armpitpete/merrin-voice-01/docs/v5.2-prototype-a-schematic-sheet-plan.md

# V5.2 — Prototype A Schematic Sheet Plan

## Status

Draft schematic-capture plan.

## Purpose

Define a hierarchical schematic structure that preserves the accepted V5.1 signal flow, safety boundaries, SMD-first construction, and Thonkiconn requirements.

This document does not create PCB placement or routing authority.

## Schematic hierarchy

```text
00_TOP
├── 01_POWER_PROTECTION
├── 02_MCU_CLOCK_DEBUG
├── 03_CODEC_CONVERSION
├── 04_INPUT_PRESSURE_ABSENCE
├── 05_MEMORY_GHOST_WET
├── 06_RETURN_BREAK_LIMITER
├── 07_OUTPUT_MUTE_PROTECTION
├── 08_CONTROLS_STATE
└── 09_TEST_SERVICE
```

Each child sheet must have one clear responsibility.

Cross-sheet connections must use explicit hierarchical labels. Hidden global labels are limited to power rails, ground/reference nets, reset/fault nets, and the audio clocks.

## 00_TOP — System hierarchy

### Purpose

- show the complete signal direction
- instantiate every functional sheet
- make safety paths visible
- show external connectors and top-level controls

### Top-level external ports

```text
AUDIO_IN
AUDIO_OUT
+12V_IN
-12V_IN
0V
RESET_CLEAR
SAFE_MUTE
STATE_LED
SWDIO
SWCLK
NRST
```

### Mandatory visible top-level signal route

```text
AUDIO_IN
  ↓
INPUT / PRESSURE / ABSENCE
  ├── PRESENT_DIRECT
  └── MEMORY_SUM → CODEC_ADC → DIGITAL CORE
                              ├── MEMORY_DAC
                              ├── GHOST_DAC
                              └── RETURN_DAC → BREAK / RETURN / LIMITER
                                                ├── RETURN_LIMITED → MEMORY_SUM
                                                └── ABSENCE_INFLUENCE
PRESENT_DIRECT + MEMORY/GHOST WET
  ↓
OUTPUT / SAFE MUTE
  ↓
AUDIO_OUT
```

The top sheet must not imply any raw Return bypass.

## 01_POWER_PROTECTION

### Purpose

Create and supervise the Prototype A power domains.

### Selected major parts

- TPS62160 for approximately 5.5 V pre-regulation
- TPS7A2050 for quiet 5 V codec analogue supply
- TPS62160 for 3.3 V digital supply
- TPS3808G33 supervisor
- TPS3431 watchdog

### Input rails

```text
+12V_RAW
-12V_RAW
0V
```

### Output rails

```text
+12VA
-12VA
+5V_CODEC_A
+3V3_D
+3V3_CODEC_D
```

`+3V3_CODEC_D` may be a filtered branch of `+3V3_D`; it is not a separately regulated rail unless schematic analysis requires it.

### Safety/control outputs

```text
PWR_GOOD_N
WATCHDOG_FAULT_N
SYSTEM_FAULT_N
HW_ATTENUATE
CODEC_RESET_N
MCU_RESET_N
```

### Required design details

- reverse-polarity protection
- supply-entry filtering
- regulator enable states
- current-limit-compatible bench bring-up
- local bulk capacitance
- regulator compensation/magnetics
- supervisor delay network
- independent watchdog timing network
- open-drain fault combination or equivalent safe logic
- labelled test points for every rail

### ERC rules

- no power-output conflict between regulators
- all regulator grounds/reference pins explicitly connected
- no unpowered logic input through a higher-voltage domain
- fault outputs have defined pull state
- no floating enable/reset pins

## 02_MCU_CLOCK_DEBUG

### Purpose

Implement STM32H743VIT6 processing, control, clocks, reset, and debug.

### Major part

```text
STM32H743VIT6 — LQFP-100
```

### Required interfaces

```text
SAI/TDM TX
SAI/TDM RX
MCLK
BCLK
LRCLK
CODEC_CTRL bus
MCP4728 I2C
CONTROL_ADC inputs
RESET_CLEAR input
SAFE_MUTE input
STATE_LED outputs
WATCHDOG_HEARTBEAT
CODEC_RESET_N
CODEC_MUTE
SWDIO
SWCLK
NRST
```

### Clocking

- HSE crystal/oscillator circuit selected during schematic capture
- MCU audio PLL generates audio clocks
- 48 kHz audio rate
- preferred 24.576 MHz MCLK, subject to codec clock-table verification
- 12.288 MHz BCLK for eight 32-bit TDM slots
- 48 kHz LRCLK

### Memory documentation note

Add a schematic note:

```text
2.0 s × 48 kHz × 32-bit mono = 384,000-byte AXI SRAM history buffer.
No external audio RAM on Prototype A.
```

### Required support

- all VDD/VSS pins shown or correctly represented in multi-unit symbol
- decoupling at every supply pin group
- VCAP capacitors per official MCU requirements
- VDDA/VREF handling explicit
- BOOT configuration explicit
- NRST supervisor/manual path explicit
- SWD connector/header
- watchdog heartbeat test point
- spare debug UART pads allowed as service-only, not panel I/O

### ERC rules

- no hidden unpowered MCU supply pins
- all boot/config pins have defined states
- unused GPIOs handled deliberately
- no 5 V signal reaches a non-tolerant MCU pin

## 03_CODEC_CONVERSION

### Purpose

Implement PCM3168A conversion, clocking, digital control, analogue biasing, and reconstruction/anti-alias boundaries.

### Major part

```text
PCM3168A — HTQFP-64
```

### Functional channel map

| Function | Assigned logical channel |
|---|---|
| ADC ingress | ADC1 |
| Memory output | DAC1 |
| Ghost output | DAC2 |
| Return send | DAC3 |

Exact left/right physical channel assignments must be stated in the schematic notes.

### Digital interfaces

```text
MCLK
BCLK
LRCLK
TDM_DOUT_TO_MCU
TDM_DIN_FROM_MCU
CODEC_CTRL
CODEC_RESET_N
CODEC_MUTE
```

### Analogue interfaces

```text
ADC_INGRESS_BIASED
MEMORY_DAC_RAW
GHOST_DAC_RAW
RETURN_DAC_RAW
CODEC_VCOM
```

### Required analogue sub-blocks

- ADC anti-alias and level/bias interface
- DAC reconstruction filter for Memory
- DAC reconstruction filter for Ghost
- DAC reconstruction filter for Return send
- AC coupling/0 V translation into ±12 V analogue domain
- local quiet 5 V analogue filtering
- local 3.3 V digital decoupling

### Unused-channel rule

Every unused ADC/DAC input/output is placed in the datasheet-defined safe state and documented.

No unused analogue input may float.

### ERC rules

- analogue and digital supply pins use correct power flags
- VCOM is not treated as a general system reference
- no ±12 V net directly reaches a codec pin
- reset/mute defaults are safe

## 04_INPUT_PRESSURE_ABSENCE

### Purpose

Implement the zero-centred analogue input path and produce both direct Present and Memory ingress.

### Major parts

- WQP518MA input Thonkiconn
- OPA1679 stages
- protection components selected during schematic work

### Signal path

```text
J1 AUDIO IN
  ↓
INPUT_PROTECTED
  ↓
INPUT_TRIMMED
  ↓
PRESSURE_OUT
  ↓
ABSENCE_OUT / SHAPED_PRESENT
  ├── PRESENT_DIRECT
  └── MEMORY_SUM
```

### Return input

```text
RETURN_LIMITED → MEMORY_SUM
```

No other Return net is permitted on this sheet.

### Controls

```text
INPUT_TRIM_POT
PRESSURE_POT
ABSENCE_POT
ABSENCE_INFLUENCE
```

### Mandatory test points

```text
TP_IN
TP_TRIM
TP_PRS
TP_ABS
TP_SUM
TP_ADCMON
```

### ERC/safety rules

- no floating input when J1 is empty
- switched contact behavior shown explicitly
- input protection survives the accepted ±12 V condition
- `RETURN_LIMITED` enters only through a bounded summing impedance
- `ABSENCE_INFLUENCE` cannot drive the Absence stage outside its safe control range

## 05_MEMORY_GHOST_WET

### Purpose

Receive reconstructed Memory and Ghost outputs, control their analogue levels, and create the wet mix.

### Major parts

- SSI2164 channels 1, 2, and 4
- MCP4728 channels A, B, and D
- OPA1679 reconstruction/mix stages as required

### Inputs

```text
MEMORY_DAC_RAW
GHOST_DAC_RAW
MCP_DAC_MEM
MCP_DAC_GHOST
MCP_DAC_WET
HW_ATTENUATE
```

### Outputs

```text
MEMORY_ANALOG
GHOST_ANALOG
WET_MIX
```

### Safety rule

`HW_ATTENUATE` must force all wet-related VCA channels to the datasheet-defined maximum attenuation without MCU participation.

### Mandatory test points

```text
TP_MEM
TP_GHOST
TP_WET
TP_VCA_MEM_CTRL
TP_VCA_GHOST_CTRL
TP_VCA_WET_CTRL
```

### ERC rules

- DAC control outputs never exceed SSI2164 control-input limits after scaling
- hardware attenuation clamp cannot be overridden by MCP4728 or MCU
- unused SSI2164 channels do not float

## 06_RETURN_BREAK_LIMITER

### Purpose

Implement the only legal path from Return DAC output back to Memory and Absence.

### Major parts

- SSI2164 channel 3
- MCP4728 channel C
- OPA1679 stages
- Break/nonlinear/limiter devices selected during schematic capture

### Mandatory path

```text
RETURN_DAC_RAW
  ↓
RETURN_LEVELLED
  ↓
BREAK_OUT
  ↓
RETURN_NONLINEAR
  ↓
RETURN_LIMITED
  ├── RETURN_FEED_TO_SUM
  └── ABSENCE_INFLUENCE
```

### Forbidden nets

The following direct paths are forbidden:

```text
RETURN_DAC_RAW → MEMORY_SUM
BREAK_OUT → MEMORY_SUM
RETURN_NONLINEAR → MEMORY_SUM
```

Only `RETURN_LIMITED` may leave the safety boundary.

### Mandatory test points

```text
TP_RETSEND
TP_BREAK
TP_RETURN_NONLINEAR
TP_RETLIM
TP_RETURN_CTRL
TP_ABSCTRL
```

### Safety notes

The schematic must contain a visible note:

```text
Normal maximum small-signal loop target ≈ 0.85.
Complete Return loop must remain bounded.
```

The limiter must remain effective during MCU/codec faults.

### ERC rules

- `HW_ATTENUATE` reaches Return VCA/clamp
- Return level control has a defined power-up state
- limiter rails/references remain powered when digital core faults
- `RETURN_LIMITED` is the only exported feedback-audio net

## 07_OUTPUT_MUTE_PROTECTION

### Purpose

Combine Present and wet paths, provide output level, suppress transients, and drive the output Thonkiconn.

### Major parts

- OPA1679 mix/output stages
- WQP518MA output Thonkiconn
- hardware mute/protection devices selected during schematic capture

### Signal path

```text
PRESENT_DIRECT
WET_MIX
  ↓
FINAL_MIX
  ↓
OUTPUT_LEVEL
  ↓
OUTPUT_SAFE
  ↓
J2 AUDIO OUT
```

### Control inputs

```text
SAFE_MUTE
SYSTEM_FAULT_N
```

### Mandatory test points

```text
TP_MIX
TP_OUT_PREMUTE
TP_OUT
TP_MUTE
```

### Safety rules

- normal output no greater than 10 Vpp
- known muted or controlled state at power-on
- controlled release avoids full-scale click
- output remains protected against reasonable patching faults
- output Thonkiconn sleeve follows the documented analogue-ground strategy

## 08_CONTROLS_STATE

### Purpose

Connect panel controls, MCP4728, buttons, and SLS-1 indication.

### Major parts

- MCP4728 — MSOP-10
- control pots and switches
- state LED drivers/components

### MCU-scanned controls

```text
MEM_TIME
MEM_FADE
MEM_BLUR
GHOST_DISTANCE
GHOST_DRIFT
GHOST_PRESENCE
RETURN_AMOUNT
PRESENT_WET
```

### Direct analogue controls

```text
INPUT_TRIM
PRESSURE
ABSENCE
BREAK
OUTPUT_LEVEL
```

### Digital controls

```text
RESET_CLEAR
SAFE_MUTE
```

### MCP4728 allocation

| Channel | Function |
|---|---|
| A | Memory level |
| B | Ghost level |
| C | Return level |
| D | Wet master |

### SLS-1 states

```text
IDLE
ACTIVE
WARNING
ERROR
```

### Safety rules

- MCP4728 cannot release hardware attenuation before SAFE-01 permits it
- stored DAC values must not create an unsafe power-up state
- pots have defined ADC states if disconnected
- LED meaning does not rely on colour alone

## 09_TEST_SERVICE

### Purpose

Collect service headers, test points, current measurement options, and bring-up notes without exposing them as performance controls.

### Required access

```text
all V5.1 analogue test points
+12VA
-12VA
+5V_CODEC_A
+3V3_D
3V3_CODEC_D
SYSTEM_FAULT_N
WATCHDOG_FAULT_N
PWR_GOOD_N
HW_ATTENUATE
CODEC_RESET_N
MCU_RESET_N
MCLK
BCLK
LRCLK
```

### Service connectors

- SWD header
- optional debug UART pads
- current-measurement links or zero-ohm options for major power branches
- codec control-bus probe pads
- watchdog heartbeat probe pad

These are not panel functions.

## Net-naming rules

### Audio

```text
AUDIO_IN_RAW
INPUT_PROTECTED
INPUT_TRIMMED
PRESSURE_OUT
SHAPED_PRESENT
PRESENT_DIRECT
MEMORY_SUM
ADC_INGRESS
MEMORY_DAC_RAW
GHOST_DAC_RAW
RETURN_DAC_RAW
MEMORY_ANALOG
GHOST_ANALOG
WET_MIX
BREAK_OUT
RETURN_NONLINEAR
RETURN_LIMITED
FINAL_MIX
OUTPUT_SAFE
```

### Control/safety

```text
ABSENCE_INFLUENCE
HW_ATTENUATE
SAFE_MUTE
SYSTEM_FAULT_N
PWR_GOOD_N
WATCHDOG_FAULT_N
CODEC_RESET_N
CODEC_MUTE
MCU_RESET_N
RESET_CLEAR
```

### Clocks/buses

```text
AUDIO_MCLK
AUDIO_BCLK
AUDIO_LRCLK
AUDIO_TDM_TX
AUDIO_TDM_RX
CODEC_CTRL
CTRL_I2C_SCL
CTRL_I2C_SDA
```

## Symbol and footprint gates

Before a symbol is accepted:

- pin numbers checked against official datasheet
- all power/ground pins accounted for
- exposed pad behavior documented
- active-low names use `_N`
- multi-unit parts have explicit power unit where needed

Before a footprint is associated:

- package drawing checked against official manufacturer drawing
- pin-1 orientation checked
- thermal/exposed pad checked
- courtyard and assembly clearances reviewed
- hand/reflow assembly method stated

For WQP518MA:

- exact switched-contact pins verified
- footprint dimensions checked against the current manufacturer drawing
- panel axis and nut clearance recorded

## ERC acceptance rules

ERC must pass with no unexplained:

- unconnected required pins
- power-input-without-source warnings
- output-to-output conflicts
- floating analogue inputs
- unpowered logic/control pins
- unnamed feedback paths
- active-low reset nets without defined pull state

Intentional exceptions must be recorded in a schematic review note, not silently excluded.

## Schematic review order

Review in this sequence:

1. power and reset
2. MCU/clock/debug
3. codec supplies and clocks
4. input and direct Present path
5. converter boundaries
6. Memory/Ghost wet path
7. Return/Break/limiter path
8. output mute/protection
9. controls and LEDs
10. test/service access
11. whole-system ERC
12. independent Return-safety review

## Stop rule

Schematic capture is not accepted until:

```text
[ ] all sheets exist
[ ] every hierarchical port is connected once in the intended direction
[ ] direct Present works without the digital core
[ ] only RETURN_LIMITED feeds Memory/Absence
[ ] hardware attenuation is independent of firmware
[ ] codec clock mode is verified
[ ] power-up/reset sequence is explicit
[ ] all exact packages/footprints are verified
[ ] ERC passes with documented exceptions only
```

PCB placement and routing remain forbidden until this review is complete.
