armpitpete/merrin-voice-01/hardware/memory-core-prototype-a/00_TOP_FINAL_INTEGRATED_REVIEW.md

# 00_TOP — Final Integrated Schematic Review

## Status

```text
ALL NINE COMPONENT SHEETS CAPTURED: PASS
PARENT / CHILD INTERFACE RECONCILIATION: PASS
45-NET PROVIDER / CONSUMER COVERAGE: PASS
RESTRICTED SHEET BOUNDARIES: PASS
SHARED U60 / U32 DEVICE OWNERSHIP: PASS
TEMPORARY HARNESS REMOVAL: PASS
KICAD 10 HIERARCHICAL ERC: PASS — 0 ERRORS / 0 WARNINGS
FIRST PASSING FINAL ARTIFACT PROMOTED: PASS
COMMITTED-FILE FINAL RERUN: PASS — RECONCILIATION / PROMOTION SKIPPED
PR #45 SCHEMATIC ACCEPTANCE REVIEW: COMPLETE
PCB / FOOTPRINT / FABRICATION AUTHORITY: NOT GRANTED
```

## Review scope

This review closes the V5.2 native component-level schematic-capture lane only. It does not accept footprints, placement, routing, fabrication, purchasing, panel mechanics, fixtures or measured hardware behaviour.

Reviewed hierarchy:

```text
00_TOP
├── 01_POWER_PROTECTION
├── 02_MCU_CLOCK_DEBUG
├── 03_CODEC_CONVERSION
├── 04_INPUT_PRESSURE_ABSENCE
├── 05_MEMORY_GHOST_WET
├── 06_RETURN_BREAK_LIMITER
├── 07_OUTPUT_MUTE_PROTECTION
├── 08_CONTROLS_STATE
└── 09_TEST_SERVICE
```

All nine component-sheet capture markers are present.

## Parent and child interface reconciliation

The final review found that the pinned schematic API had serialised several early child-sheet output and bidirectional labels as `input`, even though the top-level sheet pins and manifest were correct.

The passing final artifact repairs only the named hierarchy shapes on:

```text
01_POWER_PROTECTION        5 labels
02_MCU_CLOCK_DEBUG        14 labels
04_INPUT_PRESSURE_ABSENCE  3 labels
08_CONTROLS_STATE         16 labels
```

After repair:

- every top-level sheet pin matches the committed manifest;
- every child hierarchical label matches the same name and direction;
- each hierarchy label is unique within its sheet;
- all 45 hierarchy nets have at least one provider and at least one consumer.

## Restricted boundaries

The final validator explicitly enforces:

```text
04 outputs: DIRECT_PRESENT, SHAPED_PRESENT, ADC_ANALOG_IN
05 outputs: WET_MIX only
06 outputs: RETURN_LIMITED, RETURN_FEED, ABSENCE_INFLUENCE only
07 outputs: none
09 outputs: none
```

Raw Return, Break, clamp, SSI2164 current, wet-sum, mute, output-protection and service-probe nodes remain local to their owning sheets.

## Shared physical devices

The reusable validators passed the integrated multi-unit ownership contracts:

```text
U60 / SSI2164
  sheet 05: units 1, 2, 4
  sheet 06: units 3, 5
  one physical five-unit device

U32 / OPA1679
  sheet 03: units 1, 5
  sheet 07: units 2, 3, 4
  one physical five-unit device
```

The complete Prototype A OPA1679 allocation remains seven physical packages. No duplicate U60 or U32 package is created.

## Temporary-harness closure

The final validator rejects:

```text
SHEET_INTERFACE_NOT_FITTED
Temporary hierarchy/ERC harness
INTERFACE CAPTURE ONLY
former J901–J909 harness references
visible staged SSI2164 reservations
```

No such token or former harness reference remains in the top schematic or any child sheet.

The top schematic now states that all nine component sheets are captured. The hierarchy manifest now records:

```text
stage: component-capture-complete
temporary_interface_harnesses: false
component_sheets_captured: true
```

## Integrated Return safety review

Static schematic-stage Return safeguards remain intact:

- post-codec Return gain is normalised by the sheet-06 one-third divider;
- U60 channel 3 retains official pins `15 IIN3`, `14 VC3`, `13 IOUT3`;
- bounded Break and independent dual-polarity limiter remain before `RETURN_LIMITED`;
- `RETURN_FEED` remains a fixed `27.4 kΩ / 40.2 kΩ` branch;
- sheet 04 accepts only `RETURN_FEED` and `ABSENCE_INFLUENCE` from sheet 06;
- raw Return, Break, clamp and limiter-reference nodes remain local;
- sheet 07 receives `WET_MIX`, not an unbounded internal Return node;
- sheet 09 observes Return signals only through read-only isolated probes.

This is a static schematic review. Measured loop gain, limiter thresholds and recovery, worst-setting endurance, fault response and output behaviour remain mandatory later bench gates.

## Verification evidence

The final integrated workflow passed:

- all reusable component-sheet validators;
- U60 and U32 shared-device validators;
- provisional control-symbol validators;
- test/service read-only boundary validator;
- parent-sheet and child-label reconciliation;
- provider/consumer coverage for all 45 hierarchy nets;
- restricted output-boundary checks;
- temporary-harness removal checks;
- KiCad CLI `10.0.4` hierarchical ERC;
- final zero-error and zero-warning policy.

ERC result:

```text
0 errors
0 warnings
```

The first passing final-review artifact was promoted in commit `5d2b325`.

The required committed-file rerun subsequently detected `00_TOP_FINAL_REVIEW_COMPLETE`, skipped reconciliation and promotion, and passed all component and integration validators plus KiCad ERC directly against the committed native files.

## Validation boundary

The final gate proves native hierarchy, interface direction, shared-device ownership, selected design contracts and KiCad ERC. It does not prove exact analogue behaviour, component spread, rail sequencing, mute depth, loop stability, load drive, external-fault current or endurance.

Those transferred exact-part, footprint and bench gates are recorded in `PR45_SCHEMATIC_ACCEPTANCE_REVIEW.md`.

## Remaining blocked work

- every active-device and connector footprint review;
- PCB placement and routing;
- fabrication outputs and purchasing;
- panel, jack, control and service-fixture mechanics;
- measured power, codec, VCA, Return, limiter, mute and output performance;
- integrated loop stability and endurance testing;
- firmware resource, timing, register and fault-sequence proof;
- oscillator, voice-source, MIDI/CV, sequencer and demo expansion.

`00_TOP` is closed at schematic-capture level. PR #45 is accepted as a reviewed prototype schematic candidate with a deliberate squash merge recommended after human review. Exact-part and footprint verification remains a separate later lane.
