armpitpete/merrin-voice-01/docs/v5.2-power-and-analogue-preflight-register.md

# V5.2 — Power and Analogue Preflight Register

## Status

Calculation pass complete for schematic preparation.

Footprint, native schematic, ERC and physical bench checks remain open.

PCB placement, routing, fabrication and purchasing remain blocked.

## Rail budget

| Rail | Locked design allocation | Status |
|---|---:|---|
| +12 V complete prototype input | 425 mA | Calculated for schematic preparation |
| −12 V complete prototype input | 110 mA | Calculated for schematic preparation |
| +12 V analogue core | 100 mA | Calculated for schematic preparation |
| −12 V analogue core | 100 mA | Calculated for schematic preparation |
| approximately 5.453 V pre-rail | 265 mA | Calculated for schematic preparation |
| quiet 5 V | 265 mA | Calculated for schematic preparation |
| 3.3 V | 500 mA | Calculated for schematic preparation |

Evidence:

- `docs/v5.2-power-current-and-thermal-budget.md`

## Regulator starting points

### 3.3 V rail

```text
RTOP = 374 kΩ
RBOTTOM = 120 kΩ
nominal VOUT = 3.293 V
L = 2.2 µH
CIN = 10 µF local minimum target
COUT = 22 µF effective target
at 500 mA:
  ΔIL ≈ 0.483 A
  IPEAK ≈ 0.741 A
  IVALLEY ≈ 0.259 A
```

### Quiet-5 V pre-rail

```text
RTOP = 698 kΩ
RBOTTOM = 120 kΩ
nominal VOUT = 5.453 V
L = 3.3 µH
CIN = 10 µF local minimum target
COUT = 22 µF effective target
at 265 mA:
  ΔIL ≈ 0.401 A
  IPEAK ≈ 0.465 A
  IVALLEY ≈ 0.065 A
```

The 3.3 µH correction prevents the first-pass quiet pre-rail calculation from crossing into discontinuous inductor current at the design load.

## Quiet 5 V LDO

```text
PCM3168A analogue maximum = 210 mA
design load = 265 mA
pre-rail = 5.453 V
LDO output = 5.000 V
headroom = 0.453 V
first-pass dissipation at 265 mA ≈ 0.120 W
first-pass junction-rise estimate ≈ 22.5 °C
```

Open before PCB acceptance:

- exact regulator-reference/tolerance check;
- capacitor DC-bias and inductor verification;
- copper-dependent thermal result;
- measured ripple/noise.

## ±12 V analogue current

```text
7 × OPA1679
28 channels
OPA current:
  typical = 56.0 mA per rail
  worst = 78.4 mA per rail
SSI2164 maximum ≈ 8 mA per rail
analogue-core allowance = 100 mA per rail
```

Evidence:

- `docs/v5.2-return-limiter-and-opamp-allocation.md`

## SSI2164 and MCP4728 safety

```text
SSI gain_dB ≈ −VC / 0.033 V
0 V = unity
+3.3 V ≈ maximum attenuation
negative VC forbidden
```

TMUX1574 selects:

```text
safe/default = +3.3 V attenuation reference
normal = MCP4728 output
```

MCP4728 safe EEPROM request:

```text
VREF = VDD
GAIN = 1
normal mode
all four codes = 0xFFF
```

The hardware selector remains authoritative.

Evidence:

- `docs/v5.2-ssi2164-mcp4728-fail-safe-control.md`
- `docs/v5.2-component-architecture-amendment-safe-selector.md`

## Return limiter

Corrected contract:

```text
combined small-signal gain from core Return source
through DAC-R, Break and analogue Return to RETURN_LIMITED
≤ 1.000
```

Hard boundary:

```text
RET-01
→ 2.2 kΩ
→ clamp to buffered ±2.5 V references
→ RETURN_LIMITED
→ fixed feed:
   RIN = 40.2 kΩ
   RF = 27.4 kΩ
   nominal = 0.6816
   1% worst-case ≈ 0.6954
```

Therefore calculated normal loop gain remains below 0.70 and below the accepted 0.85 ceiling.

Conservative headroom check:

```text
5.6 Vpp clamp × 0.6816 = 3.82 Vpp Return
3.82 Vpp Return + 2.00 Vpp Present = 5.82 Vpp
```

This stays below the 6 Vpp internal headroom target.

Evidence:

- `docs/v5.2-return-limiter-and-opamp-allocation.md`

Open:

- native gain table;
- measured clamp and loop gain;
- 30-minute worst-setting endurance.

## Watchdog and supervisor

```text
TPS3808 reset-delay target ≈ 300 ms nominal
TPS3431 watchdog target ≈ 200 ms nominal
TPS3431 window ≈ 170–230 ms
```

Interpretation:

```text
20 ms = asserted fault to suppression
not MCU-hang detection latency
```

Evidence:

- `docs/v5.2-supervisor-watchdog-and-thonkiconn-proof.md`
- `docs/v5.2-ssi2164-mcp4728-fail-safe-control.md`

## WQP518MA

Accepted electrically:

```text
pin 1 sleeve
pin 2 tip
pin 3 normally-connected tip switch
```

Open before PCB:

- native symbol/footprint cross-check;
- barrel keepout/hole;
- panel alignment and hardware stack;
- physical sample measurement.

## Schematic-preparation closure

```text
[x] Current and thermal targets explicit.
[x] Corrected regulator starting values explicit.
[x] OPA1679 package/current count explicit.
[x] SSI2164 safe range explicit.
[x] Hardware selector explicit.
[x] MCP4728 startup intent explicit.
[x] Watchdog timing distinction explicit.
[x] Corrected Return-loop calculation explicit.
[x] WQP518MA switching explicit.
```

Native hierarchical schematic capture may begin after this pass is accepted.

PCB work remains blocked until schematic/ERC, exact footprint checks, remaining risk closure and independent Return review are complete.
