armpitpete/merrin-voice-01/docs/v5.2-component-selection-risk-register.md

# V5.2 — Component-Selection Risk Register

## Status

Active schematic-preparation and pre-PCB register.

No closure in this file authorises PCB placement, routing, fabrication or purchasing.

## Current status

| Risk | Subject | Status |
|---|---|---|
| R1 | PCM3168A clock/configuration | **Closed for schematic preparation** |
| R2 | STM32 SRAM/DMA placement | Open — firmware evidence required |
| R3 | SSI2164 attenuation/range | **Closed for schematic preparation** |
| R4 | MCP4728 startup/EEPROM | **Closed for schematic preparation** |
| R5 | TPS3431 timing/package | Timing role conditional; footprint/assembly open |
| R6 | quiet-5 V rail margin | **Closed for schematic preparation** |
| R7 | 3.3 V current budget | **Closed for schematic preparation** |
| R8 | WQP518MA switching/footprint | Symbol/switching closed; footprint/mechanical open |
| R9 | OPA1679 count/current | **Closed for schematic preparation** |
| R10 | STM32H743 pin allocation | **Closed for schematic preparation** |
| R11 | unused PCM3168A channels | Digital state closed; analogue treatment open |
| R12 | Return limiter | Calculation closed; schematic/bench proof open |

## R1 — PCM3168A clock/configuration

Closed for schematic preparation.

```text
48 kHz LRCLK
12.288 MHz BCLK
24.576 MHz MCLK
8 × 32-bit TDM
PCM3168A address 0x44
```

Evidence:

- `docs/v5.2-pcm3168a-clock-and-interface-proof.md`
- `docs/v5.2-mcu-pin-and-codec-cross-check.md`

Bring-up must still prove generated SAI timing and codec register readback.

## R2 — STM32 SRAM/DMA placement

Open.

Required:

- reserve the 384,000-byte history explicitly;
- place DMA buffers in DMA-accessible SRAM;
- prove stack/heap/work buffers fit;
- retain at least 64 KB uncommitted margin after first complete link.

## R3 — SSI2164 safety

Closed for schematic preparation.

```text
gain_dB ≈ −VC / 0.033 V
0 V = unity
+3.3 V ≈ maximum attenuation
normal control range = 0 to +3.3 V
negative VC forbidden
```

TMUX1574 defaults the four SSI controls to +3.3 V and selects MCP4728 only after safe release.

Evidence:

- `docs/v5.2-ssi2164-mcp4728-fail-safe-control.md`
- `docs/v5.2-component-architecture-amendment-safe-selector.md`

## R4 — MCP4728 startup

Closed for schematic preparation.

Safe EEPROM request:

```text
VREF = VDD
GAIN = 1
normal mode
code = 0xFFF on all channels
```

The hardware selector remains authoritative; EEPROM is secondary.

## R5 — TPS3431 timing/package

Partially closed.

Accepted:

```text
TPS3431 = slower independent hang watchdog
nominal timeout ≈ 200 ms
published window ≈ 170–230 ms
20 ms requirement = asserted fault to suppression
```

Open before PCB:

- exact VSON land pattern;
- exposed-pad/stencil process;
- WDI/WDO test points;
- assembly functional test.

Evidence:

- `docs/v5.2-ssi2164-mcp4728-fail-safe-control.md`
- `docs/v5.2-supervisor-watchdog-and-thonkiconn-proof.md`

## R6 — quiet-5 V rail

Closed for schematic preparation.

```text
PCM3168A analogue maximum = 210 mA
design load = 265 mA
pre-rail nominal = 5.453 V
LDO output = 5.000 V
headroom = 0.453 V
first-pass LDO dissipation ≈ 0.120 W
first-pass temperature rise ≈ 22.5 °C
pre-regulator inductor = 3.3 µH
at design load:
  ΔIL ≈ 0.401 A
  IPEAK ≈ 0.465 A
  IVALLEY ≈ 0.065 A
```

The 3.3 µH correction keeps the first-pass quiet pre-rail in continuous conduction at the design load.

Open before PCB:

- exact regulator-reference tolerance;
- selected magnetics/capacitor derating;
- copper-dependent thermal check.

Evidence:

- `docs/v5.2-power-current-and-thermal-budget.md`

## R7 — 3.3 V rail

Closed for schematic preparation.

```text
calculated subtotal ≈ 371.6 mA
design load = 500 mA
RTOP = 374 kΩ
RBOTTOM = 120 kΩ
nominal VOUT = 3.293 V
L = 2.2 µH
at design load:
  ΔIL ≈ 0.483 A
  IPEAK ≈ 0.741 A
  IVALLEY ≈ 0.259 A
```

The MCU assumption is 300 MHz VOS2 and prototype ambient no higher than 85 °C without reopening R7.

## R8 — WQP518MA

Electrical symbol/switching closed for schematic preparation.

```text
pin 1 sleeve
pin 2 tip
pin 3 normally-connected tip switch
no plug: pins 2 and 3 connected
plug inserted: pins 2 and 3 open
```

Open before PCB:

- native symbol/footprint check against current manufacturer drawing;
- barrel keepout/hole;
- panel and nut/washer clearances;
- physical sample measurement.

An incomplete community library is reference-only.

## R9 — OPA1679 count/current

Closed for schematic preparation.

```text
7 × OPA1679
28 provisional assigned channels
56.0 mA per rail typical
78.4 mA per rail worst-case
```

Native schematic accounting must confirm the 28-channel plan. No extra package is authorised silently.

Evidence:

- `docs/v5.2-return-limiter-and-opamp-allocation.md`
- `docs/v5.2-power-current-and-thermal-budget.md`

## R10 — MCU pin allocation

Closed for schematic preparation.

```text
PE2–PE6   SAI1 audio
PB8/PB9   I2C1
PA0–PA7   panel ADC
PD8–PD15  safety/user controls
PC6–PC9   SLS-1
PH0/PH1   HSE
PA13/PA14 SWD
NRST       reset
```

Evidence:

- `docs/v5.2-mcu-pin-allocation-register.md`
- `docs/v5.2-mcu-pin-and-codec-cross-check.md`

## R11 — unused codec channels

Digital state closed; analogue treatment open.

- DAC4 zero/muted;
- DAC5–8 muted/power-save;
- ADC2 muted;
- ADC3–6 muted/power-save.

Native schematic must terminate unused analogue inputs correctly and prove no unused output reaches a mixer.

## R12 — Return limiter

Calculation closed for schematic preparation; schematic and bench proof open.

Corrected requirements:

```text
combined small-signal transfer from core Return source
through DAC-R, Break and analogue Return to RETURN_LIMITED
≤ 1.000
```

Hard boundary:

```text
RET-01
→ 2.2 kΩ
→ dual-polarity clamp to buffered ±2.5 V references
→ RETURN_LIMITED
→ fixed feed:
   RIN = 40.2 kΩ
   RF = 27.4 kΩ
   nominal = 0.6816
   1% worst-case ≈ 0.6954
```

SSI Return control cannot exceed unity, so calculated loop gain remains below 0.70 and below the accepted 0.85 ceiling.

Headroom check:

```text
5.6 Vpp clamp × 0.6816 = 3.82 Vpp Return
3.82 Vpp + 2.00 Vpp Present = 5.82 Vpp
```

This remains below the 6 Vpp internal target.

Open:

- native small-signal gain table;
- measured clamp/loop gain;
- 30-minute worst-setting endurance.

Evidence:

- `docs/v5.2-return-limiter-and-opamp-allocation.md`

## Closure gate before PCB work

```text
[x] R1  codec clock/configuration
[ ] R2  SRAM/DMA firmware placement
[x] R3  SSI2164 safety for schematic
[x] R4  MCP4728 startup for schematic
[~] R5  timing role accepted; footprint/assembly open
[x] R6  quiet-rail calculation
[x] R7  3.3 V budget
[~] R8  symbol/switch accepted; footprint/mechanical open
[x] R9  OPA count/current for schematic
[x] R10 MCU pin allocation
[~] R11 digital state closed; analogue treatment open
[~] R12 calculation closed; schematic/bench proof open
```

PCB placement and routing remain forbidden until all hardware-relevant open items are closed or transferred to a bounded pre-PCB verification task.
