armpitpete/merrin-voice-01/docs/v5.0-smd-construction-rule.md

# V5.0 — SMD Construction Rule

## Status

Locked hardware requirement.

## Core rule

Merrin Grief Synth circuit boards must use surface-mount electronic components by default.

```text
Electronic circuitry = SMD-first.
Panel and mechanical hardware = through-hole only where appropriate.
```

This rule applies to:

- Memory Core Prototype A
- later analogue Present-path boards
- Memory / Ghost / Return processing boards
- Absence / Pressure / Break circuitry
- control-scanning and state-light circuitry
- later internal voice-source boards
- production-intent revisions unless a documented exception is approved

## Locked jack choice

The default 3.5 mm audio/CV jack family is:

```text
Thonkiconn PCB-mount jack
```

This applies to Memory Core Prototype A and later Eurorack-style or patchable Merrin Grief Synth hardware.

Use Thonkiconns for:

- audio input
- audio output
- later CV input/output
- normalled or switched patch points where the circuit requires them

This locks the connector family and mechanical approach only.

It does not yet select:

- an exact manufacturer stock code
- an exact switched-contact variant
- an exact footprint
- an exact supplier

Those choices remain part of schematic/component selection.

Before PCB routing, the selected Thonkiconn variant must be checked for:

- verified footprint dimensions
- switched-contact pin behaviour
- jack orientation
- panel-hole alignment
- nut and washer clearance
- adjacent-control clearance
- insertion/removal mechanical load

A different jack may be used only when:

- the final physical format is not compatible with Thonkiconns
- a different connector is required for mechanical strength
- the circuit requires a connection type the chosen Thonkiconn cannot provide
- supply or manufacturing constraints make the part impractical

Any replacement must be documented rather than silently substituted.

## Why

SMD construction is the intended build method because it supports:

- compact circuit boards
- shorter signal paths
- repeatable assembly
- easier transition to assembled PCB production
- reduced dependence on large through-hole footprints
- realistic integration of digital audio, memory, conversion, and control circuitry

## Allowed through-hole exceptions

Through-hole parts are allowed where they are mechanically or practically superior.

Typical exceptions include:

- panel potentiometers
- Thonkiconn audio and CV jacks
- switches
- encoders
- power connectors
- board-to-panel connectors
- programming or service headers
- test points
- components requiring mechanical anchoring
- parts unavailable in a practical SMD package
- unusually high-power or high-heat parts where the circuit design justifies it

An exception must be based on engineering or repairability, not habit.

## Package-size principle

V5.0 does not select exact footprints yet.

When footprint selection begins, prefer SMD packages that remain realistic to prototype, inspect, and repair.

The design should not use unnecessarily tiny packages merely to reduce board size.

The later schematic/PCB lane must explicitly choose a buildability target, such as:

- hand-assembly friendly
- hot-plate/reflow friendly
- assembly-service friendly

Exact choices such as 0805, 0603, SOIC, TSSOP, QFN, or other packages remain deferred until circuit and component selection.

## PCB rule

When PCB work begins:

- SMD components should be placed on one side where practical for easier prototype assembly
- panel hardware may occupy the opposite side if the mechanical design requires it
- test points must remain accessible
- programming/debug access must not be buried under panel hardware
- high-stress connectors must have adequate mechanical support
- Thonkiconn jack footprints and panel alignment must be verified before routing
- serviceability must not be sacrificed solely for density

## Prototype A requirement

Memory Core Prototype A must be designed as an SMD-first board.

Prototype A may use temporary through-hole development headers, panel controls, and jacks, but the actual signal-processing and control circuitry must target SMD implementation.

A breadboard or large through-hole proof may be used only for a narrow bench experiment. It must not become the default hardware architecture or final board design.

## Relationship to V5.0

This rule does not select active components or begin PCB layout.

It constrains all later choices:

```text
V5.0 architecture
↓
V5.1 circuit-block design
↓
schematic/component selection using SMD-first rule
↓
KiCad PCB design
```

## Acceptance rule

A later schematic or PCB is non-compliant unless:

- electronic circuitry is SMD-first
- through-hole exceptions are documented
- Thonkiconn is used for 3.5 mm patch/audio connections unless an exception is documented
- the exact jack variant and footprint are verified before routing
- mechanical parts remain physically robust
- the board remains prototypeable and repairable
