armpitpete/merrin-voice-01/hardware/memory-core-prototype-a/01_POWER_PROTECTION.kicad_sch

## KiCad design hardware/memory-core-prototype-a/01_POWER_PROTECTION.kicad_sch (2026-07-14)

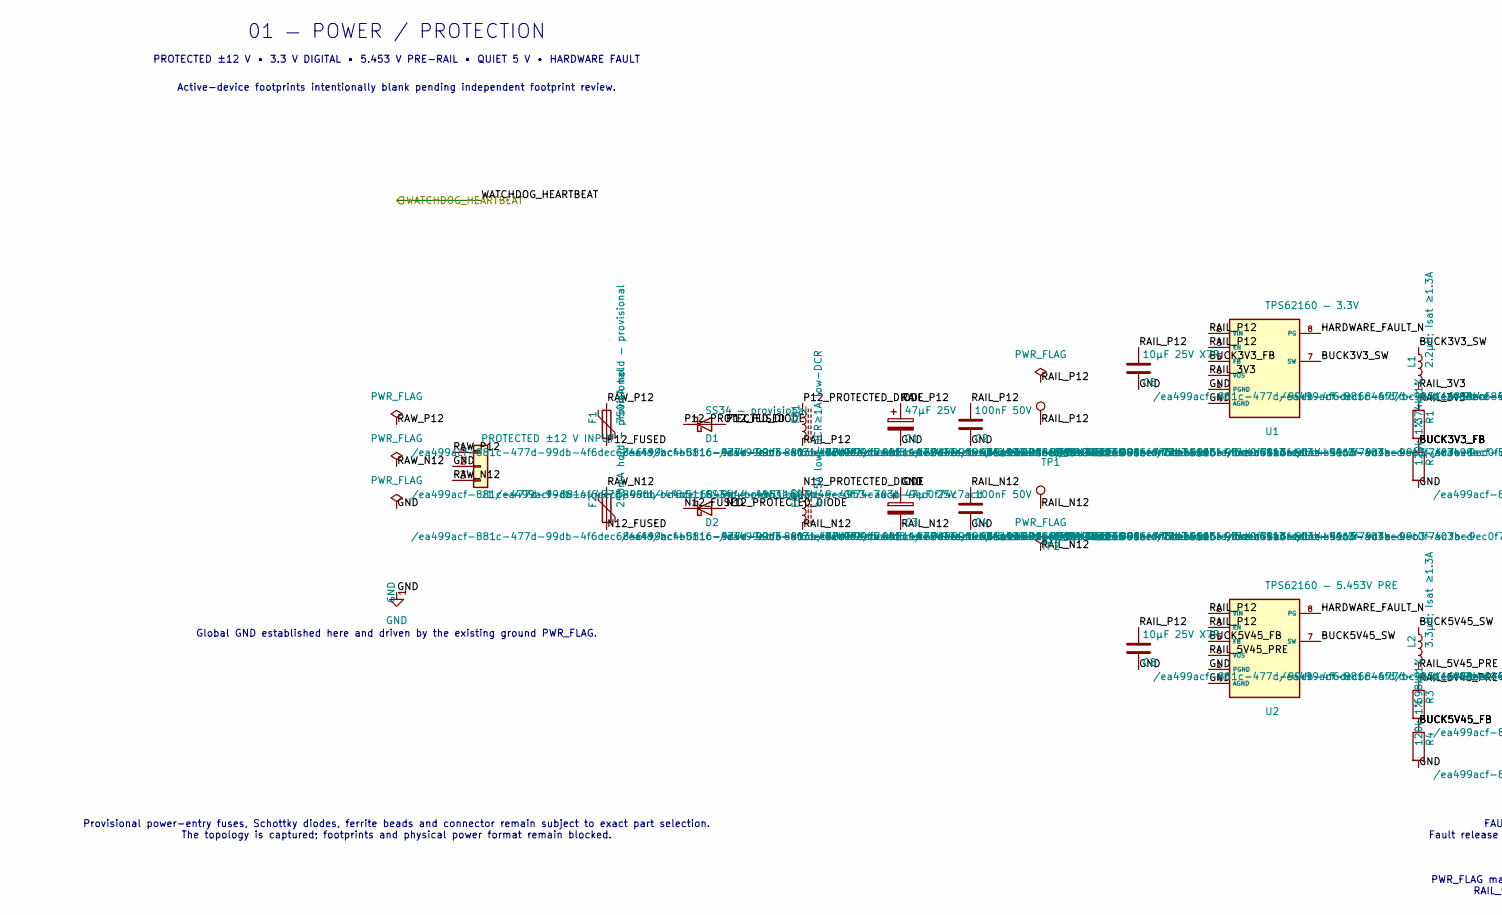
[picture p1: schematic 01_POWER_PROTECTION.kicad_sch, part in row 1, column 1]

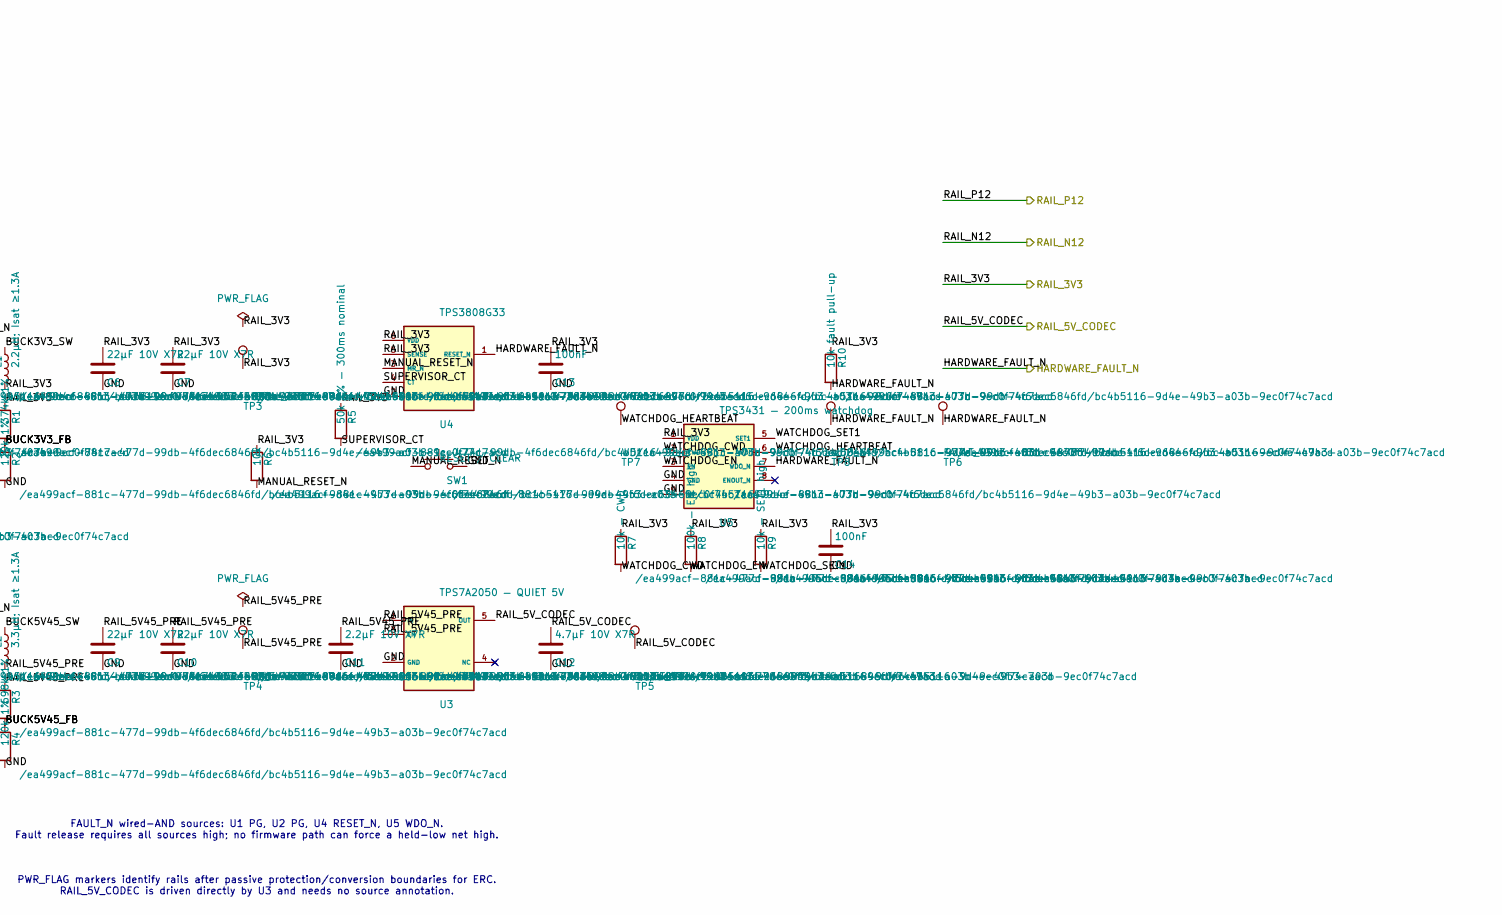
[picture p2: schematic 01_POWER_PROTECTION.kicad_sch, part in row 1, column 2]

Parts:
C1, C3: 47µF 25V; C_1210_3225Metric
C2, C4: 100nF 50V; C_0805_2012Metric
C5, C8: 10µF 25V X7R; C_1206_3216Metric
C6, C7, C9, C10: 22µF 10V X7R; C_1206_3216Metric
C11: 2.2µF 10V X7R; C_0805_2012Metric
C12: 4.7µF 10V X7R; C_0805_2012Metric
C13, C14: 100nF; C_0805_2012Metric
D1, D2: SS34 — provisional
F1: 750mA hold — provisional
F2: 250mA hold — provisional
FB1: ≥1A low-DCR
FB2: ≥0.5A low-DCR
J1: PROTECTED ±12 V INPUT
L1: 2.2µH; Isat ≥1.3A
L2: 3.3µH; Isat ≥1.3A
R1: 374k 1%; R_0805_2012Metric
R2, R4: 120k 1%; R_0805_2012Metric
R3: 698k 1%; R_0805_2012Metric
R5: 50k 1% — 300ms nominal; R_0805_2012Metric
R6: 10k; R_0805_2012Metric
R7: 10k — CWD; R_0805_2012Metric
R8: 100k — EN high; R_0805_2012Metric
R9: 10k — SET1 high; R_0805_2012Metric
R10: 10k fault pull-up; R_0805_2012Metric
SW1: RESET / CLEAR
TP1: P12_PROTECTED
TP2: N12_PROTECTED
TP3: DIGITAL_3V3
TP4: PRE_5V453
TP5: QUIET_5V
TP6: FAULT_N
TP7: WDI
TP8: WDO_N
U1: TPS62160 — 3.3V
U2: TPS62160 — 5.453V PRE
U3: TPS7A2050 — QUIET 5V
U4: TPS3808G33
U5: TPS3431 — 200ms watchdog

Connections:
BUCK3V3_FB: R1.2, R2.1, U1.5 (FB)
BUCK3V3_SW: L1.1, U1.7 (SW)
BUCK5V45_FB: R3.2, R4.1, U2.5 (FB)
BUCK5V45_SW: L2.1, U2.7 (SW)
GND: C1.2, C2.2, C3.1, C4.2, C5.2, C6.2, C7.2, C8.2, C9.2, C10.2, C11.2, C12.2, C13.2, C14.2, J1.2, R2.2, R4.2, SW1.2, U1.1 (PGND), U1.4 (AGND), U2.1 (PGND), U2.4 (AGND), U3.2 (GND), U4.2 (GND), U5.4 (GND), U5.9 (EP)
HARDWARE_FAULT_N: R10.2, TP6.1, TP8.1, U1.8 (PG), U2.8 (PG), U4.1 (RESET_N), U5.7 (WDO_N)
MANUAL_RESET_N: R6.2, SW1.1, U4.3 (MR_N)
N12_FUSED: D2.1 (K), F2.2
N12_PROTECTED_DIODE: D2.2 (A), FB2.1
P12_FUSED: D1.2 (A), F1.2
P12_PROTECTED_DIODE: D1.1 (K), FB1.1
RAIL_3V3: C6.1, C7.1, C13.1, C14.1, L1.2, R1.1, R5.1, R6.1, R7.1, R8.1, R9.1, R10.1, TP3.1, U1.6 (VOS), U4.5 (SENSE), U4.6 (VDD), U5.1 (VDD)
RAIL_5V45_PRE: C9.1, C10.1, C11.1, L2.2, R3.1, TP4.1, U2.6 (VOS), U3.1 (IN), U3.3 (EN)
RAIL_5V_CODEC: C12.1, TP5.1, U3.5 (OUT)
RAIL_N12: C3.2, C4.1, FB2.2, TP2.1
RAIL_P12: C1.1, C2.1, C5.1, C8.1, FB1.2, TP1.1, U1.2 (VIN), U1.3 (EN), U2.2 (VIN), U2.3 (EN)
RAW_N12: F2.1, J1.3
RAW_P12: F1.1, J1.1
SUPERVISOR_CT: R5.2, U4.4 (CT)
WATCHDOG_CWD: R7.2, U5.2 (CWD)
WATCHDOG_EN: R8.2, U5.3 (EN)
WATCHDOG_HEARTBEAT: TP7.1, U5.6 (WDI)
WATCHDOG_SET1: R9.2, U5.5 (SET1)

Notes on the sheet:
01 — POWER / PROTECTION
PROTECTED ±12 V • 3.3 V DIGITAL • 5.453 V PRE-RAIL • QUIET 5 V • HARDWARE FAULT
Active-device footprints intentionally blank pending independent footprint review.
FAULT_N wired-AND sources: U1 PG, U2 PG, U4 RESET_N, U5 WDO_N. Fault release requires all sources high; no firmware path can force a held-low net high.
Provisional power-entry fuses, Schottky diodes, ferrite beads and connector remain subject to exact part selection. The topology is captured; footprints and physical power format remain blocked.
PWR_FLAG markers identify rails after passive protection/conversion boundaries for ERC. RAIL_5V_CODEC is driven directly by U3 and needs no source annotation.
Global GND established here and driven by the existing ground PWR_FLAG.
