armpitpete/merrin-voice-01/hardware/memory-core-prototype-a/02_MCU_CLOCK_DEBUG.kicad_sch

## KiCad design hardware/memory-core-prototype-a/02_MCU_CLOCK_DEBUG.kicad_sch (2026-07-14)

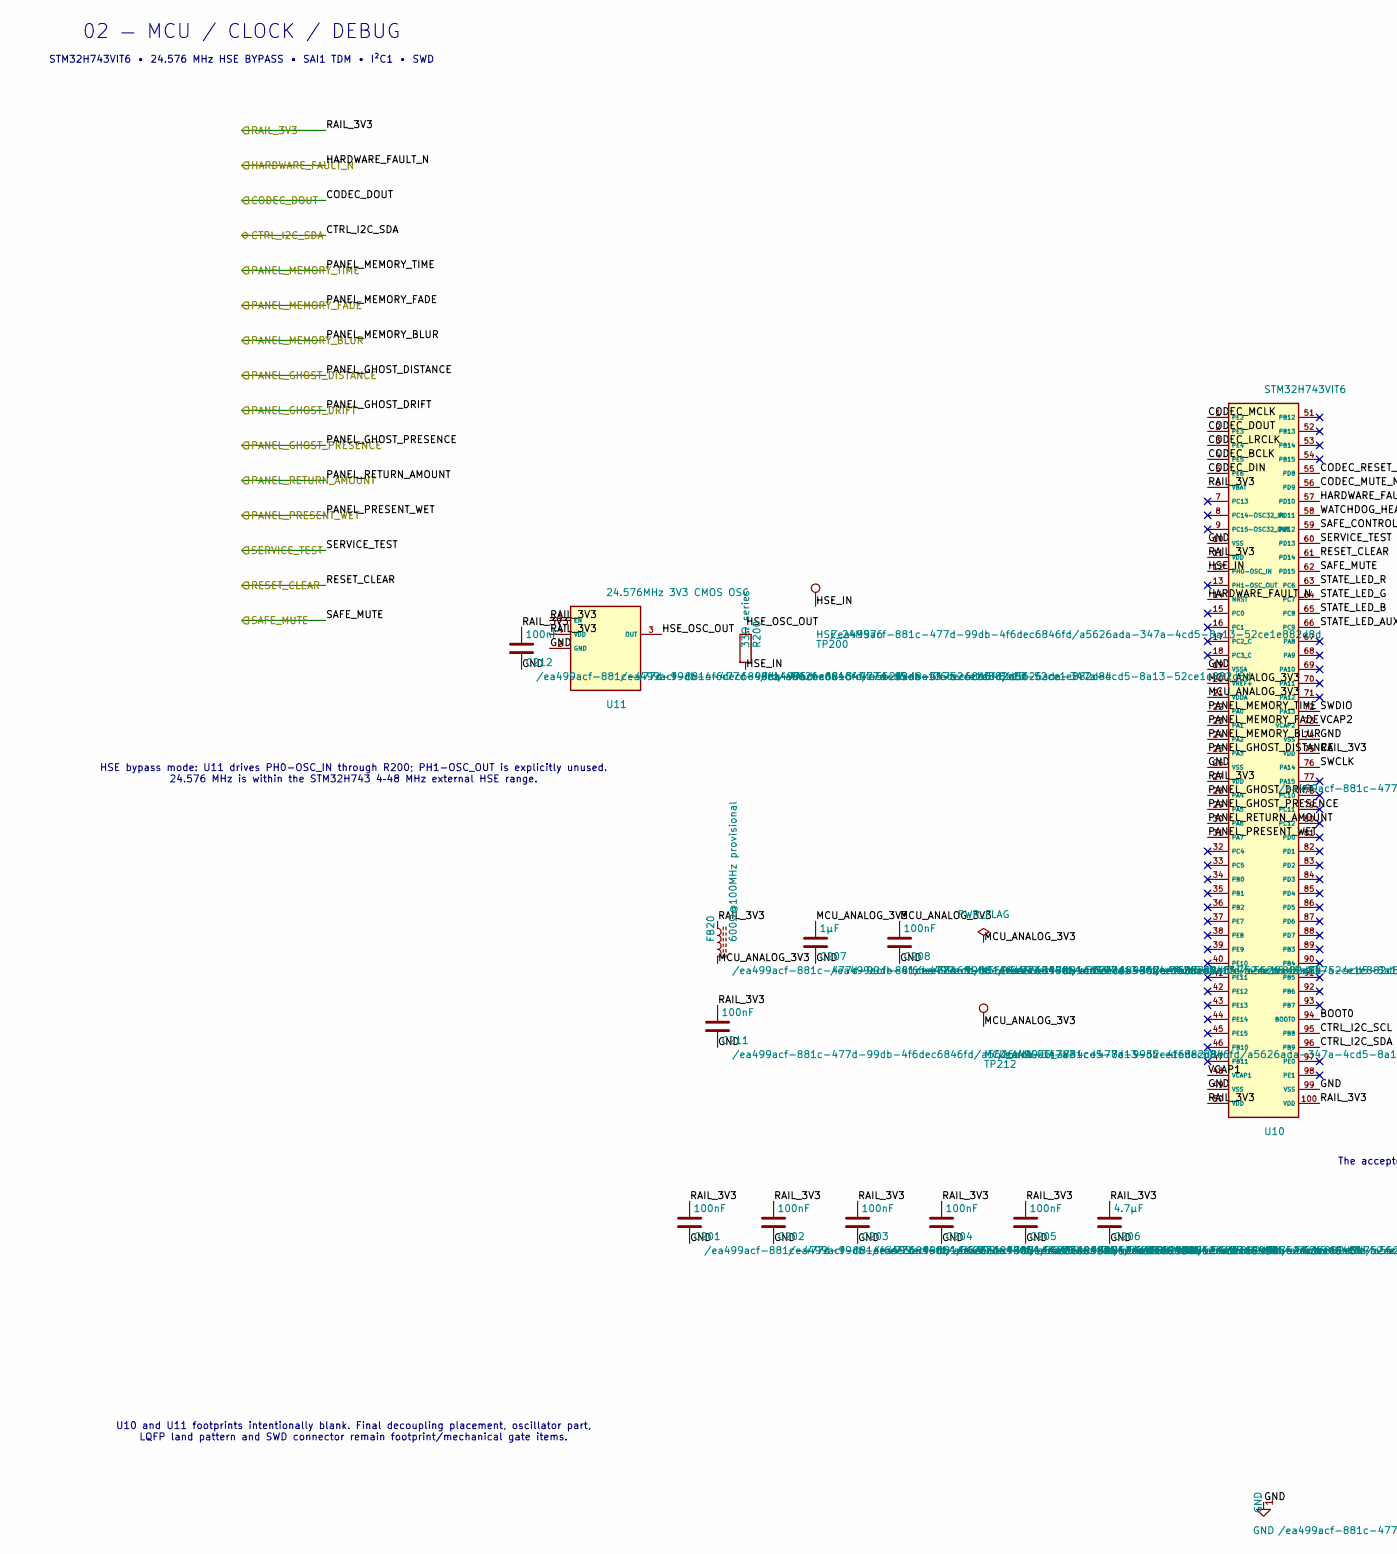
[picture p3: schematic 02_MCU_CLOCK_DEBUG.kicad_sch, part in row 1, column 1]

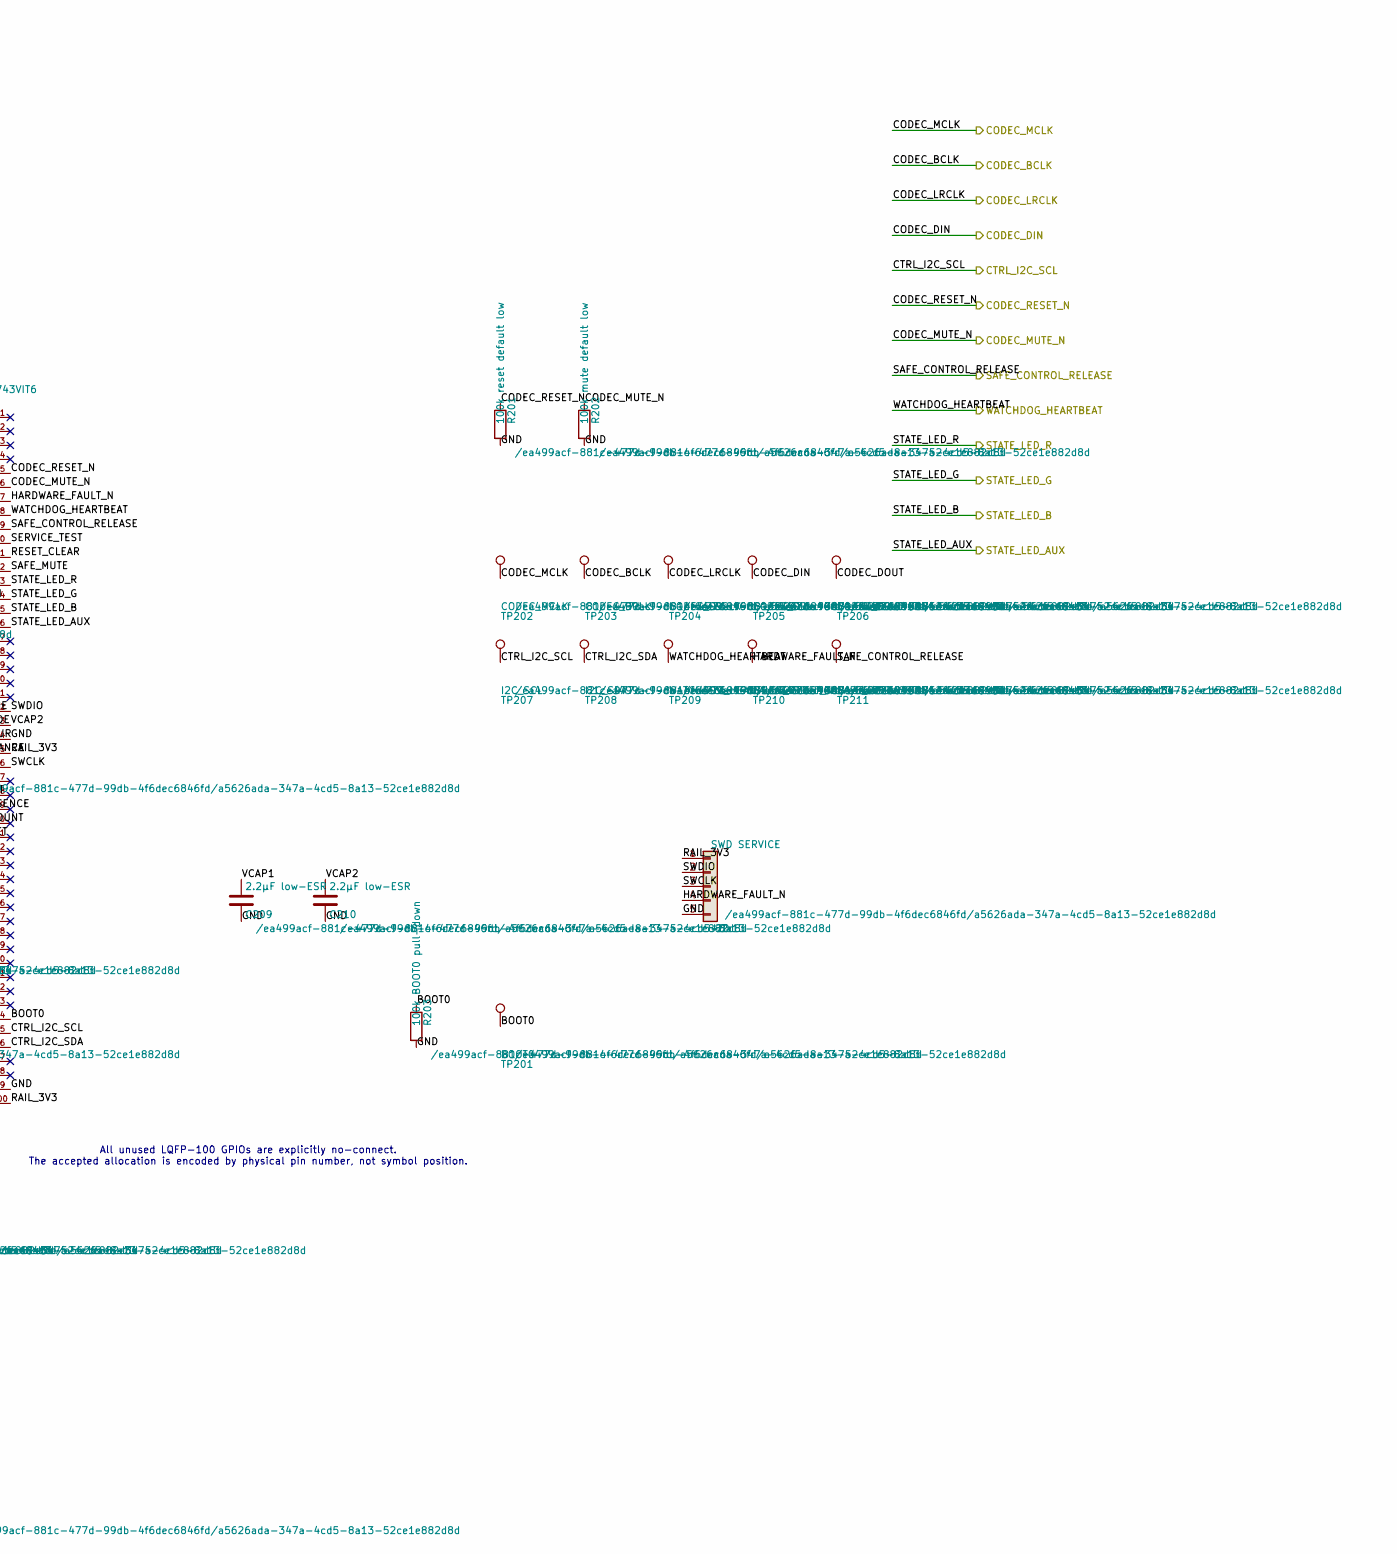
[picture p4: schematic 02_MCU_CLOCK_DEBUG.kicad_sch, part in row 1, column 2]

Parts:
C201, C202, C203, C204, C205, C208, C211, C212: 100nF; C_0805_2012Metric
C206: 4.7µF; C_0805_2012Metric
C207: 1µF; C_0805_2012Metric
C209, C210: 2.2µF low-ESR; C_0805_2012Metric
FB20: 600Ω@100MHz provisional
J20: SWD SERVICE
R200: 33Ω series; R_0805_2012Metric
R201: 100k reset default low; R_0805_2012Metric
R202: 100k mute default low; R_0805_2012Metric
R203: 100k BOOT0 pull-down; R_0805_2012Metric
TP200: HSE_24M576
TP201: BOOT0
TP202: CODEC_MCLK
TP203: CODEC_BCLK
TP204: CODEC_LRCLK
TP205: CODEC_DIN
TP206: CODEC_DOUT
TP207: I2C_SCL
TP208: I2C_SDA
TP209: WATCHDOG_HEARTBEAT
TP210: FAULT_RESET_N
TP211: SAFE_RELEASE
TP212: MCU_ANALOG_3V3
U10: STM32H743VIT6
U11: 24.576MHz 3V3 CMOS OSC

Connections:
BOOT0: R203.1, TP201.1, U10.94 (BOOT0)
CODEC_BCLK: TP203.1, U10.4 (PE5)
CODEC_DIN: TP205.1, U10.5 (PE6)
CODEC_DOUT: TP206.1, U10.2 (PE3)
CODEC_LRCLK: TP204.1, U10.3 (PE4)
CODEC_MCLK: TP202.1, U10.1 (PE2)
CODEC_MUTE_N: R202.1, U10.56 (PD9)
CODEC_RESET_N: R201.1, U10.55 (PD8)
CTRL_I2C_SCL: TP207.1, U10.95 (PB8)
CTRL_I2C_SDA: TP208.1, U10.96 (PB9)
GND: C201.2, C202.2, C203.2, C204.2, C205.2, C206.2, C207.2, C208.2, C209.2, C210.2, C211.2, C212.2, J20.5, R201.2, R202.2, R203.2, U10.10 (VSS), U10.19 (VSSA), U10.26 (VSS), U10.49 (VSS), U10.74 (VSS), U10.99 (VSS), U11.2 (GND)
HARDWARE_FAULT_N: J20.4, TP210.1, U10.14 (NRST), U10.57 (PD10)
HSE_IN: R200.2, TP200.1, U10.12 (PH0-OSC_IN)
HSE_OSC_OUT: R200.1, U11.3 (OUT)
MCU_ANALOG_3V3: C207.1, C208.1, FB20.2, TP212.1, U10.20 (VREF+), U10.21 (VDDA)
PANEL_GHOST_DISTANCE: U10.25 (PA3)
PANEL_GHOST_DRIFT: U10.28 (PA4)
PANEL_GHOST_PRESENCE: U10.29 (PA5)
PANEL_MEMORY_BLUR: U10.24 (PA2)
PANEL_MEMORY_FADE: U10.23 (PA1)
PANEL_MEMORY_TIME: U10.22 (PA0)
PANEL_PRESENT_WET: U10.31 (PA7)
PANEL_RETURN_AMOUNT: U10.30 (PA6)
RAIL_3V3: C201.1, C202.1, C203.1, C204.1, C205.1, C206.1, C211.1, C212.1, FB20.1, J20.1, U10.6 (VBAT), U10.11 (VDD), U10.27 (VDD), U10.50 (VDD), U10.75 (VDD), U10.100 (VDD), U11.1 (EN), U11.4 (VDD)
RESET_CLEAR: U10.61 (PD14)
SAFE_CONTROL_RELEASE: TP211.1, U10.59 (PD12)
SAFE_MUTE: U10.62 (PD15)
SERVICE_TEST: U10.60 (PD13)
STATE_LED_AUX: U10.66 (PC9)
STATE_LED_B: U10.65 (PC8)
STATE_LED_G: U10.64 (PC7)
STATE_LED_R: U10.63 (PC6)
SWCLK: J20.3, U10.76 (PA14)
SWDIO: J20.2, U10.72 (PA13)
VCAP1: C209.1, U10.48 (VCAP1)
VCAP2: C210.1, U10.73 (VCAP2)
WATCHDOG_HEARTBEAT: TP209.1, U10.58 (PD11)

Notes on the sheet:
02 — MCU / CLOCK / DEBUG
STM32H743VIT6 • 24.576 MHz HSE BYPASS • SAI1 TDM • I²C1 • SWD
HSE bypass mode: U11 drives PH0-OSC_IN through R200; PH1-OSC_OUT is explicitly unused. 24.576 MHz is within the STM32H743 4–48 MHz external HSE range.
All unused LQFP-100 GPIOs are explicitly no-connect. The accepted allocation is encoded by physical pin number, not symbol position.
U10 and U11 footprints intentionally blank. Final decoupling placement, oscillator part, LQFP land pattern and SWD connector remain footprint/mechanical gate items.
