armpitpete/merrin-voice-01/hardware/memory-core-prototype-a/03_CODEC_CONVERSION.kicad_sch

## KiCad design hardware/memory-core-prototype-a/03_CODEC_CONVERSION.kicad_sch (2026-07-14)

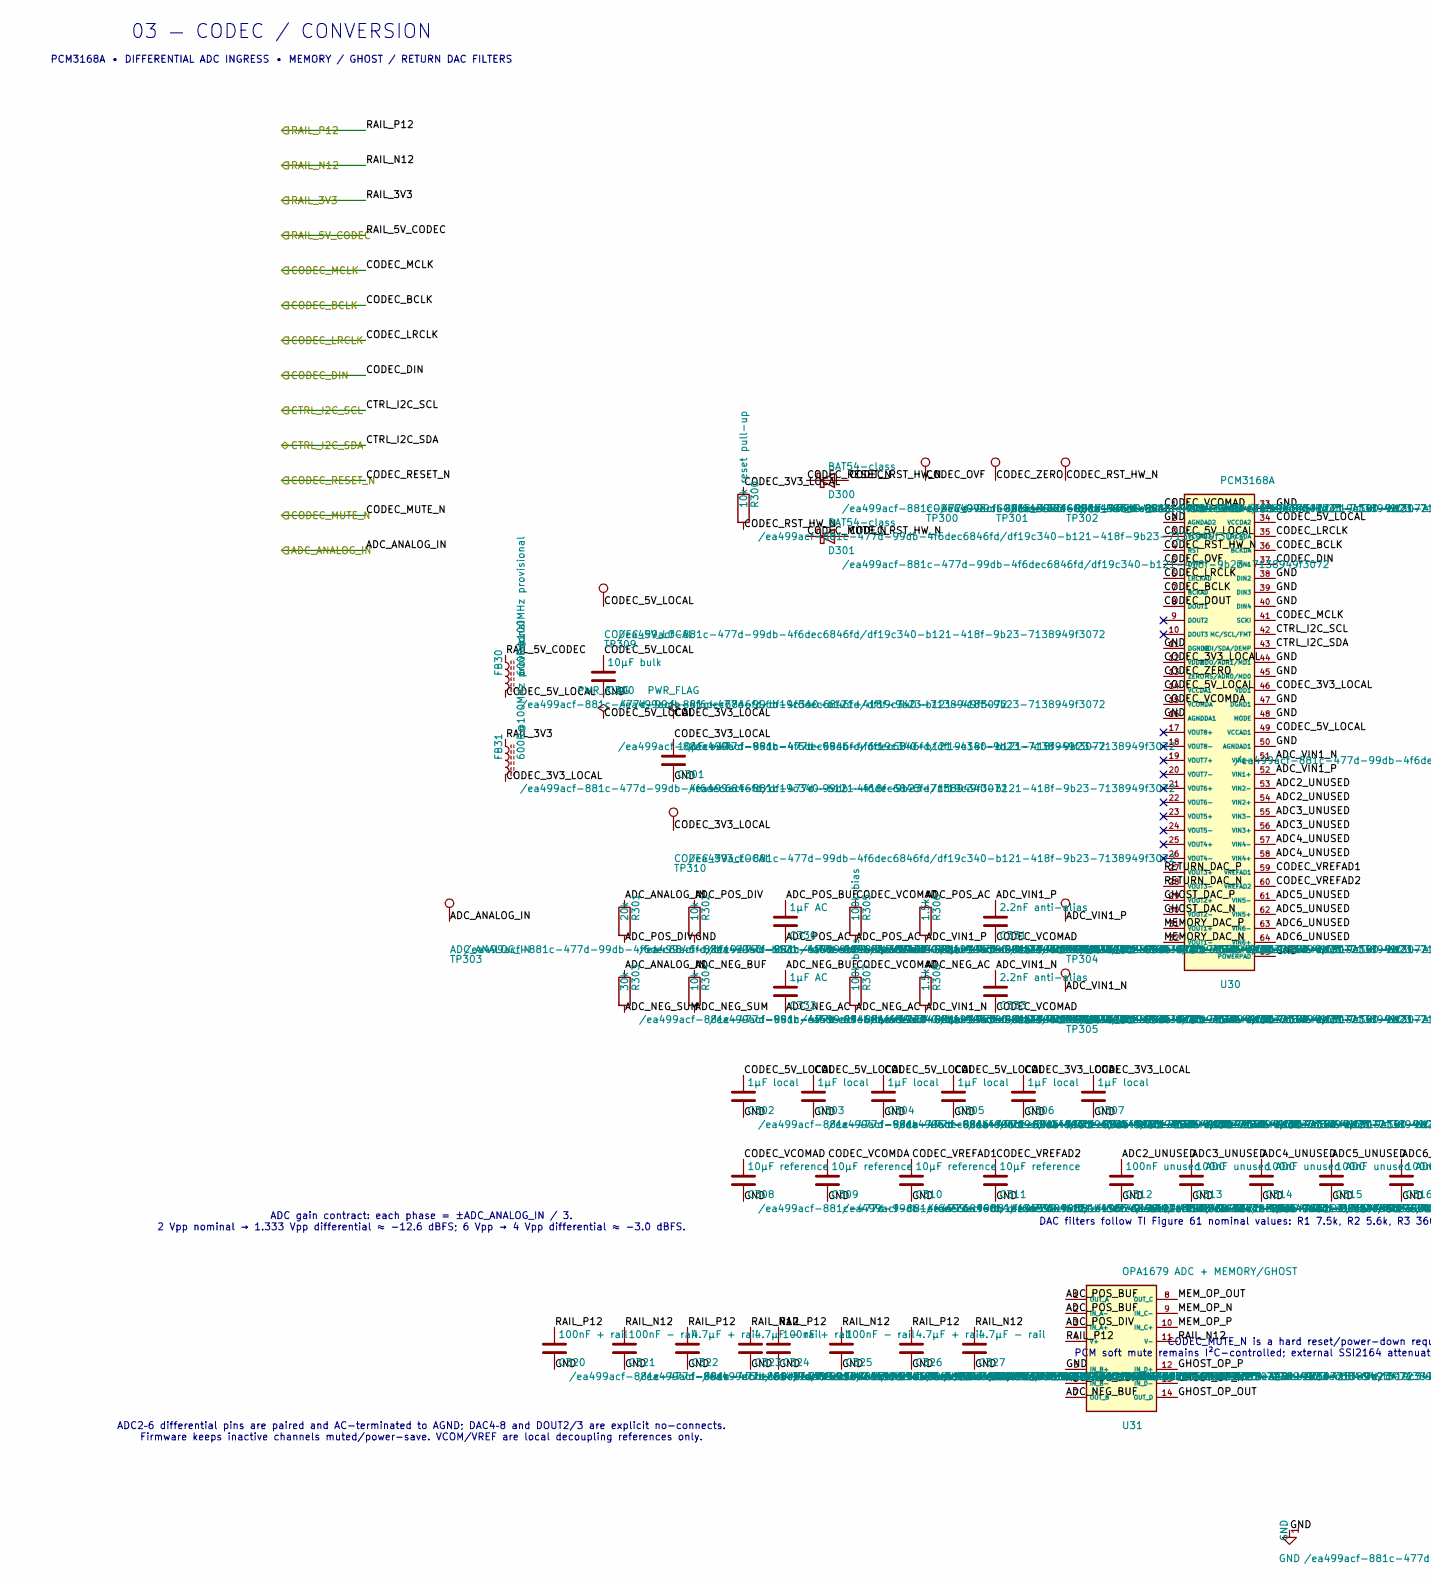
[picture p5: schematic 03_CODEC_CONVERSION.kicad_sch, part in row 1, column 1]

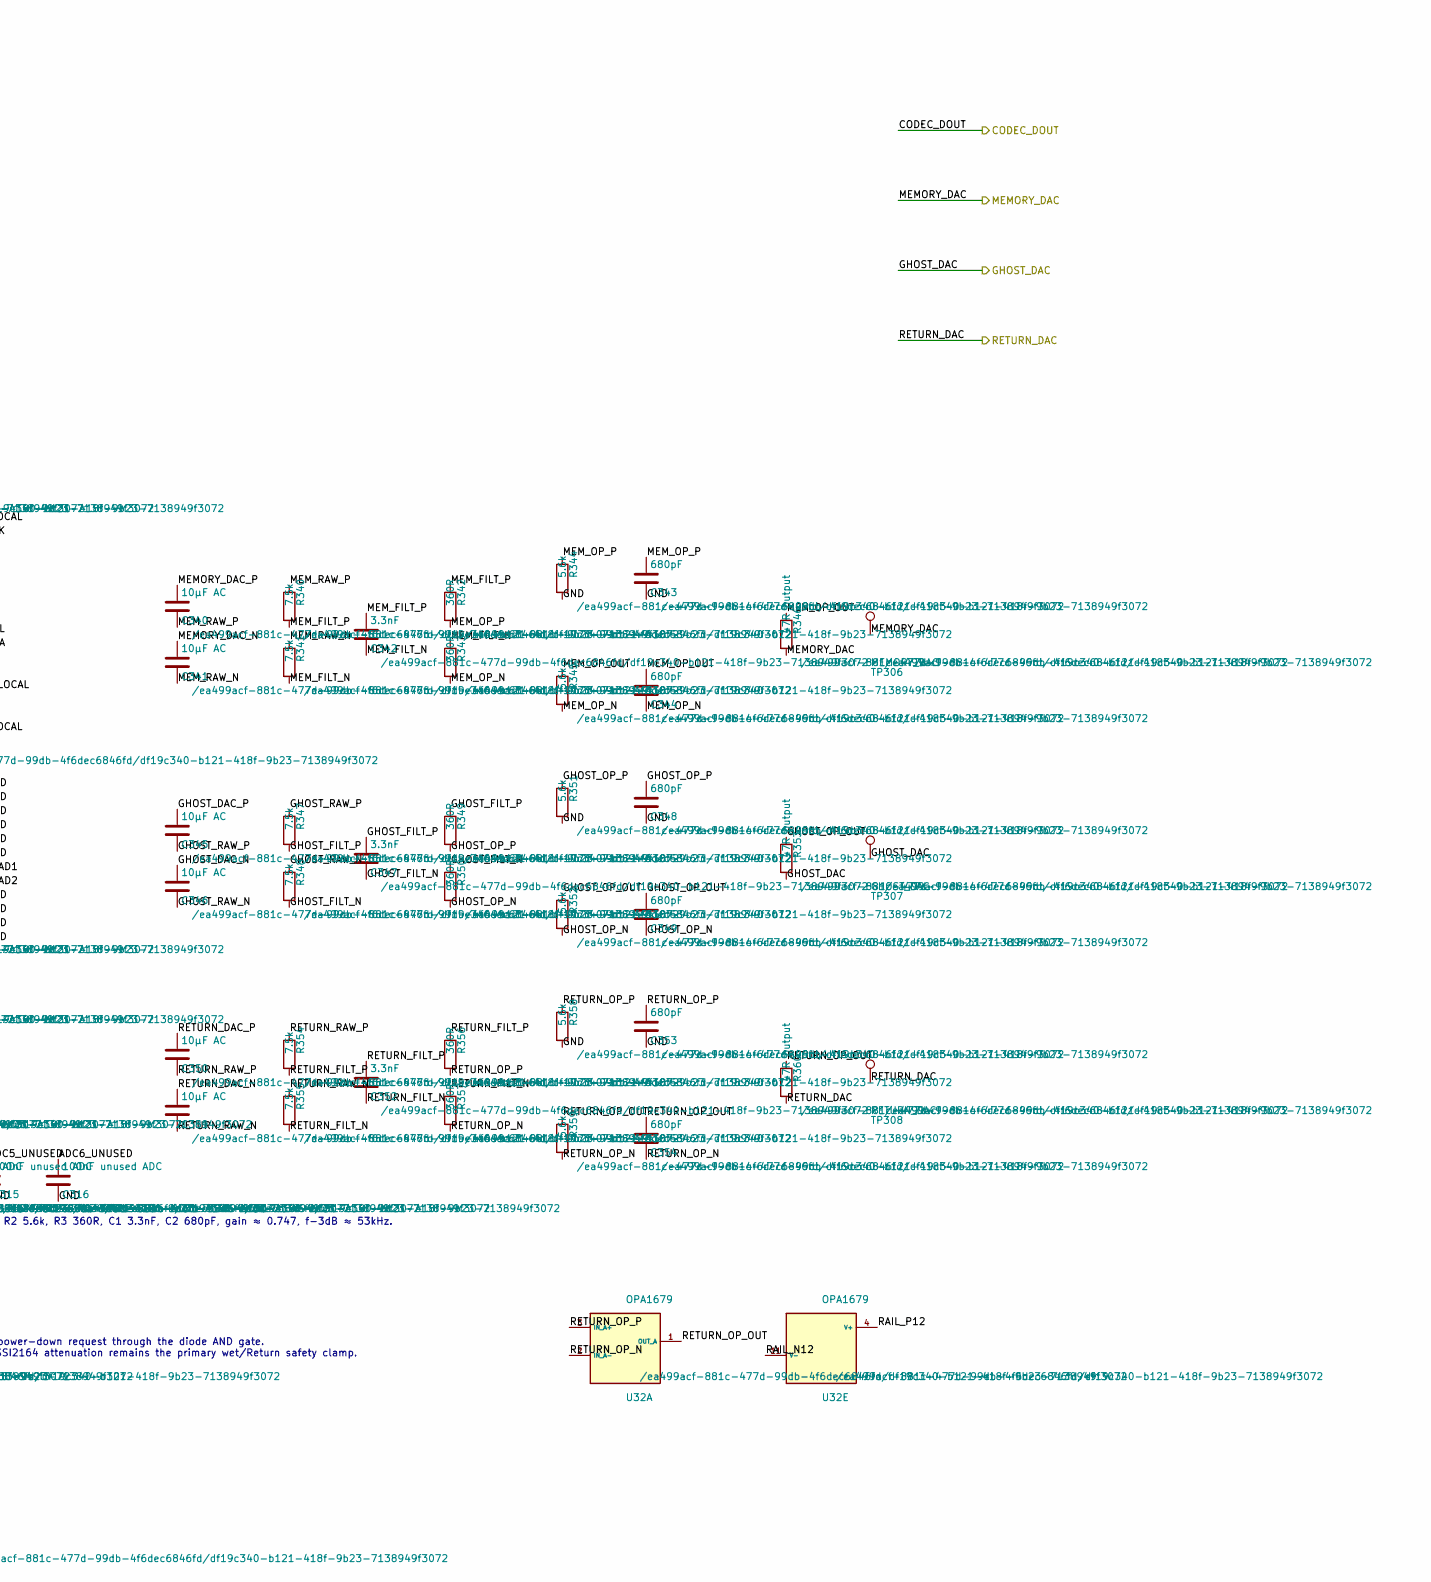
[picture p6: schematic 03_CODEC_CONVERSION.kicad_sch, part in row 1, column 2]

Parts:
C300, C301: 10µF bulk; C_0805_2012Metric
C302, C303, C304, C305, C306, C307: 1µF local; C_0805_2012Metric
C308, C309, C310, C311: 10µF reference; C_0805_2012Metric
C312, C313, C314, C315, C316: 100nF unused ADC; C_0805_2012Metric
C320, C324: 100nF + rail; C_0805_2012Metric
C321, C325: 100nF - rail; C_0805_2012Metric
C322, C326: 4.7µF + rail; C_0805_2012Metric
C323, C327: 4.7µF - rail; C_0805_2012Metric
C330, C332: 1µF AC
C331, C333: 2.2nF anti-alias; C_0805_2012Metric
C340, C341, C345, C346, C350, C351: 10µF AC
C342, C347, C352: 3.3nF; C_0805_2012Metric
C343, C344, C348, C349, C353, C354: 680pF; C_0805_2012Metric
D300, D301: BAT54-class
FB30, FB31: 600R@100MHz provisional
R300: 10k reset pull-up; R_0805_2012Metric
R301: 20k; R_0805_2012Metric
R302, R304: 10k; R_0805_2012Metric
R303: 30k; R_0805_2012Metric
R305, R307: 100k bias; R_0805_2012Metric
R306, R308: 1.5k; R_0805_2012Metric
R340, R341, R347, R348, R354, R355: 7.5k; R_0805_2012Metric
R342, R343, R349, R350, R356, R357: 360R; R_0805_2012Metric
R344, R345, R351, R352, R358, R359: 5.6k; R_0805_2012Metric
R346, R353, R360: 47R output; R_0805_2012Metric
TP300: CODEC_OVF
TP301: CODEC_ZERO
TP302: CODEC_RST_HW_N
TP303: ADC_ANALOG_IN
TP304: ADC_VIN1_P
TP305: ADC_VIN1_N
TP306: MEMORY_DAC
TP307: GHOST_DAC
TP308: RETURN_DAC
TP309: CODEC_5V_LOCAL
TP310: CODEC_3V3_LOCAL
U30: PCM3168A
U31: OPA1679 ADC + MEMORY/GHOST
U32: OPA1679

Connections:
ADC2_UNUSED: C312.1, U30.53 (VIN2-), U30.54 (VIN2+)
ADC3_UNUSED: C313.1, U30.55 (VIN3-), U30.56 (VIN3+)
ADC4_UNUSED: C314.1, U30.57 (VIN4-), U30.58 (VIN4+)
ADC5_UNUSED: C315.1, U30.61 (VIN5-), U30.62 (VIN5+)
ADC6_UNUSED: C316.1, U30.63 (VIN6-), U30.64 (VIN6+)
ADC_ANALOG_IN: R301.1, R303.1, TP303.1
ADC_NEG_AC: C332.2, R307.2, R308.1
ADC_NEG_BUF: C332.1, R304.1, U31.7 (OUT_B)
ADC_NEG_SUM: R303.2, R304.2, U31.6 (IN_B-)
ADC_POS_AC: C330.2, R305.2, R306.1
ADC_POS_BUF: C330.1, U31.1 (OUT_A), U31.2 (IN_A-)
ADC_POS_DIV: R301.2, R302.1, U31.3 (IN_A+)
ADC_VIN1_N: C333.1, R308.2, TP305.1, U30.51 (VIN1-)
ADC_VIN1_P: C331.1, R306.2, TP304.1, U30.52 (VIN1+)
CODEC_3V3_LOCAL: C301.1, C306.1, C307.1, FB31.2, R300.1, TP310.1, U30.12 (VDD2), U30.46 (VDD1)
CODEC_5V_LOCAL: C300.1, C302.1, C303.1, C304.1, C305.1, FB30.2, TP309.1, U30.3 (VCCAD2), U30.14 (VCCDA1), U30.34 (VCCDA2), U30.49 (VCCAD1)
CODEC_BCLK: U30.7 (BCKAD), U30.36 (BCKDA)
CODEC_DIN: U30.37 (DIN1)
CODEC_DOUT: U30.8 (DOUT1)
CODEC_LRCLK: U30.6 (LRCKAD), U30.35 (LRCKDA)
CODEC_MCLK: U30.41 (SCKI)
CODEC_MUTE_N: D301.1 (K)
CODEC_OVF: TP300.1, U30.5 (OVF)
CODEC_RESET_N: D300.1 (K)
CODEC_RST_HW_N: D300.2 (A), D301.2 (A), R300.2, TP302.1, U30.4 (RST)
CODEC_VCOMAD: C308.1, C331.2, C333.2, R305.1, R307.1, U30.1 (VCOMAD)
CODEC_VCOMDA: C309.1, U30.15 (VCOMDA)
CODEC_VREFAD1: C310.1, U30.59 (VREFAD1)
CODEC_VREFAD2: C311.1, U30.60 (VREFAD2)
CODEC_ZERO: TP301.1, U30.13 (ZERO)
CTRL_I2C_SCL: U30.42 (MC/SCL/FMT)
CTRL_I2C_SDA: U30.43 (MDI/SDA/DEMP)
GHOST_DAC: R353.2, TP307.1
GHOST_DAC_N: C346.1, U30.30 (VOUT2-)
GHOST_DAC_P: C345.1, U30.29 (VOUT2+)
GHOST_FILT_N: C347.2, R348.2, R350.1
GHOST_FILT_P: C347.1, R347.2, R349.1
GHOST_OP_N: C349.2, R350.2, R352.2, U31.13 (IN_D-)
GHOST_OP_OUT: C349.1, R352.1, R353.1, U31.14 (OUT_D)
GHOST_OP_P: C348.1, R349.2, R351.1, U31.12 (IN_D+)
GHOST_RAW_N: C346.2, R348.1
GHOST_RAW_P: C345.2, R347.1
GND: C300.2, C301.2, C302.2, C303.2, C304.2, C305.2, C306.2, C307.2, C308.2, C309.2, C310.2, C311.2, C312.2, C313.2, C314.2, C315.2, C316.2, C320.2, C321.2, C322.2, C323.2, C324.2, C325.2, C326.2, C327.2, C343.2, C348.2, C353.2, R302.2, R344.2, R351.2, R358.2, U30.2 (AGNDAD2), U30.11 (DGND2), U30.16 (AGNDDA1), U30.33 (AGNDDA2), U30.38 (DIN2), U30.39 (DIN3), U30.40 (DIN4), U30.44 (MDO/ADR1/MD1), U30.45 (MS/ADR0/MD0), U30.47 (DGND1), U30.48 (MODE), U30.50 (AGNDAD1), U30.65 (POWERPAD), U31.5 (IN_B+)
MEMORY_DAC: R346.2, TP306.1
MEMORY_DAC_N: C341.1, U30.32 (VOUT1-)
MEMORY_DAC_P: C340.1, U30.31 (VOUT1+)
MEM_FILT_N: C342.2, R341.2, R343.1
MEM_FILT_P: C342.1, R340.2, R342.1
MEM_OP_N: C344.2, R343.2, R345.2, U31.9 (IN_C-)
MEM_OP_OUT: C344.1, R345.1, R346.1, U31.8 (OUT_C)
MEM_OP_P: C343.1, R342.2, R344.1, U31.10 (IN_C+)
MEM_RAW_N: C341.2, R341.1
MEM_RAW_P: C340.2, R340.1
RAIL_3V3: FB31.1
RAIL_5V_CODEC: FB30.1
RAIL_N12: C321.1, C323.1, C325.1, C327.1, U31.11 (V-), U32.11 (V-)
RAIL_P12: C320.1, C322.1, C324.1, C326.1, U31.4 (V+), U32.4 (V+)
RETURN_DAC: R360.2, TP308.1
RETURN_DAC_N: C351.1, U30.28 (VOUT3-)
RETURN_DAC_P: C350.1, U30.27 (VOUT3+)
RETURN_FILT_N: C352.2, R355.2, R357.1
RETURN_FILT_P: C352.1, R354.2, R356.1
RETURN_OP_N: C354.2, R357.2, R359.2, U32.2 (IN_A-)
RETURN_OP_OUT: C354.1, R359.1, R360.1, U32.1 (OUT_A)
RETURN_OP_P: C353.1, R356.2, R358.1, U32.3 (IN_A+)
RETURN_RAW_N: C351.2, R355.1
RETURN_RAW_P: C350.2, R354.1

Notes on the sheet:
03 — CODEC / CONVERSION
PCM3168A • DIFFERENTIAL ADC INGRESS • MEMORY / GHOST / RETURN DAC FILTERS
ADC gain contract: each phase = ±ADC_ANALOG_IN / 3. 2 Vpp nominal → 1.333 Vpp differential ≈ −12.6 dBFS; 6 Vpp → 4 Vpp differential ≈ −3.0 dBFS.
DAC filters follow TI Figure 61 nominal values: R1 7.5k, R2 5.6k, R3 360R, C1 3.3nF, C2 680pF, gain ≈ 0.747, f−3dB ≈ 53kHz.
ADC2–6 differential pins are paired and AC-terminated to AGND; DAC4–8 and DOUT2/3 are explicit no-connects. Firmware keeps inactive channels muted/power-save. VCOM/VREF are local decoupling references only.
CODEC_MUTE_N is a hard reset/power-down request through the diode AND gate. PCM soft mute remains I²C-controlled; external SSI2164 attenuation remains the primary wet/Return safety clamp.
