armpitpete/merrin-voice-01/hardware/memory-core-prototype-a/04_INPUT_PRESSURE_ABSENCE.kicad_sch

## KiCad design hardware/memory-core-prototype-a/04_INPUT_PRESSURE_ABSENCE.kicad_sch (2026-07-16)

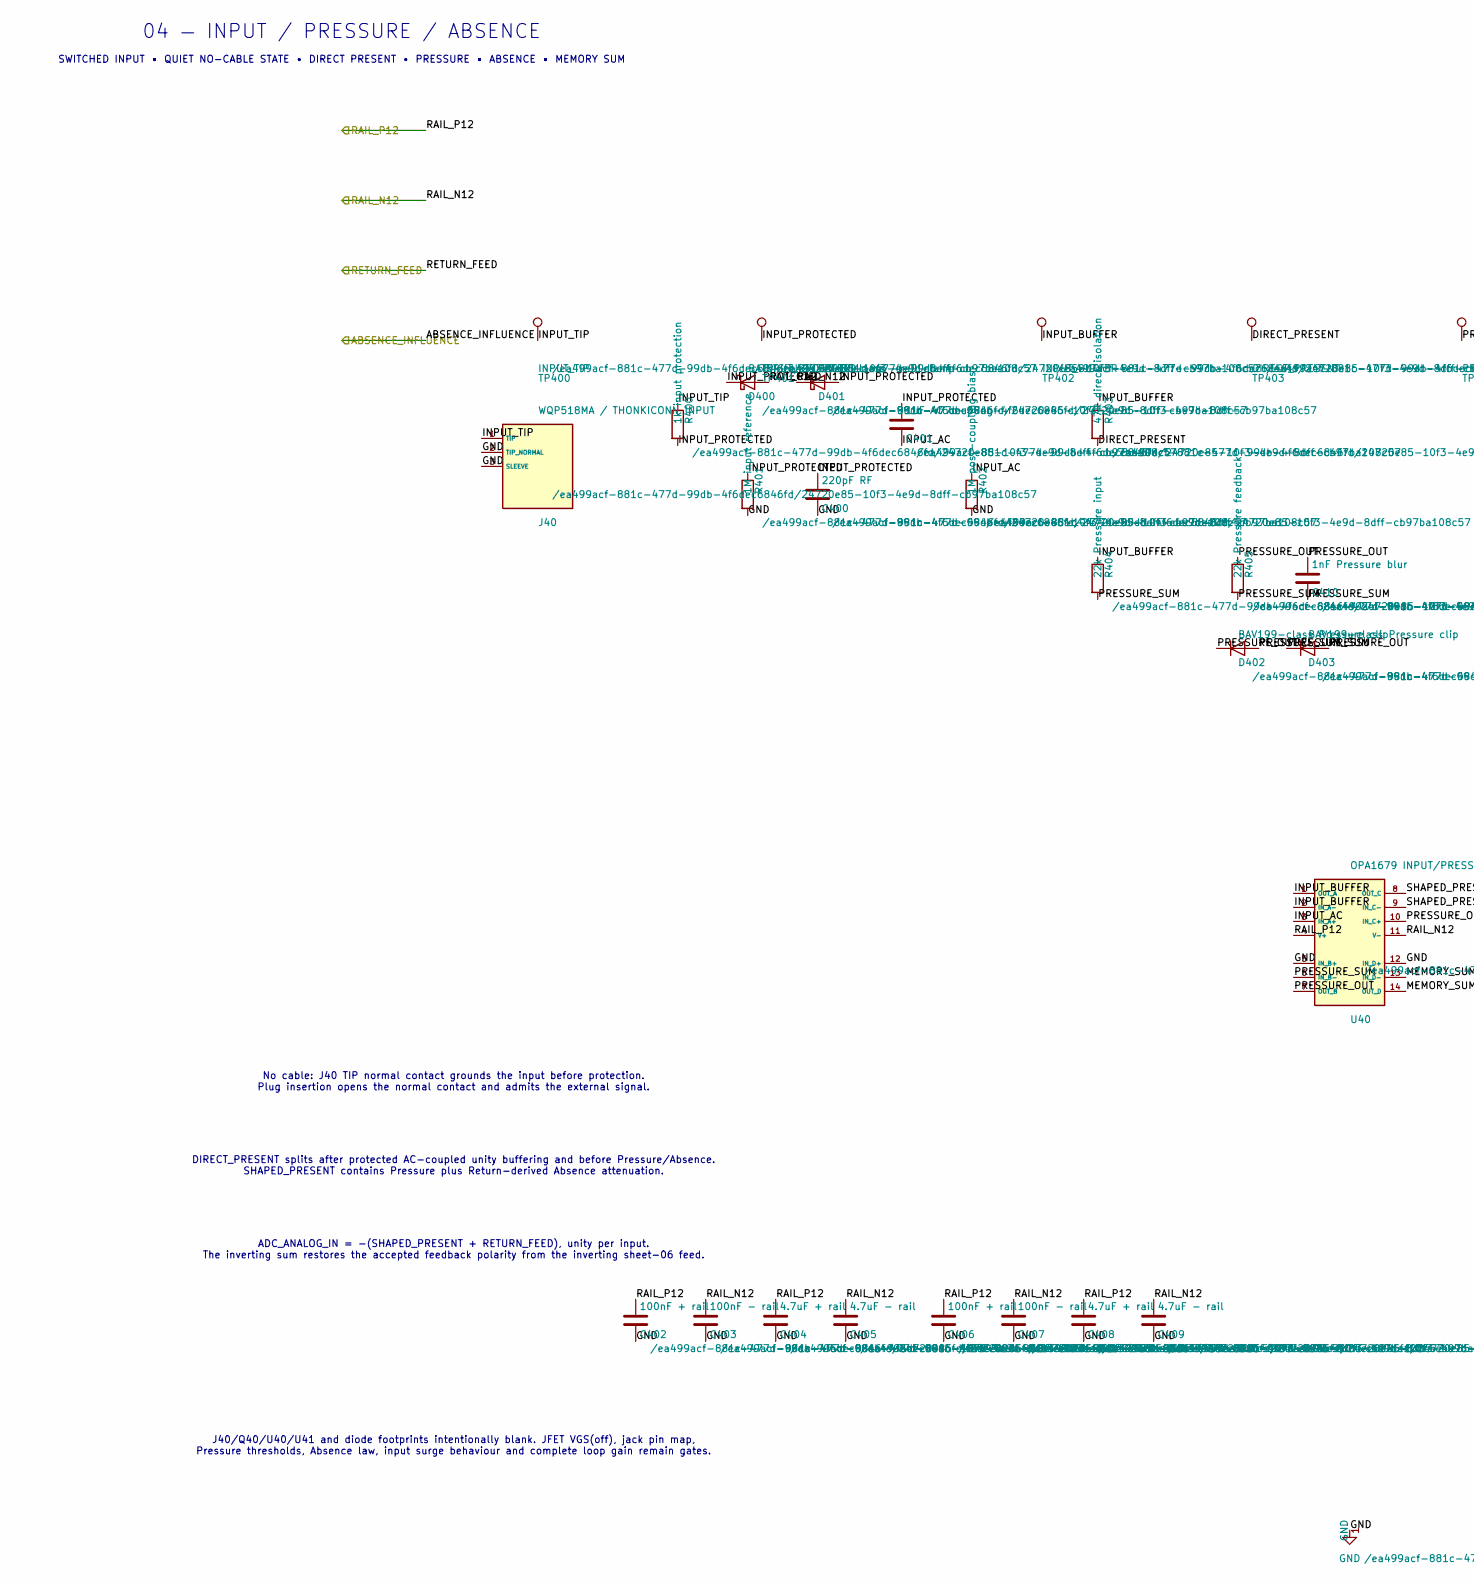
[picture p7: schematic 04_INPUT_PRESSURE_ABSENCE.kicad_sch, part in row 1, column 1]

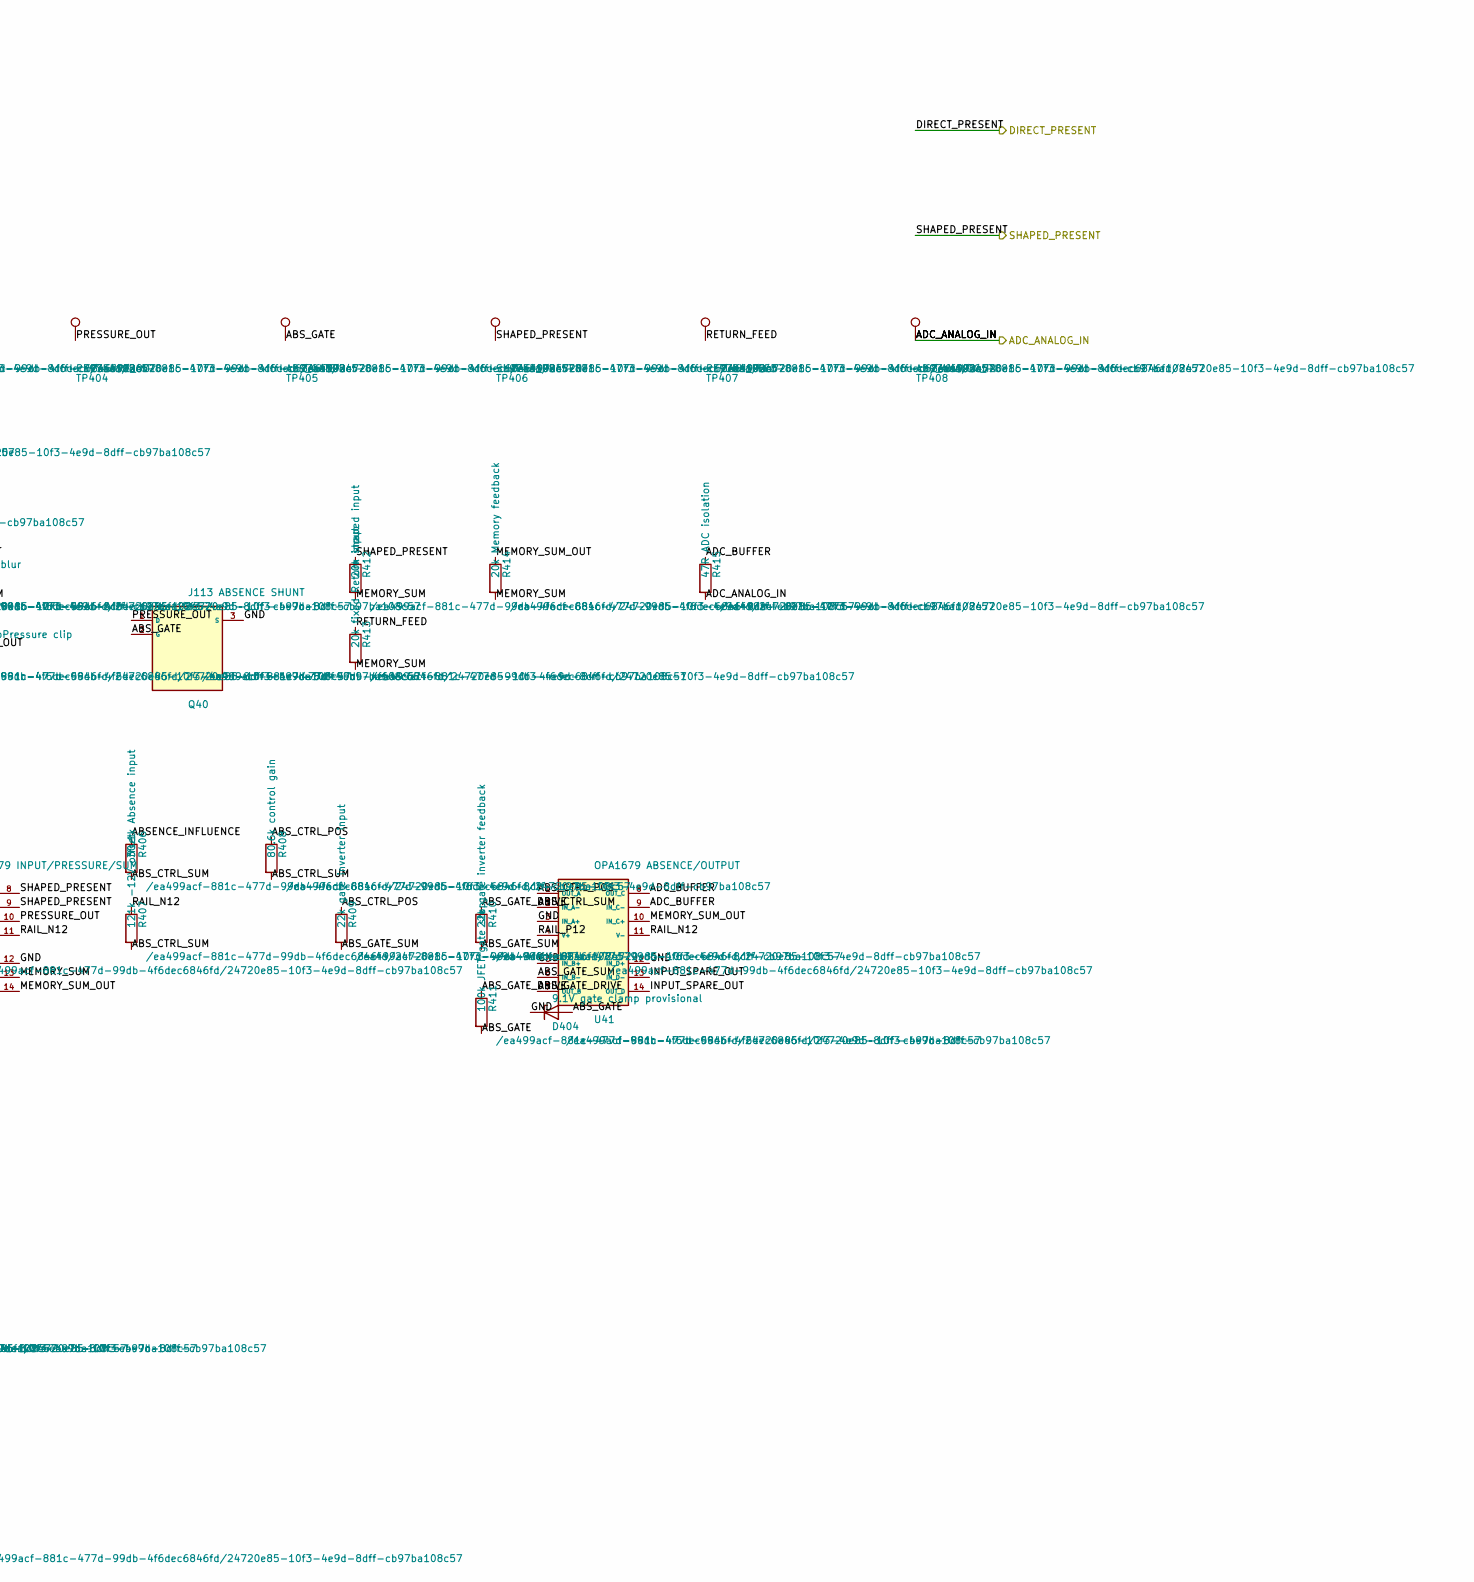
[picture p8: schematic 04_INPUT_PRESSURE_ABSENCE.kicad_sch, part in row 1, column 2]

Parts:
C400: 220pF RF; C_0805_2012Metric
C401: 1uF AC coupling
C402, C406: 100nF + rail; C_0805_2012Metric
C403, C407: 100nF - rail; C_0805_2012Metric
C404, C408: 4.7uF + rail; C_0805_2012Metric
C405, C409: 4.7uF - rail; C_0805_2012Metric
C410: 1nF Pressure blur; C_0805_2012Metric
D400: BAT54-class +rail clamp
D401: BAT54-class -rail clamp
D402, D403: BAV199-class Pressure clip
D404: 9.1V gate clamp provisional
J40: WQP518MA / THONKICONN INPUT; Jack_3.5mm_Thonkiconn_WQP518MA_Numeric
Q40: J113 ABSENCE SHUNT
R400: 1k input protection; R_0805_2012Metric
R401: 1M input reference; R_0805_2012Metric
R402: 1M post-coupling bias; R_0805_2012Metric
R403: 47R direct isolation; R_0805_2012Metric
R404: 22k Pressure input; R_0805_2012Metric
R405: 22k Pressure feedback; R_0805_2012Metric
R406: 30.1k Absence input; R_0805_2012Metric
R407: 121k -12V offset; R_0805_2012Metric
R408: 80.6k control gain; R_0805_2012Metric
R409: 22k gate inverter input; R_0805_2012Metric
R410: 22k gate inverter feedback; R_0805_2012Metric
R411: 100k JFET gate stop; R_0805_2012Metric
R412: 20k shaped input; R_0805_2012Metric
R413: 20k fixed Return input; R_0805_2012Metric
R414: 20k Memory feedback; R_0805_2012Metric
R415: 47R ADC isolation; R_0805_2012Metric
TP400: INPUT_TIP
TP401: INPUT_PROTECTED
TP402: INPUT_BUFFER
TP403: DIRECT_PRESENT
TP404: PRESSURE_OUT
TP405: ABS_GATE
TP406: SHAPED_PRESENT
TP407: RETURN_FEED
TP408: ADC_ANALOG_IN
U40: OPA1679 INPUT/PRESSURE/SUM
U41: OPA1679 ABSENCE/OUTPUT

Connections:
ABSENCE_INFLUENCE: R406.1
ABS_CTRL_POS: R408.1, R409.1, U41.1 (OUT_A)
ABS_CTRL_SUM: R406.2, R407.2, R408.2, U41.2 (IN_A-)
ABS_GATE: D404.2 (A), Q40.2 (G), R411.2, TP405.1
ABS_GATE_DRIVE: R410.1, R411.1, U41.7 (OUT_B)
ABS_GATE_SUM: R409.2, R410.2, U41.6 (IN_B-)
ADC_ANALOG_IN: R415.2, TP408.1
ADC_BUFFER: R415.1, U41.8 (OUT_C), U41.9 (IN_C-)
DIRECT_PRESENT: R403.2, TP403.1
GND: C400.2, C402.2, C403.2, C404.2, C405.2, C406.2, C407.2, C408.2, C409.2, D404.1 (K), J40.2 (TIP_NORMAL), J40.3 (SLEEVE), Q40.3 (S), R401.2, R402.2, U40.5 (IN_B+), U40.12 (IN_D+), U41.3 (IN_A+), U41.5 (IN_B+), U41.12 (IN_D+)
INPUT_AC: C401.2, R402.1, U40.3 (IN_A+)
INPUT_BUFFER: R403.1, R404.1, TP402.1, U40.1 (OUT_A), U40.2 (IN_A-)
INPUT_PROTECTED: C400.1, C401.1, D400.1 (K), D401.2 (A), R400.2, R401.1, TP401.1
INPUT_SPARE_OUT: U41.13 (IN_D-), U41.14 (OUT_D)
INPUT_TIP: J40.1 (TIP), R400.1, TP400.1
MEMORY_SUM: R412.2, R413.2, R414.2, U40.13 (IN_D-)
MEMORY_SUM_OUT: R414.1, U40.14 (OUT_D), U41.10 (IN_C+)
PRESSURE_OUT: C410.1, D402.1 (K), D403.2 (A), Q40.1 (D), R405.1, TP404.1, U40.7 (OUT_B), U40.10 (IN_C+)
PRESSURE_SUM: C410.2, D402.2 (A), D403.1 (K), R404.2, R405.2, U40.6 (IN_B-)
RAIL_N12: C403.1, C405.1, C407.1, C409.1, D401.1 (K), R407.1, U40.11 (V-), U41.11 (V-)
RAIL_P12: C402.1, C404.1, C406.1, C408.1, D400.2 (A), U40.4 (V+), U41.4 (V+)
RETURN_FEED: R413.1, TP407.1
SHAPED_PRESENT: R412.1, TP406.1, U40.8 (OUT_C), U40.9 (IN_C-)

Notes on the sheet:
04 — INPUT / PRESSURE / ABSENCE
SWITCHED INPUT • QUIET NO-CABLE STATE • DIRECT PRESENT • PRESSURE • ABSENCE • MEMORY SUM
No cable: J40 TIP normal contact grounds the input before protection. Plug insertion opens the normal contact and admits the external signal.
DIRECT_PRESENT splits after protected AC-coupled unity buffering and before Pressure/Absence. SHAPED_PRESENT contains Pressure plus Return-derived Absence attenuation.
ADC_ANALOG_IN = -(SHAPED_PRESENT + RETURN_FEED), unity per input. The inverting sum restores the accepted feedback polarity from the inverting sheet-06 feed.
J40/Q40/U40/U41 and diode footprints intentionally blank. JFET VGS(off), jack pin map, Pressure thresholds, Absence law, input surge behaviour and complete loop gain remain gates.
