armpitpete/merrin-voice-01/hardware/memory-core-prototype-a/05_MEMORY_GHOST_WET.kicad_sch

## KiCad design hardware/memory-core-prototype-a/05_MEMORY_GHOST_WET.kicad_sch (2026-07-25)

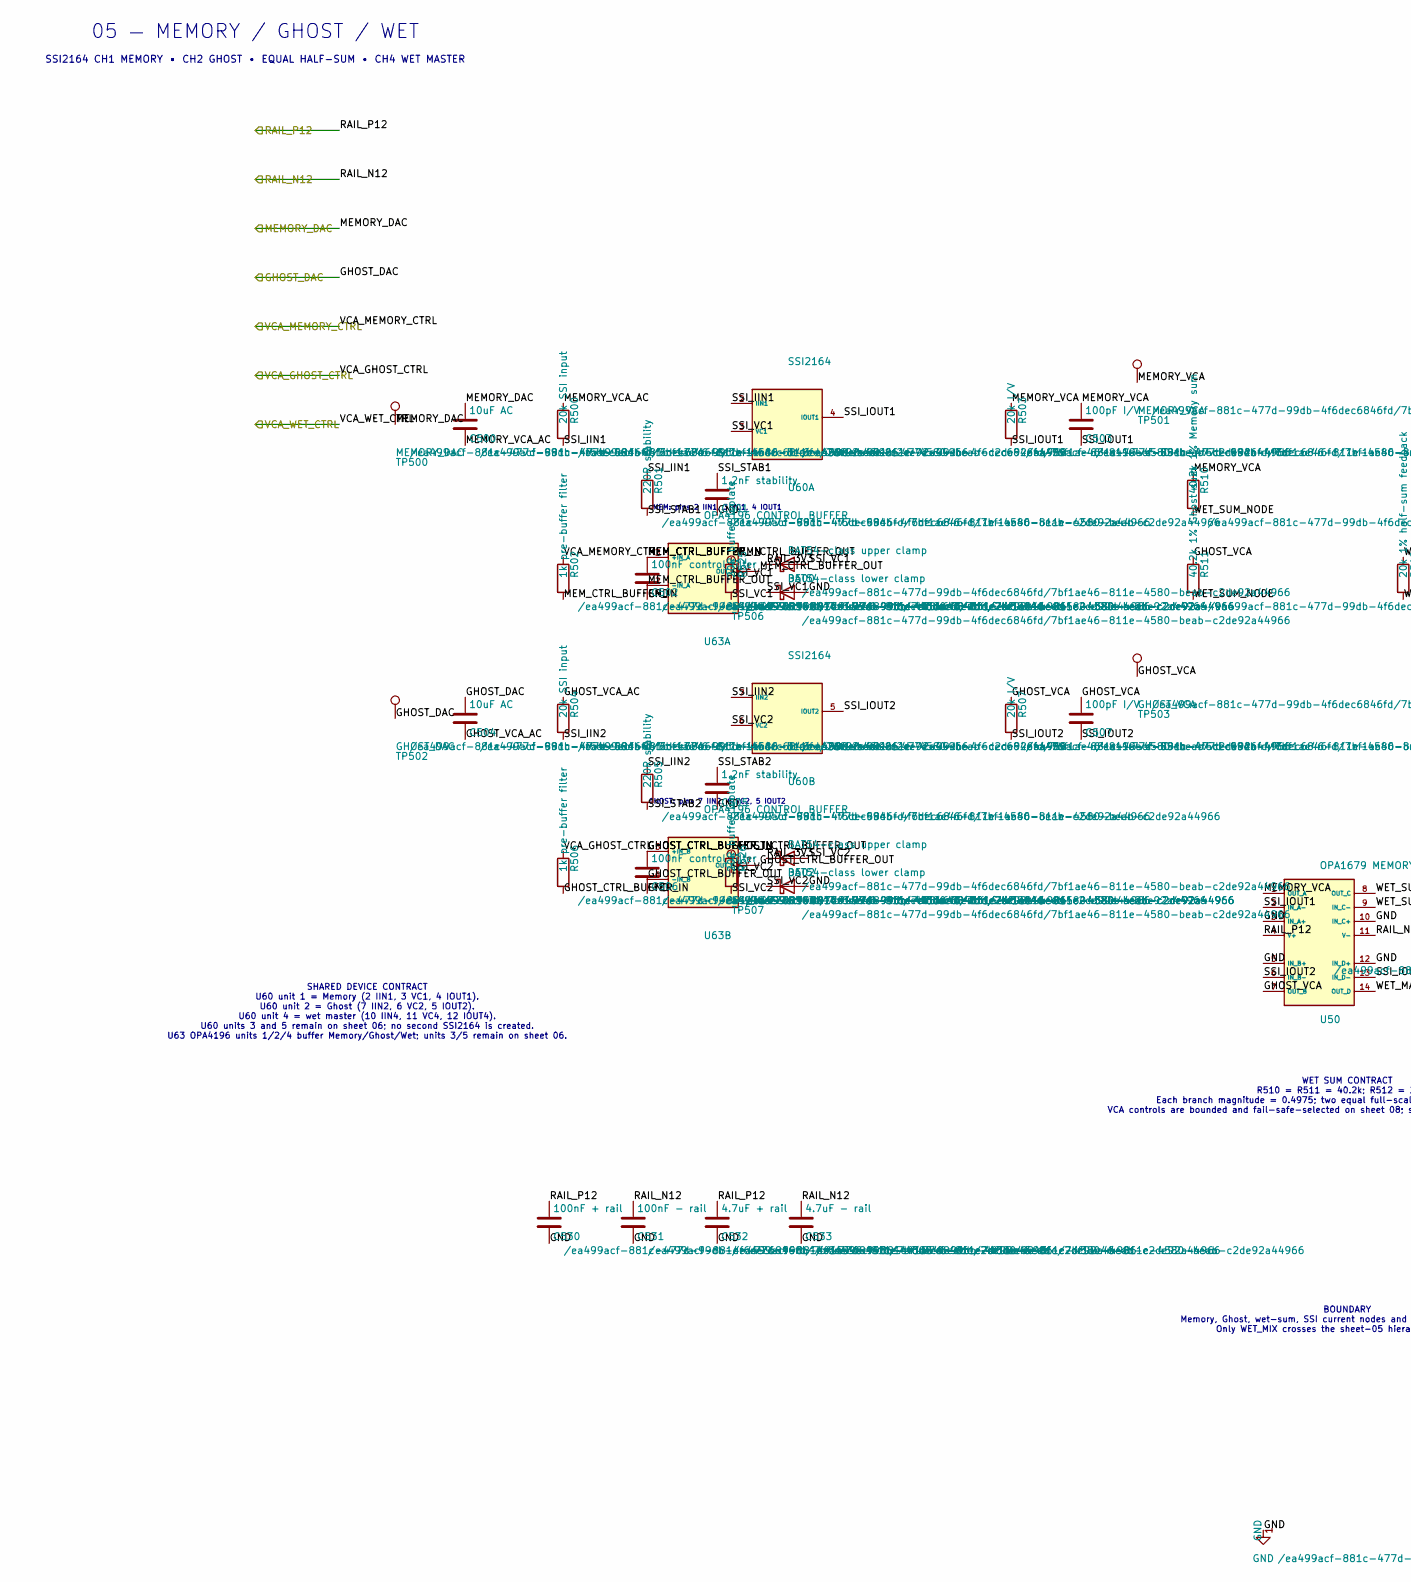
[picture p9: schematic 05_MEMORY_GHOST_WET.kicad_sch, part in row 1, column 1]

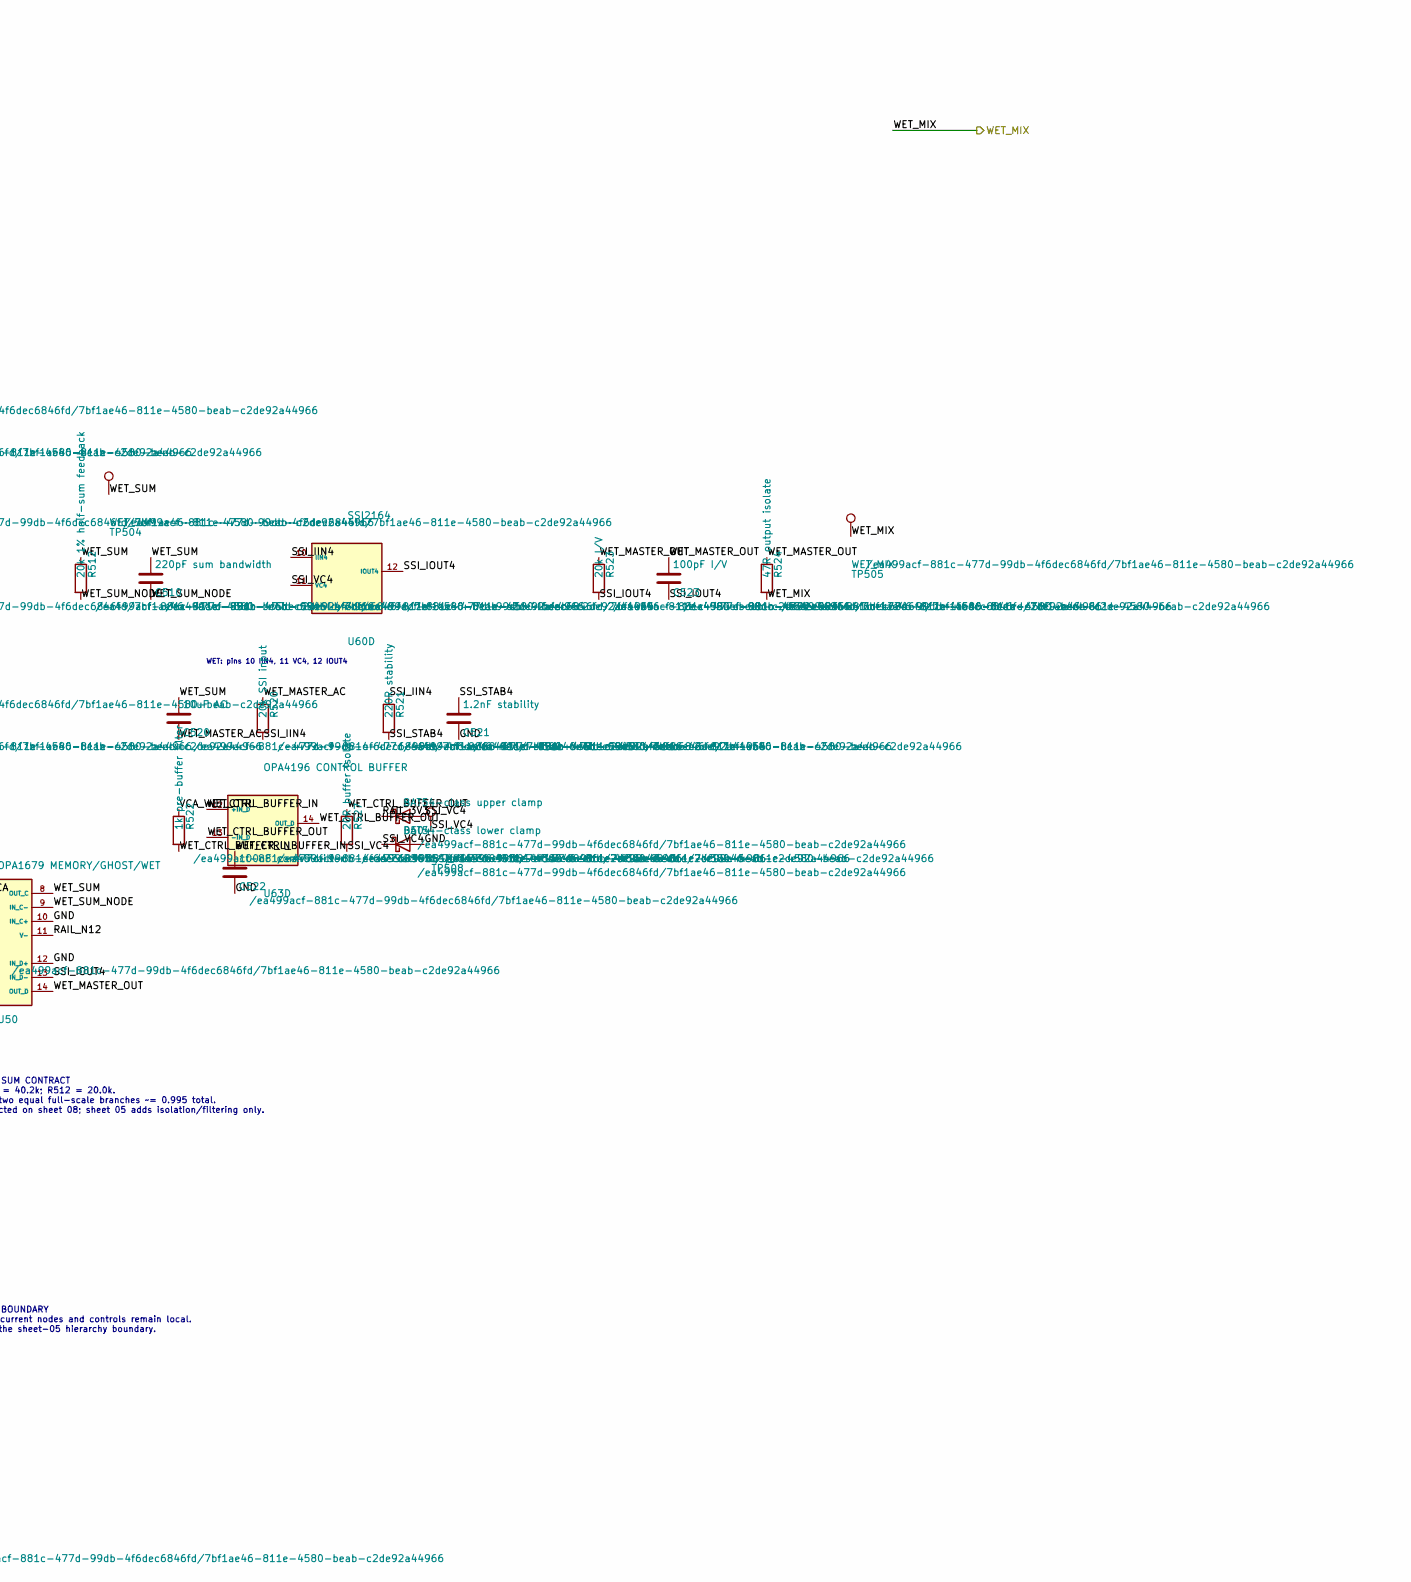
[picture p10: schematic 05_MEMORY_GHOST_WET.kicad_sch, part in row 1, column 2]

Parts:
C500, C504, C520: 10uF AC
C501, C505, C521: 1.2nF stability; C_0805_2012Metric
C502, C506, C522: 100nF control filter; C_0805_2012Metric
C503, C507, C523: 100pF I/V; C_0805_2012Metric
C510: 220pF sum bandwidth; C_0805_2012Metric
C530: 100nF + rail; C_0805_2012Metric
C531: 100nF - rail; C_0805_2012Metric
C532: 4.7uF + rail; C_0805_2012Metric
C533: 4.7uF - rail; C_0805_2012Metric
D500, D502, D504: BAT54-class upper clamp
D501, D503, D505: BAT54-class lower clamp
R500, R504, R520: 20k SSI input; R_0805_2012Metric
R501, R505, R521: 220R stability; R_0805_2012Metric
R502, R506, R522: 1k pre-buffer filter; R_0805_2012Metric
R503, R507, R523: 20k I/V; R_0805_2012Metric
R510: 40.2k 1% Memory sum; R_0805_2012Metric
R511: 40.2k 1% Ghost sum; R_0805_2012Metric
R512: 20k 1% half-sum feedback; R_0805_2012Metric
R524: 47R output isolate; R_0805_2012Metric
R525, R526, R527: 20R buffer isolate; R_0805_2012Metric
TP500: MEMORY_DAC
TP501: MEMORY_VCA
TP502: GHOST_DAC
TP503: GHOST_VCA
TP504: WET_SUM
TP505: WET_MIX
TP506: SSI_VC1
TP507: SSI_VC2
TP508: SSI_VC4
U50: OPA1679 MEMORY/GHOST/WET
U60: SSI2164
U63: OPA4196 CONTROL BUFFER

Connections:
GHOST_CTRL_BUFFER_IN: C506.1, R506.2, U63.5 (+IN_B)
GHOST_CTRL_BUFFER_OUT: R526.1, U63.6 (-IN_B), U63.7 (OUT_B)
GHOST_DAC: C504.1, TP502.1
GHOST_VCA: C507.1, R507.1, R511.1, TP503.1, U50.7 (OUT_B)
GHOST_VCA_AC: C504.2, R504.1
GND: C501.2, C502.2, C505.2, C506.2, C521.2, C522.2, C530.2, C531.2, C532.2, C533.2, D501.2 (A), D503.2 (A), D505.2 (A), U50.3 (IN_A+), U50.5 (IN_B+), U50.10 (IN_C+), U50.12 (IN_D+)
MEMORY_DAC: C500.1, TP500.1
MEMORY_VCA: C503.1, R503.1, R510.1, TP501.1, U50.1 (OUT_A)
MEMORY_VCA_AC: C500.2, R500.1
MEM_CTRL_BUFFER_IN: C502.1, R502.2, U63.3 (+IN_A)
MEM_CTRL_BUFFER_OUT: R525.1, U63.1 (OUT_A), U63.2 (-IN_A)
RAIL_3V3: D500.1 (K), D502.1 (K), D504.1 (K)
RAIL_N12: C531.1, C533.1, U50.11 (V-)
RAIL_P12: C530.1, C532.1, U50.4 (V+)
SSI_IIN1: R500.2, R501.1, U60.2 (IIN1)
SSI_IIN2: R504.2, R505.1, U60.7 (IIN2)
SSI_IIN4: R520.2, R521.1, U60.10 (IIN4)
SSI_IOUT1: C503.2, R503.2, U50.2 (IN_A-), U60.4 (IOUT1)
SSI_IOUT2: C507.2, R507.2, U50.6 (IN_B-), U60.5 (IOUT2)
SSI_IOUT4: C523.2, R523.2, U50.13 (IN_D-), U60.12 (IOUT4)
SSI_STAB1: C501.1, R501.2
SSI_STAB2: C505.1, R505.2
SSI_STAB4: C521.1, R521.2
SSI_VC1: D500.2 (A), D501.1 (K), R525.2, TP506.1, U60.3 (VC1)
SSI_VC2: D502.2 (A), D503.1 (K), R526.2, TP507.1, U60.6 (VC2)
SSI_VC4: D504.2 (A), D505.1 (K), R527.2, TP508.1, U60.11 (VC4)
VCA_GHOST_CTRL: R506.1
VCA_MEMORY_CTRL: R502.1
VCA_WET_CTRL: R522.1
WET_CTRL_BUFFER_IN: C522.1, R522.2, U63.12 (+IN_D)
WET_CTRL_BUFFER_OUT: R527.1, U63.13 (-IN_D), U63.14 (OUT_D)
WET_MASTER_AC: C520.2, R520.1
WET_MASTER_OUT: C523.1, R523.1, R524.1, U50.14 (OUT_D)
WET_MIX: R524.2, TP505.1
WET_SUM: C510.1, C520.1, R512.1, TP504.1, U50.8 (OUT_C)
WET_SUM_NODE: C510.2, R510.2, R511.2, R512.2, U50.9 (IN_C-)

Notes on the sheet:
05 — MEMORY / GHOST / WET
SSI2164 CH1 MEMORY • CH2 GHOST • EQUAL HALF-SUM • CH4 WET MASTER
MEM: pins 2 IIN1, 3 VC1, 4 IOUT1
GHOST: pins 7 IIN2, 6 VC2, 5 IOUT2
WET: pins 10 IIN4, 11 VC4, 12 IOUT4
SHARED DEVICE CONTRACT U60 unit 1 = Memory (2 IIN1, 3 VC1, 4 IOUT1). U60 unit 2 = Ghost (7 IIN2, 6 VC2, 5 IOUT2). U60 unit 4 = wet master (10 IIN4, 11 VC4, 12 IOUT4). U60 units 3 and 5 remain on sheet 06; no second SSI2164 is created. U63 OPA4196 units 1/2/4 buffer Memory/Ghost/Wet; units 3/5 remai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
WET SUM CONTRACT R510 = R511 = 40.2k; R512 = 20.0k. Each branch magnitude = 0.4975; two equal full-scale branches ~= 0.995 total. VCA controls are bounded and fail-safe-selected on sheet 08; sheet 05 adds isolation/filtering only.
BOUNDARY Memory, Ghost, wet-sum, SSI current nodes and controls remain local. Only WET_MIX crosses the sheet-05 hierarchy boundary.
