armpitpete/merrin-voice-01/hardware/memory-core-prototype-a/06_RETURN_BREAK_LIMITER.kicad_sch

## KiCad design hardware/memory-core-prototype-a/06_RETURN_BREAK_LIMITER.kicad_sch (2026-07-25)

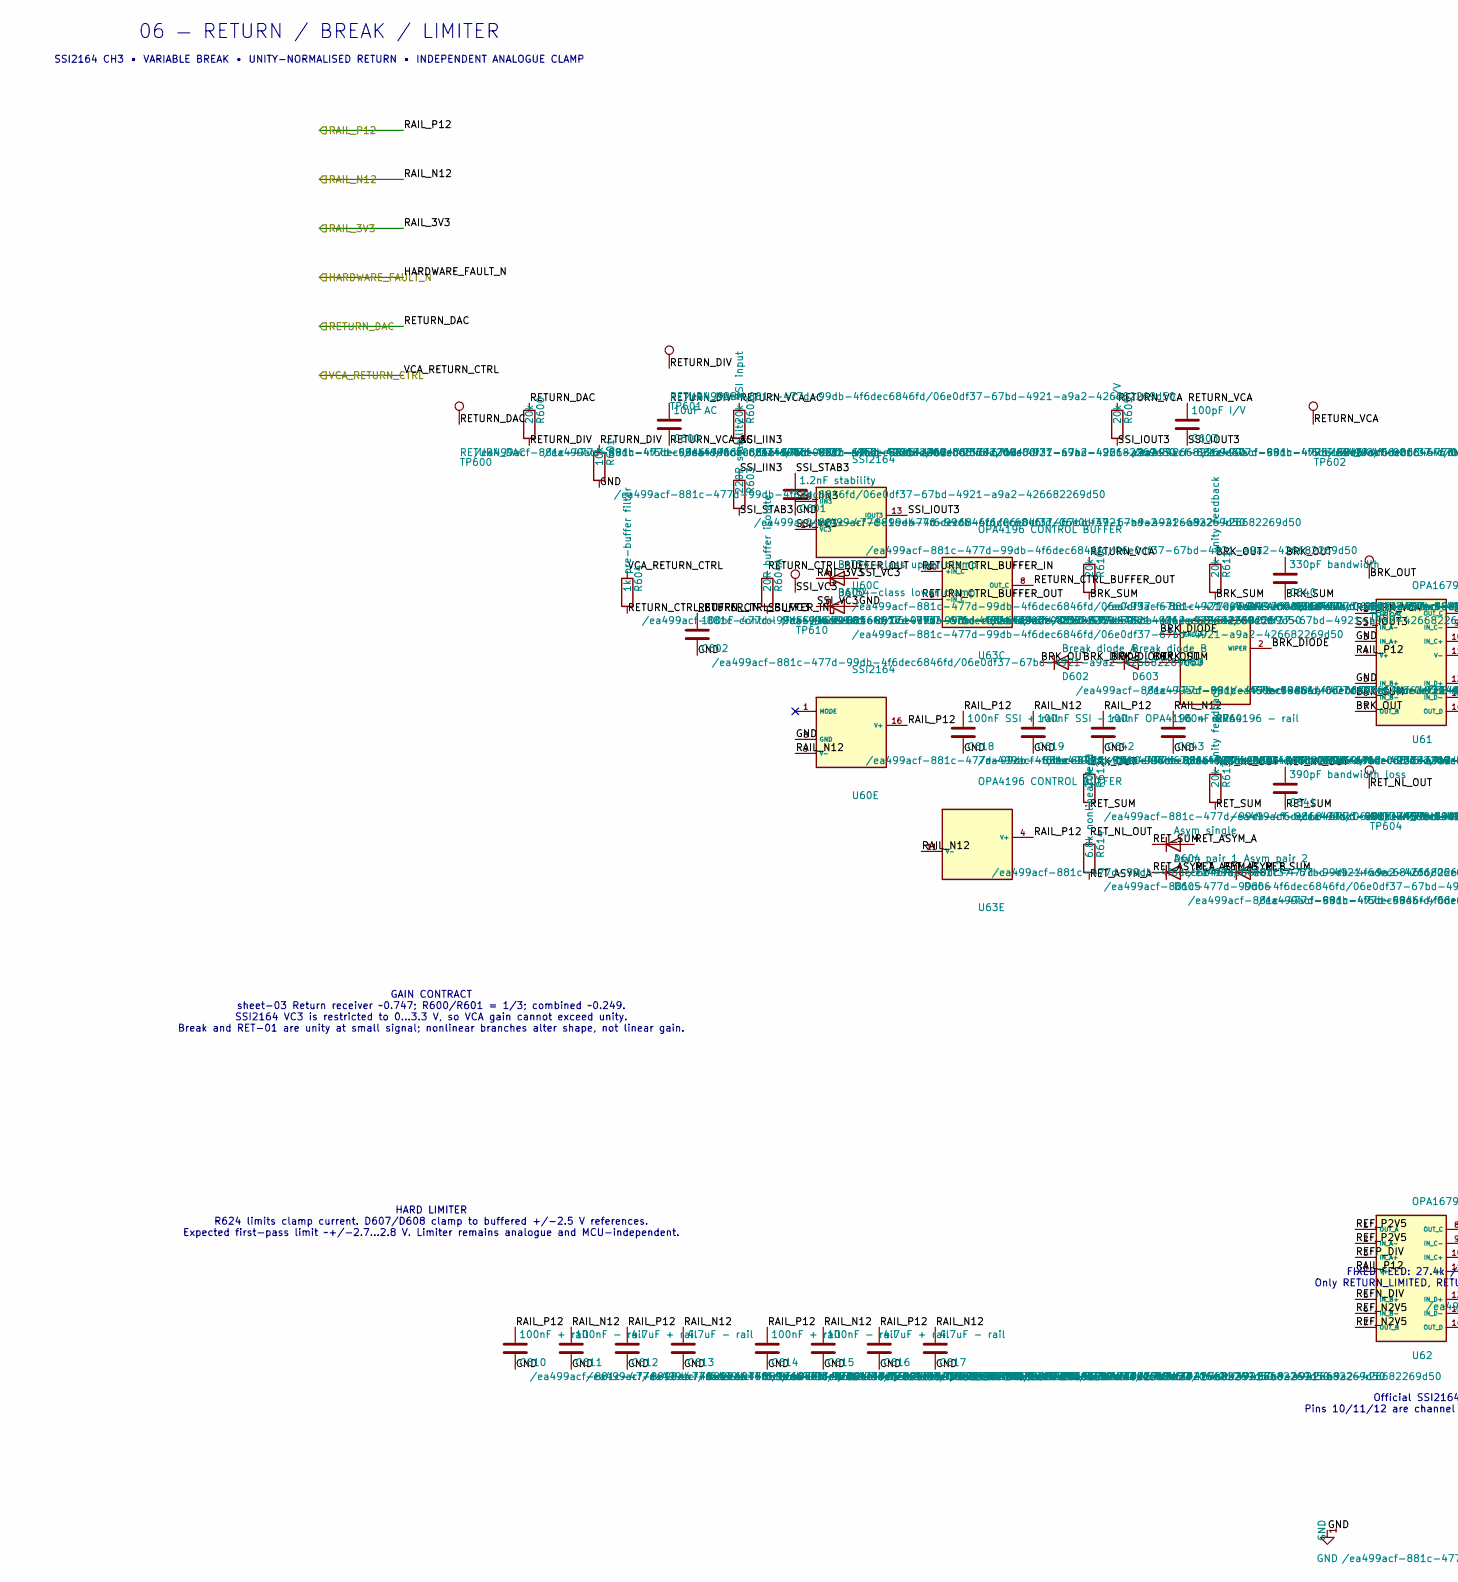
[picture p11: schematic 06_RETURN_BREAK_LIMITER.kicad_sch, part in row 1, column 1]

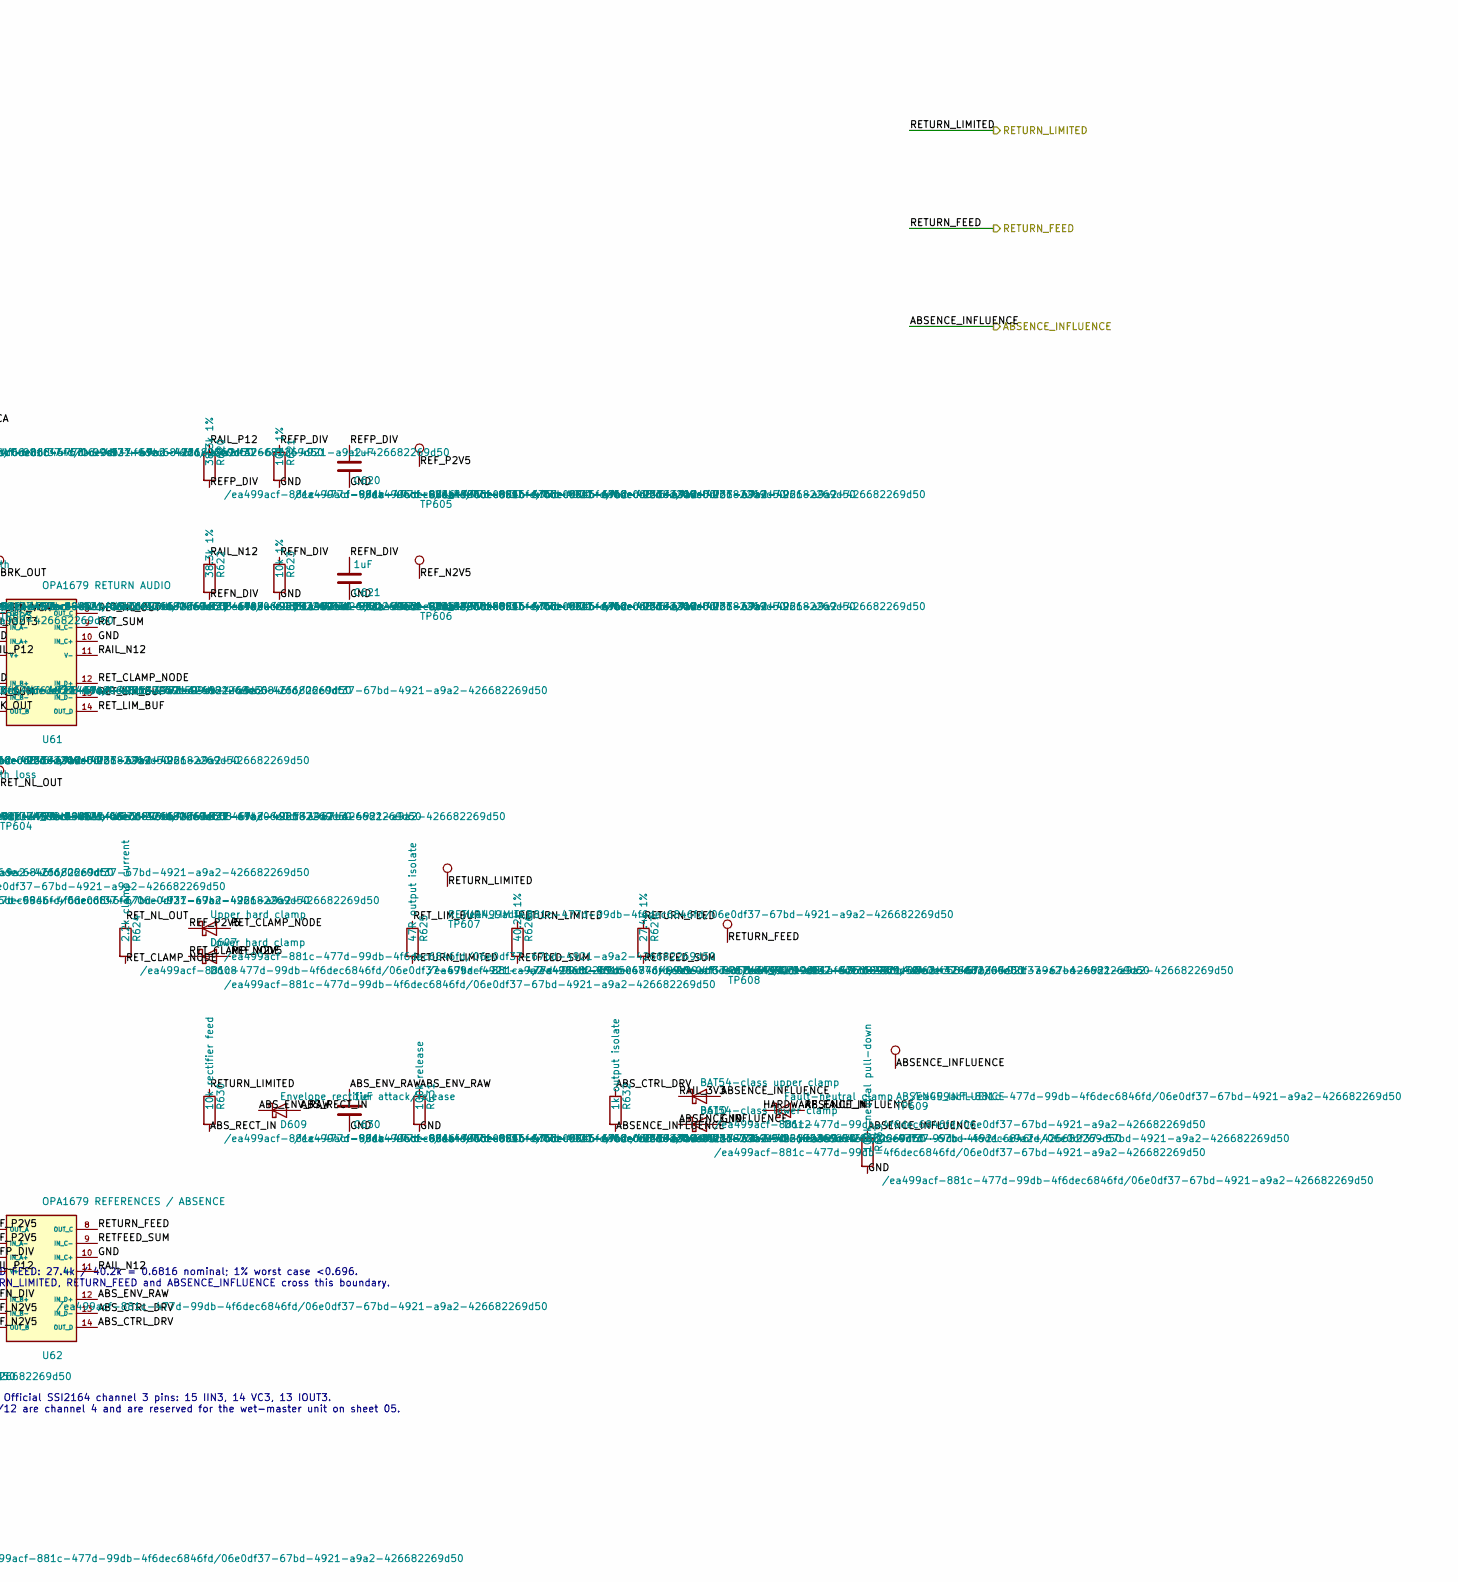
[picture p12: schematic 06_RETURN_BREAK_LIMITER.kicad_sch, part in row 1, column 2]

Parts:
C600: 10uF AC
C601: 1.2nF stability; C_0805_2012Metric
C602: 100nF control filter; C_0805_2012Metric
C603: 100pF I/V; C_0805_2012Metric
C610, C614: 100nF + rail; C_0805_2012Metric
C611, C615: 100nF - rail; C_0805_2012Metric
C612, C616: 4.7uF + rail; C_0805_2012Metric
C613, C617: 4.7uF - rail; C_0805_2012Metric
C618: 100nF SSI + rail; C_0805_2012Metric
C619: 100nF SSI - rail; C_0805_2012Metric
C620, C621: 1uF; C_0805_2012Metric
C630: 1uF attack/release; C_0805_2012Metric
C640: 330pF bandwidth; C_0805_2012Metric
C641: 390pF bandwidth loss; C_0805_2012Metric
C642: 100nF OPA4196 + rail; C_0805_2012Metric
C643: 100nF OPA4196 - rail; C_0805_2012Metric
D600, D610: BAT54-class upper clamp
D601, D611: BAT54-class lower clamp
D602: Break diode A
D603: Break diode B
D604: Asym single
D605: Asym pair 1
D606: Asym pair 2
D607: Upper hard clamp
D608: Lower hard clamp
D609: Envelope rectifier
D612: Fault-neutral clamp
R600, R610, R612: 20k; R_0805_2012Metric
R601: 10k; R_0805_2012Metric
R602: 20k SSI input; R_0805_2012Metric
R603: 220R stability; R_0805_2012Metric
R604: 1k pre-buffer filter; R_0805_2012Metric
R604A: 20R buffer isolate; R_0805_2012Metric
R605: 20k I/V; R_0805_2012Metric
R611, R613: 20k unity feedback; R_0805_2012Metric
R614: 6.8k nonlinear feed; R_0805_2012Metric
R620, R622: 38.3k 1%; R_0805_2012Metric
R621, R623: 10k 1%; R_0805_2012Metric
R624: 2.2k clamp current; R_0805_2012Metric
R625: 47R output isolate; R_0805_2012Metric
R626: 40.2k 1%; R_0805_2012Metric
R627: 27.4k 1%; R_0805_2012Metric
R630: 10k rectifier feed; R_0805_2012Metric
R631: 100k release; R_0805_2012Metric
R632: 1k output isolate; R_0805_2012Metric
R633: 100k neutral pull-down; R_0805_2012Metric
RV60: 100k BREAK AMOUNT
TP600: RETURN_DAC
TP601: RETURN_NORM
TP602: RETURN_VCA
TP603: BREAK
TP604: RETURN_NONLINEAR
TP605: +2V5_REF
TP606: -2V5_REF
TP607: RETURN_LIMITED
TP608: RETURN_FEED
TP609: ABSENCE_INFLUENCE
TP610: SSI_VC3
U60: SSI2164
U61: OPA1679 RETURN AUDIO
U62: OPA1679 REFERENCES / ABSENCE
U63: OPA4196 CONTROL BUFFER

Connections:
ABSENCE_INFLUENCE: D610.2 (A), D611.1 (K), D612.2 (A), R632.2, R633.1, TP609.1
ABS_CTRL_DRV: R632.1, U62.13 (IN_D-), U62.14 (OUT_D)
ABS_ENV_RAW: C630.1, D609.1 (K), R631.1, U62.12 (IN_D+)
ABS_RECT_IN: D609.2 (A), R630.2
BRK_DIODE: D602.2 (A), D603.1 (K), RV60.1 (END_A), RV60.2 (WIPER)
BRK_OUT: C640.1, D602.1 (K), D603.2 (A), R611.1, R612.1, TP603.1, U61.7 (OUT_B)
BRK_SUM: C640.2, R610.2, R611.2, RV60.3 (END_B), U61.6 (IN_B-)
GND: C601.2, C602.2, C610.2, C611.2, C612.2, C613.2, C614.2, C615.2, C616.2, C617.2, C618.2, C619.2, C620.2, C621.2, C630.2, C642.2, C643.2, D601.2 (A), D611.2 (A), R601.2, R621.2, R623.2, R631.2, R633.2, U60.8 (GND), U61.3 (IN_A+), U61.5 (IN_B+), U61.10 (IN_C+), U62.10 (IN_C+)
HARDWARE_FAULT_N: D612.1 (K)
RAIL_3V3: D600.1 (K), D610.1 (K)
RAIL_N12: C611.1, C613.1, C615.1, C617.1, C619.1, C643.1, R622.1, U60.9 (V-), U61.11 (V-), U62.11 (V-), U63.11 (V-)
RAIL_P12: C610.1, C612.1, C614.1, C616.1, C618.1, C642.1, R620.1, U60.16 (V+), U61.4 (V+), U62.4 (V+), U63.4 (V+)
REFN_DIV: C621.1, R622.2, R623.1, U62.5 (IN_B+)
REFP_DIV: C620.1, R620.2, R621.1, U62.3 (IN_A+)
REF_N2V5: D608.2 (A), TP606.1, U62.6 (IN_B-), U62.7 (OUT_B)
REF_P2V5: D607.1 (K), TP605.1, U62.1 (OUT_A), U62.2 (IN_A-)
RETFEED_SUM: R626.2, R627.2, U62.9 (IN_C-)
RETURN_CTRL_BUFFER_IN: C602.1, R604.2, U63.10 (+IN_C)
RETURN_CTRL_BUFFER_OUT: R604A.1, U63.8 (OUT_C), U63.9 (-IN_C)
RETURN_DAC: R600.1, TP600.1
RETURN_DIV: C600.1, R600.2, R601.1, TP601.1
RETURN_FEED: R627.1, TP608.1, U62.8 (OUT_C)
RETURN_LIMITED: R625.2, R626.1, R630.1, TP607.1
RETURN_VCA: C603.1, R605.1, R610.1, TP602.1, U61.1 (OUT_A)
RETURN_VCA_AC: C600.2, R602.1
RET_ASYM_A: D604.2 (A), D605.1 (K), R614.2
RET_ASYM_B: D605.2 (A), D606.1 (K)
RET_CLAMP_NODE: D607.2 (A), D608.1 (K), R624.2, U61.12 (IN_D+)
RET_LIM_BUF: R625.1, U61.13 (IN_D-), U61.14 (OUT_D)
RET_NL_OUT: C641.1, R613.1, R614.1, R624.1, TP604.1, U61.8 (OUT_C)
RET_SUM: C641.2, D604.1 (K), D606.2 (A), R612.2, R613.2, U61.9 (IN_C-)
SSI_IIN3: R602.2, R603.1, U60.15 (IIN3)
SSI_IOUT3: C603.2, R605.2, U60.13 (IOUT3), U61.2 (IN_A-)
SSI_STAB3: C601.1, R603.2
SSI_VC3: D600.2 (A), D601.1 (K), R604A.2, TP610.1, U60.14 (VC3)
VCA_RETURN_CTRL: R604.1

Notes on the sheet:
06 — RETURN / BREAK / LIMITER
SSI2164 CH3 • VARIABLE BREAK • UNITY-NORMALISED RETURN • INDEPENDENT ANALOGUE CLAMP
GAIN CONTRACT sheet-03 Return receiver ~0.747; R600/R601 = 1/3; combined ~0.249. SSI2164 VC3 is restricted to 0…3.3 V, so VCA gain cannot exceed unity. Break and RET-01 are unity at small signal; nonlinear branches alter shape, not linear gain.
HARD LIMITER R624 limits clamp current. D607/D608 clamp to buffered +/-2.5 V references. Expected first-pass limit ~+/-2.7…2.8 V. Limiter remains analogue and MCU-independent.
FIXED FEED: 27.4k / 40.2k = 0.6816 nominal; 1% worst case <0.696. Only RETURN_LIMITED, RETURN_FEED and ABSENCE_INFLUENCE cross this boundary.
Official SSI2164 channel 3 pins: 15 IIN3, 14 VC3, 13 IOUT3. Pins 10/11/12 are channel 4 and are reserved for the wet-master unit on sheet 05.
