armpitpete/merrin-voice-01/hardware/memory-core-prototype-a/07_OUTPUT_MUTE_PROTECTION.kicad_sch

## KiCad design hardware/memory-core-prototype-a/07_OUTPUT_MUTE_PROTECTION.kicad_sch (2026-07-16)

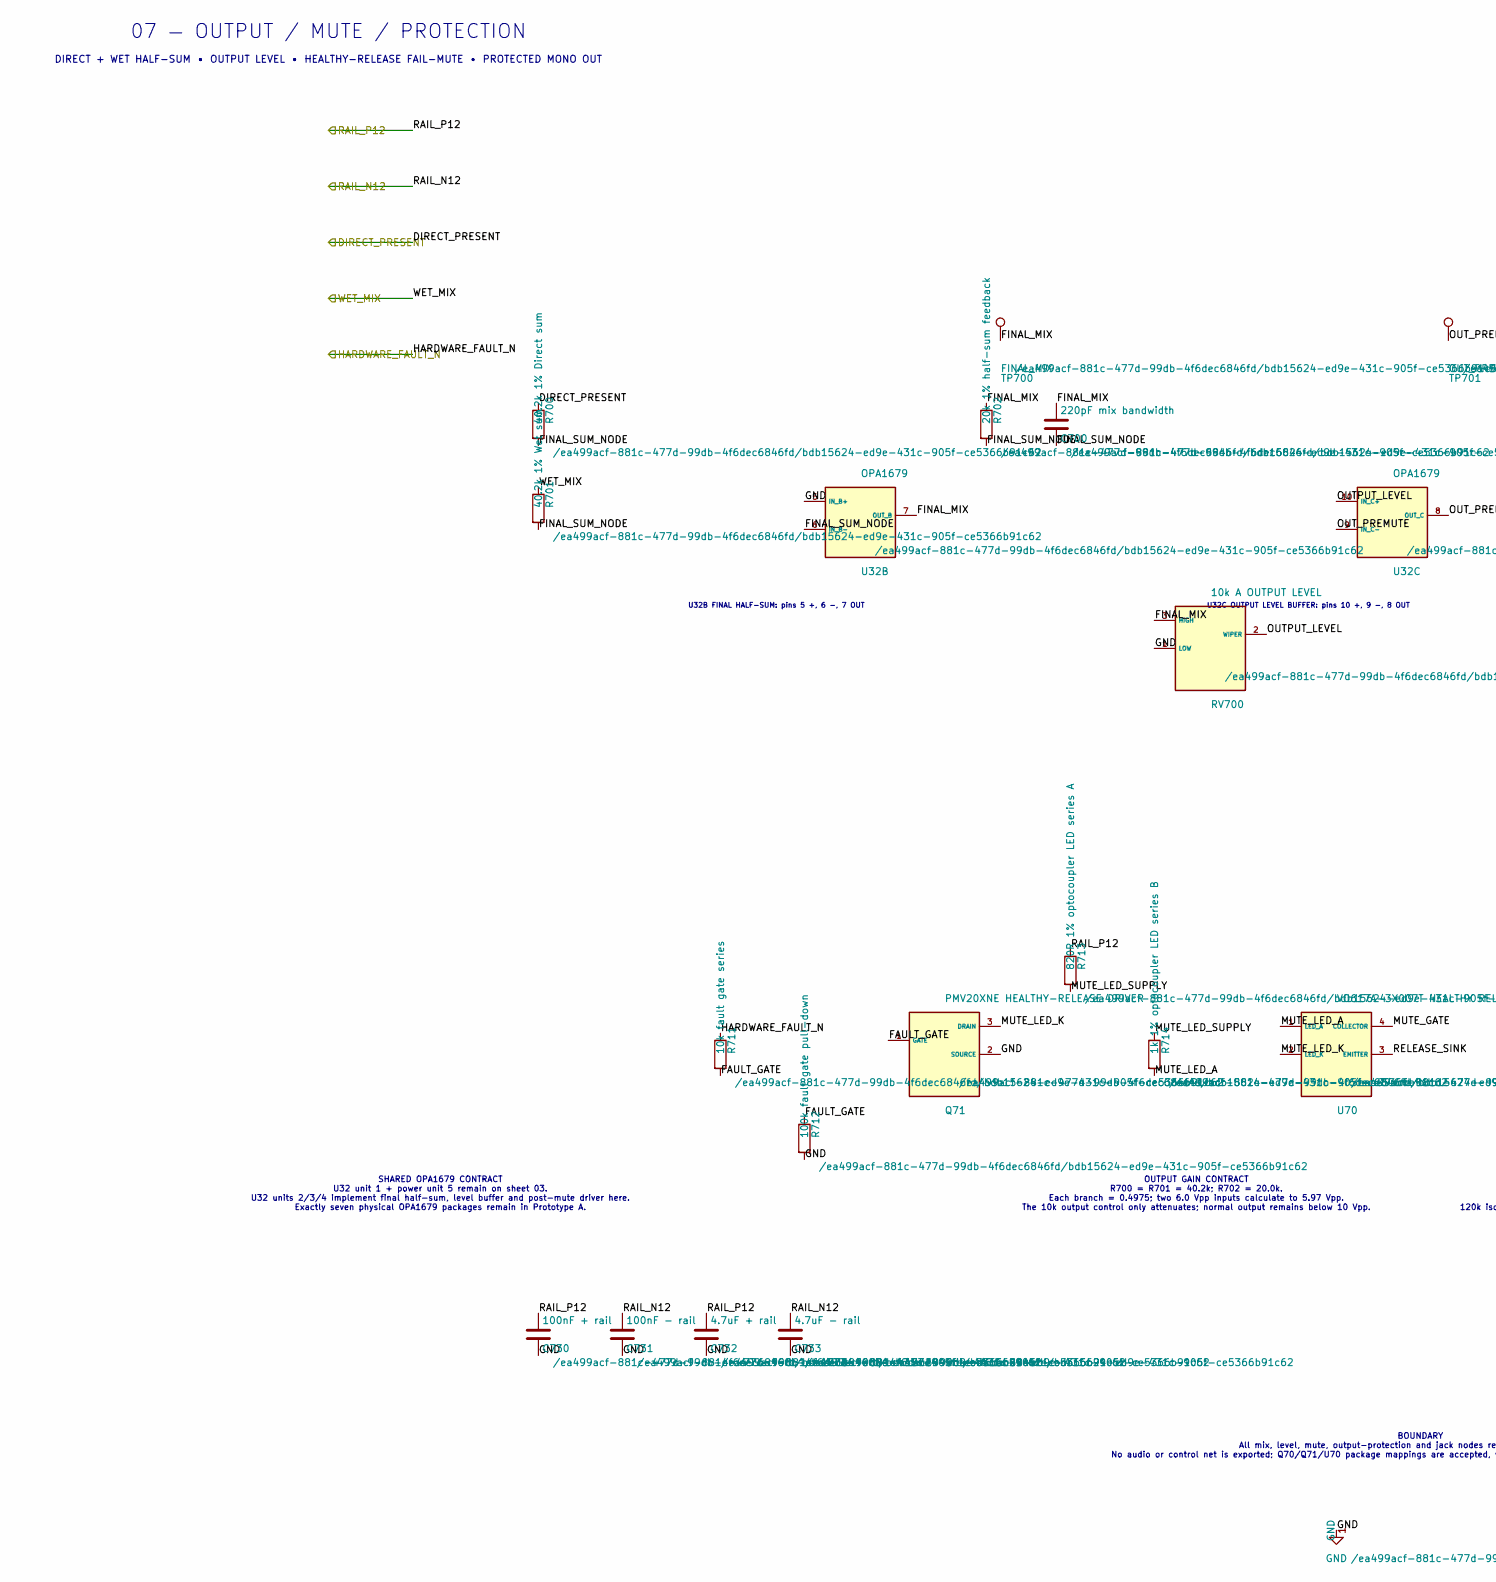
[picture p13: schematic 07_OUTPUT_MUTE_PROTECTION.kicad_sch, part in row 1, column 1]

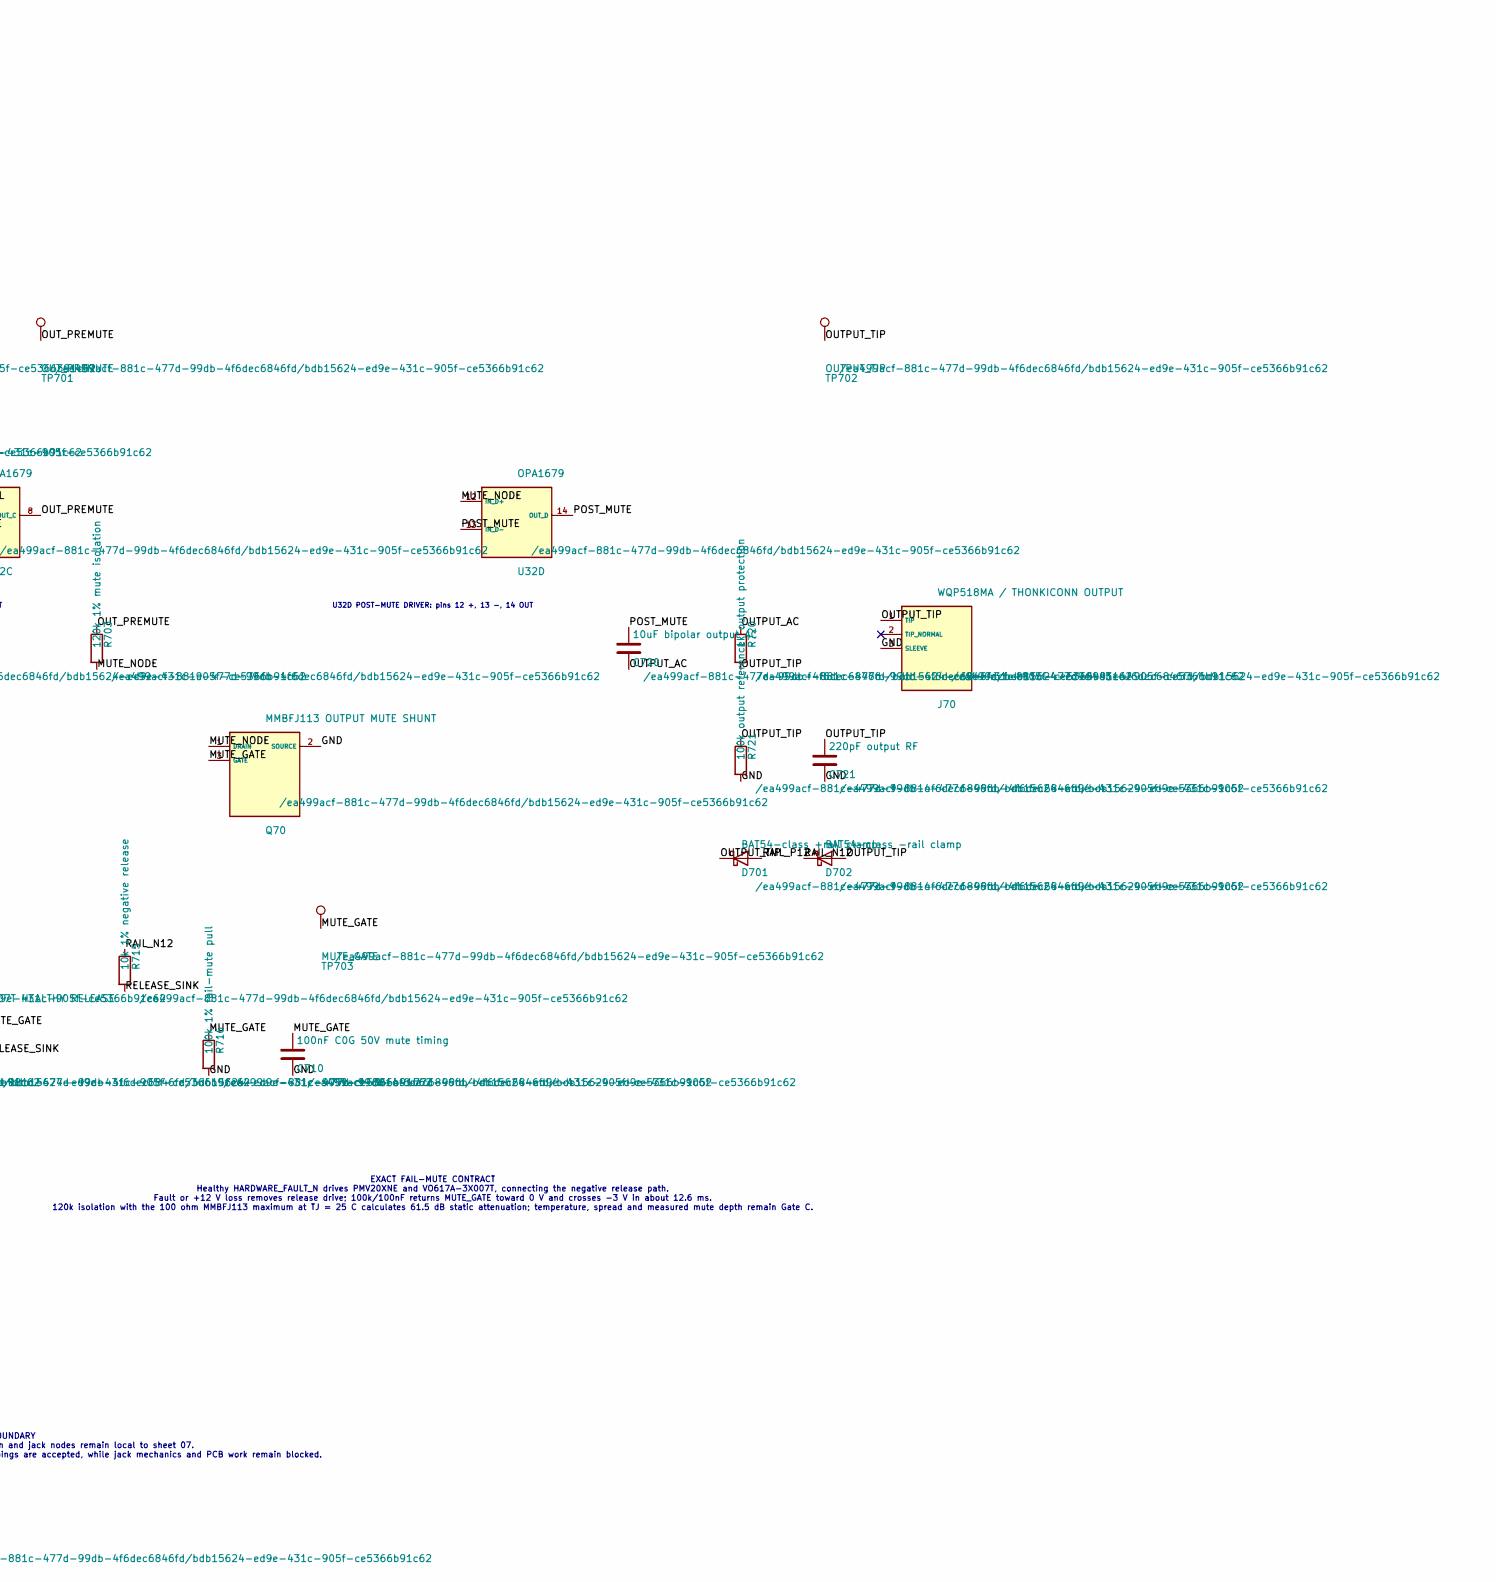
[picture p14: schematic 07_OUTPUT_MUTE_PROTECTION.kicad_sch, part in row 1, column 2]

Parts:
C700: 220pF mix bandwidth; C_0805_2012Metric
C710: 100nF C0G 50V mute timing; C_0805_2012Metric
C720: 10uF bipolar output AC
C721: 220pF output RF; C_0805_2012Metric
C730: 100nF + rail; C_0805_2012Metric
C731: 100nF - rail; C_0805_2012Metric
C732: 4.7uF + rail; C_0805_2012Metric
C733: 4.7uF - rail; C_0805_2012Metric
D701: BAT54-class +rail clamp
D702: BAT54-class -rail clamp
J70: WQP518MA / THONKICONN OUTPUT; Jack_3.5mm_Thonkiconn_WQP518MA_Numeric
Q70: MMBFJ113 OUTPUT MUTE SHUNT; SOT-23
Q71: PMV20XNE HEALTHY-RELEASE DRIVER; SOT-23
R700: 40.2k 1% Direct sum; R_0805_2012Metric
R701: 40.2k 1% Wet sum; R_0805_2012Metric
R702: 20k 1% half-sum feedback; R_0805_2012Metric
R703: 120k 1% mute isolation; R_0805_2012Metric
R711: 10k fault gate series; R_0805_2012Metric
R712: 100k fault gate pull-down; R_0805_2012Metric
R713: 820R 1% optocoupler LED series A; R_0805_2012Metric
R714: 1k 1% optocoupler LED series B; R_0805_2012Metric
R715: 10k 1% negative release; R_0805_2012Metric
R716: 100k 1% fail-mute pull; R_0805_2012Metric
R720: 1k output protection; R_0805_2012Metric
R721: 100k output reference; R_0805_2012Metric
RV700: 10k A OUTPUT LEVEL
TP700: FINAL_MIX
TP701: OUT_PREMUTE
TP702: OUTPUT_TIP
TP703: MUTE_GATE
U32: OPA1679
U70: VO617A-3X007T HEALTHY RELEASE; SMDIP-4_W7.62mm

Connections:
DIRECT_PRESENT: R700.1
FAULT_GATE: Q71.1 (GATE), R711.2, R712.1
FINAL_MIX: C700.1, R702.1, RV700.3 (HIGH), TP700.1, U32.7 (OUT_B)
FINAL_SUM_NODE: C700.2, R700.2, R701.2, R702.2, U32.6 (IN_B-)
GND: C710.2, C721.2, C730.2, C731.2, C732.2, C733.2, J70.3 (SLEEVE), Q70.2 (SOURCE), Q71.2 (SOURCE), R712.2, R716.2, R721.2, RV700.1 (LOW), U32.5 (IN_B+)
HARDWARE_FAULT_N: R711.1
MUTE_GATE: C710.1, Q70.3 (GATE), R716.1, TP703.1, U70.4 (COLLECTOR)
MUTE_LED_A: R714.2, U70.1 (LED_A)
MUTE_LED_K: Q71.3 (DRAIN), U70.2 (LED_K)
MUTE_LED_SUPPLY: R713.2, R714.1
MUTE_NODE: Q70.1 (DRAIN), R703.2, U32.12 (IN_D+)
OUTPUT_AC: C720.2, R720.1
OUTPUT_LEVEL: RV700.2 (WIPER), U32.10 (IN_C+)
OUTPUT_TIP: C721.1, D701.1 (K), D702.2 (A), J70.1 (TIP), R720.2, R721.1, TP702.1
OUT_PREMUTE: R703.1, TP701.1, U32.8 (OUT_C), U32.9 (IN_C-)
POST_MUTE: C720.1, U32.13 (IN_D-), U32.14 (OUT_D)
RAIL_N12: C731.1, C733.1, D702.1 (K), R715.1
RAIL_P12: C730.1, C732.1, D701.2 (A), R713.1
RELEASE_SINK: R715.2, U70.3 (EMITTER)
WET_MIX: R701.1

Notes on the sheet:
07 — OUTPUT / MUTE / PROTECTION
DIRECT + WET HALF-SUM • OUTPUT LEVEL • HEALTHY-RELEASE FAIL-MUTE • PROTECTED MONO OUT
U32B FINAL HALF-SUM: pins 5 +, 6 -, 7 OUT
U32C OUTPUT LEVEL BUFFER: pins 10 +, 9 -, 8 OUT
U32D POST-MUTE DRIVER: pins 12 +, 13 -, 14 OUT
SHARED OPA1679 CONTRACT U32 unit 1 + power unit 5 remain on sheet 03. U32 units 2/3/4 implement final half-sum, level buffer and post-mute driver here. Exactly seven physical OPA1679 packages remain in Prototype A.
OUTPUT GAIN CONTRACT R700 = R701 = 40.2k; R702 = 20.0k. Each branch = 0.4975; two 6.0 Vpp inputs calculate to 5.97 Vpp. The 10k output control only attenuates; normal output remains below 10 Vpp.
EXACT FAIL-MUTE CONTRACT Healthy HARDWARE_FAULT_N drives PMV20XNE and VO617A-3X007T, connecting the negative release path. Fault or +12 V loss removes release drive; 100k/100nF returns MUTE_GATE toward 0 V and crosses -3 V in about 12.6 ms. 120k isolation with the 100 ohm MMBFJ113 maximum at TJ = 2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
BOUNDARY All mix, level, mute, output-protection and jack nodes remain local to sheet 07. No audio or control net is exported; Q70/Q71/U70 package mappings are accepted, while jack mechanics and PCB work remain blocked.
