armpitpete/merrin-voice-01/hardware/memory-core-prototype-a/08_CONTROLS_STATE.kicad_sch

## KiCad design hardware/memory-core-prototype-a/08_CONTROLS_STATE.kicad_sch (2026-07-14)

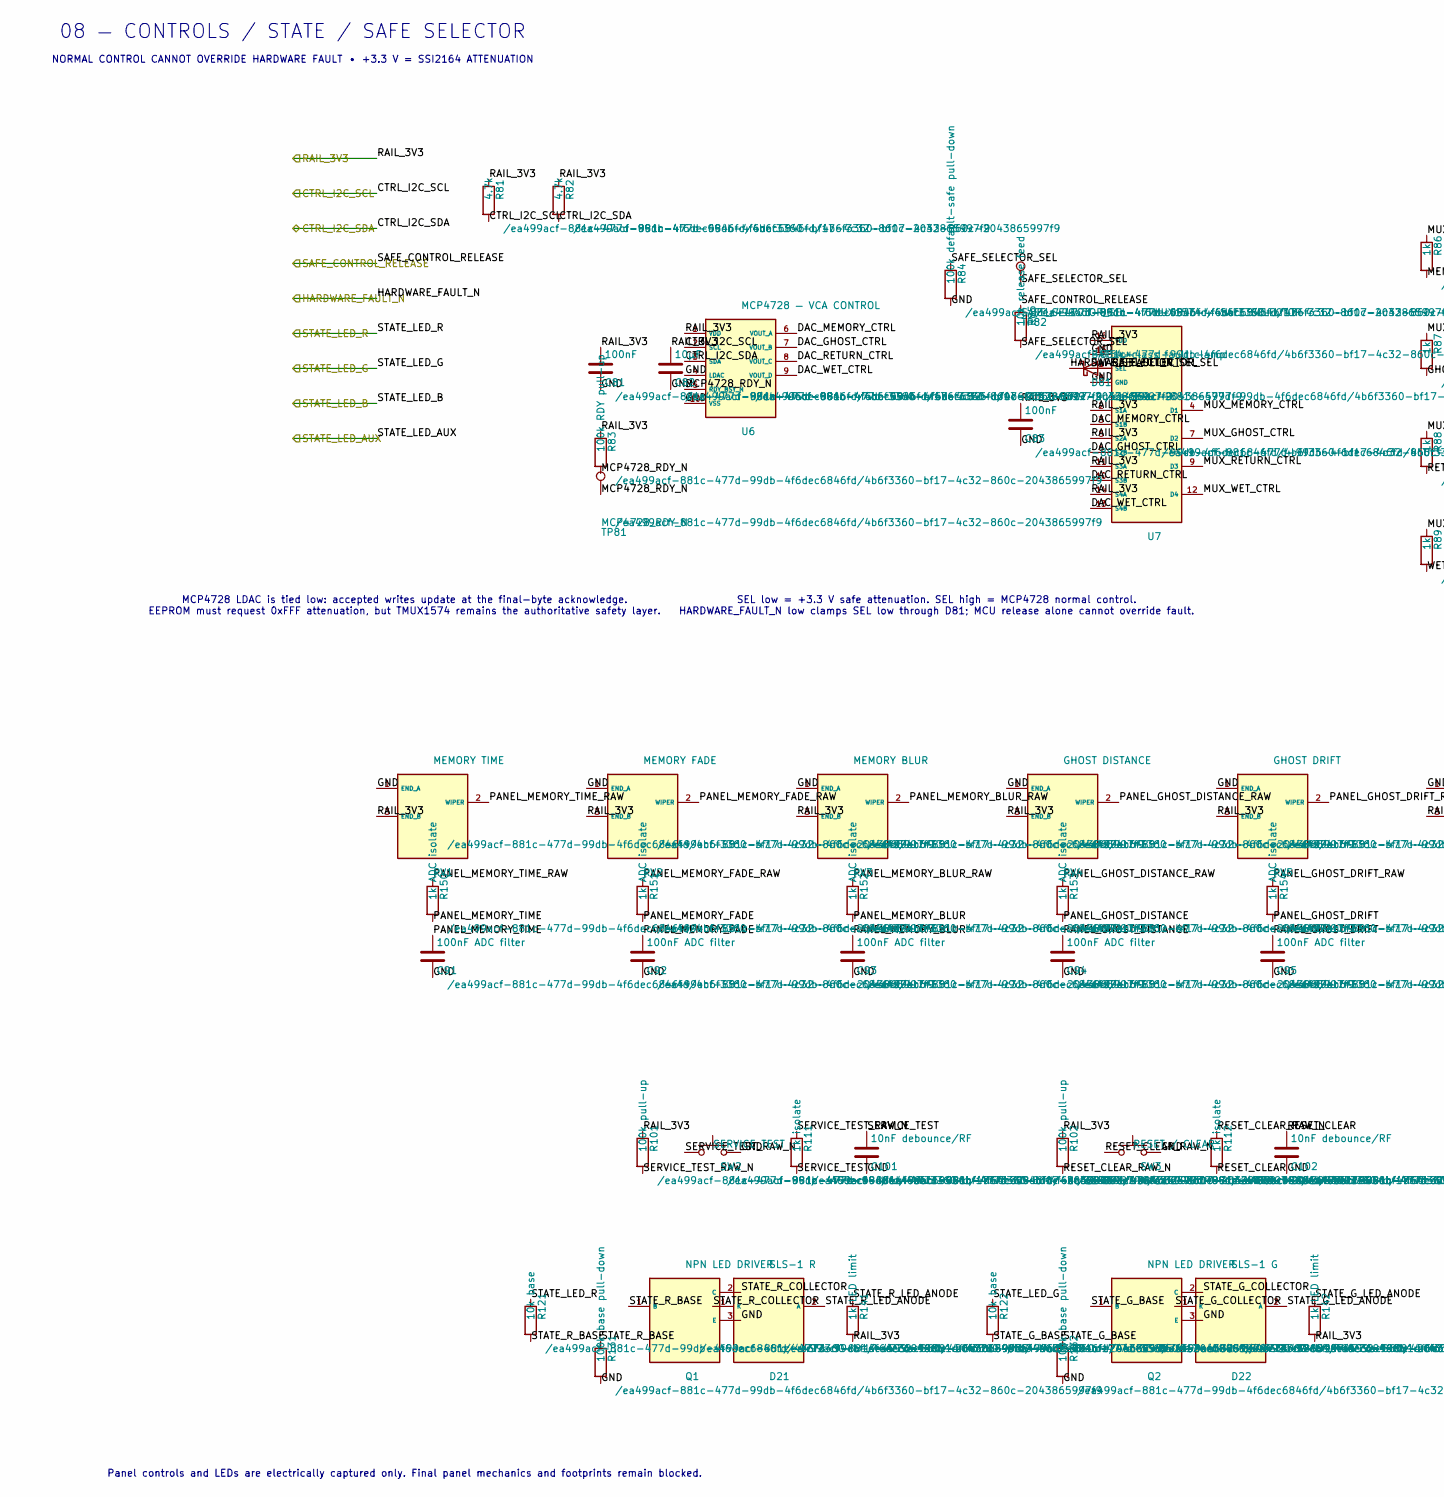
[picture p15: schematic 08_CONTROLS_STATE.kicad_sch, part in row 1, column 1]

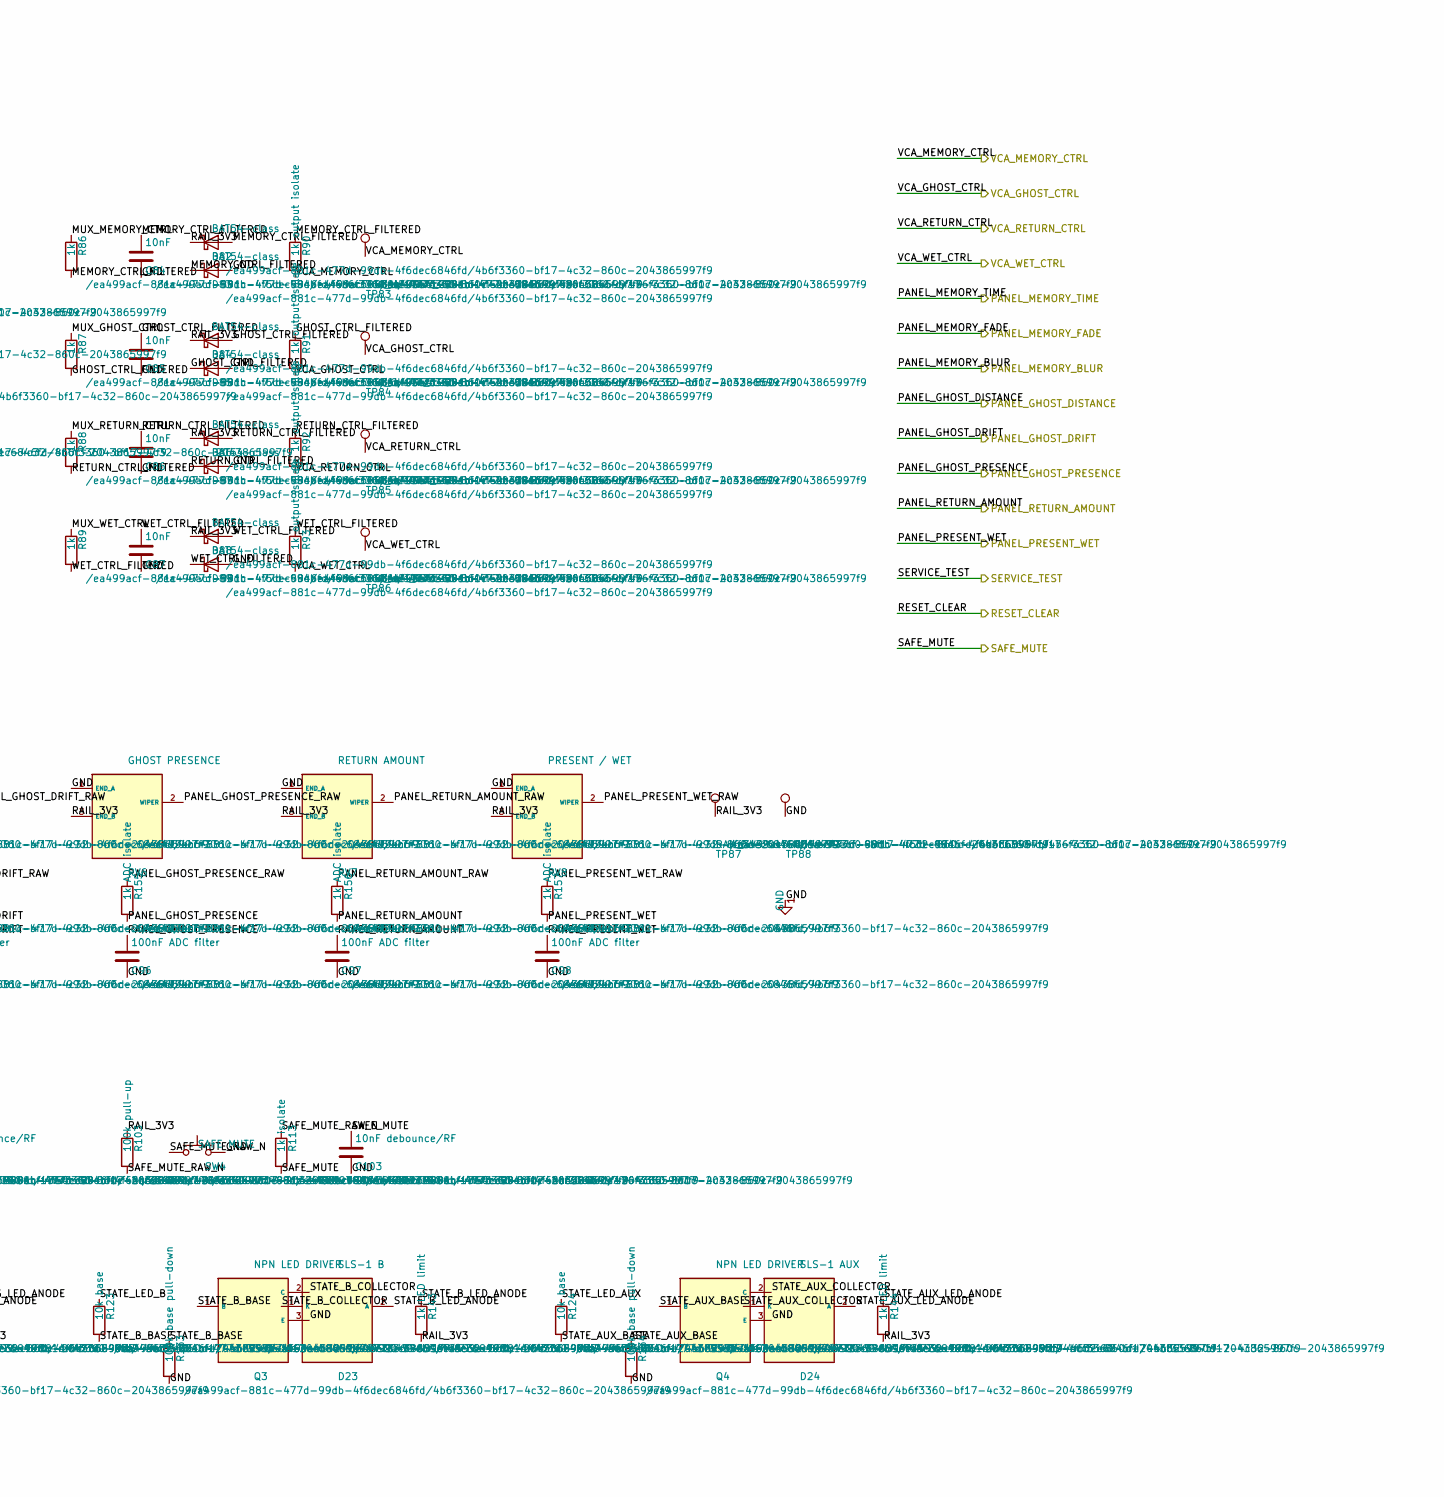
[picture p16: schematic 08_CONTROLS_STATE.kicad_sch, part in row 1, column 2]

Parts:
C81, C83: 100nF; C_0805_2012Metric
C82: 10µF; C_0805_2012Metric
C84, C85, C86, C87: 10nF; C_0805_2012Metric
C91, C92, C93, C94, C95, C96, C97, C98: 100nF ADC filter; C_0805_2012Metric
C101, C102, C103: 10nF debounce/RF; C_0805_2012Metric
D21: SLS-1 R
D22: SLS-1 G
D23: SLS-1 B
D24: SLS-1 AUX
D81: BAT54-class fault clamp
D82, D83, D84, D85, D86, D87, D88, D89: BAT54-class
Q1, Q2, Q3, Q4: NPN LED DRIVER
R81, R82: 4.7k; R_0805_2012Metric
R83: 100k RDY pull-up; R_0805_2012Metric
R84: 100k default-safe pull-down; R_0805_2012Metric
R85: 10k release feed; R_0805_2012Metric
R86, R87, R88, R89: 1k; R_0805_2012Metric
R90, R91, R92, R93: 1k output isolate; R_0805_2012Metric
R101, R102, R103: 100k pull-up; R_0805_2012Metric
R111, R112, R113: 1k isolate; R_0805_2012Metric
R121, R122, R123, R124: 10k base; R_0805_2012Metric
R131, R132, R133, R134: 100k base pull-down; R_0805_2012Metric
R141, R142, R143, R144: 1k LED limit; R_0805_2012Metric
R150, R151, R152, R153, R154, R155, R156, R157: 1k ADC isolate; R_0805_2012Metric
RV1: MEMORY TIME
RV2: MEMORY FADE
RV3: MEMORY BLUR
RV4: GHOST DISTANCE
RV5: GHOST DRIFT
RV6: GHOST PRESENCE
RV7: RETURN AMOUNT
RV8: PRESENT / WET
SW2: SERVICE TEST
SW3: RESET / CLEAR
SW4: SAFE MUTE
TP81: MCP4728_RDY_N
TP82: SAFE_SELECTOR_SEL
TP83: VCA_MEMORY_CTRL
TP84: VCA_GHOST_CTRL
TP85: VCA_RETURN_CTRL
TP86: VCA_WET_CTRL
TP87: RAIL_3V3
TP88: GND
U6: MCP4728 — VCA CONTROL
U7: TMUX1574 — SAFE SELECTOR

Connections:
CTRL_I2C_SCL: R81.2, U6.2 (SCL)
CTRL_I2C_SDA: R82.2, U6.3 (SDA)
DAC_GHOST_CTRL: U6.7 (VOUT_B), U7.6 (S2B)
DAC_MEMORY_CTRL: U6.6 (VOUT_A), U7.3 (S1B)
DAC_RETURN_CTRL: U6.8 (VOUT_C), U7.10 (S3B)
DAC_WET_CTRL: U6.9 (VOUT_D), U7.13 (S4B)
GHOST_CTRL_FILTERED: C85.1, D84.2 (A), D85.1 (K), R87.2, R91.1
GND: C81.2, C82.2, C83.2, C84.2, C85.2, C86.2, C87.2, C91.2, C92.2, C93.2, C94.2, C95.2, C96.2, C97.2, C98.2, C101.2, C102.2, C103.2, D83.2 (A), D85.2 (A), D87.2 (A), D89.2 (A), Q1.3 (E), Q2.3 (E), Q3.3 (E), Q4.3 (E), R84.2, R131.2, R132.2, R133.2, R134.2, RV1.1 (END_A), RV2.1 (END_A), RV3.1 (END_A), RV4.1 (END_A), RV5.1 (END_A), RV6.1 (END_A), RV7.1 (END_A), RV8.1 (END_A), SW2.2, SW3.2, SW4.2, TP88.1, U6.4 (LDAC), U6.10 (VSS), U7.8 (GND), U7.15 (EN_N)
HARDWARE_FAULT_N: D81.1 (K)
MCP4728_RDY_N: R83.2, TP81.1, U6.5 (RDY_BSY_N)
MEMORY_CTRL_FILTERED: C84.1, D82.2 (A), D83.1 (K), R86.2, R90.1
MUX_GHOST_CTRL: R87.1, U7.7 (D2)
MUX_MEMORY_CTRL: R86.1, U7.4 (D1)
MUX_RETURN_CTRL: R88.1, U7.9 (D3)
MUX_WET_CTRL: R89.1, U7.12 (D4)
PANEL_GHOST_DISTANCE: C94.1, R153.2
PANEL_GHOST_DISTANCE_RAW: R153.1, RV4.2 (WIPER)
PANEL_GHOST_DRIFT: C95.1, R154.2
PANEL_GHOST_DRIFT_RAW: R154.1, RV5.2 (WIPER)
PANEL_GHOST_PRESENCE: C96.1, R155.2
PANEL_GHOST_PRESENCE_RAW: R155.1, RV6.2 (WIPER)
PANEL_MEMORY_BLUR: C93.1, R152.2
PANEL_MEMORY_BLUR_RAW: R152.1, RV3.2 (WIPER)
PANEL_MEMORY_FADE: C92.1, R151.2
PANEL_MEMORY_FADE_RAW: R151.1, RV2.2 (WIPER)
PANEL_MEMORY_TIME: C91.1, R150.2
PANEL_MEMORY_TIME_RAW: R150.1, RV1.2 (WIPER)
PANEL_PRESENT_WET: C98.1, R157.2
PANEL_PRESENT_WET_RAW: R157.1, RV8.2 (WIPER)
PANEL_RETURN_AMOUNT: C97.1, R156.2
PANEL_RETURN_AMOUNT_RAW: R156.1, RV7.2 (WIPER)
RAIL_3V3: C81.1, C82.1, C83.1, D82.1 (K), D84.1 (K), D86.1 (K), D88.1 (K), R81.1, R82.1, R83.1, R101.1, R102.1, R103.1, R141.2, R142.2, R143.2, R144.2, RV1.3 (END_B), RV2.3 (END_B), RV3.3 (END_B), RV4.3 (END_B), RV5.3 (END_B), RV6.3 (END_B), RV7.3 (END_B), RV8.3 (END_B), TP87.1, U6.1 (VDD), U7.2 (S1A), U7.5 (S2A), U7.11 (S3A), U7.14 (S4A), U7.16 (VDD)
RESET_CLEAR: C102.1, R112.2
RESET_CLEAR_RAW_N: R102.2, R112.1, SW3.1
RETURN_CTRL_FILTERED: C86.1, D86.2 (A), D87.1 (K), R88.2, R92.1
SAFE_CONTROL_RELEASE: R85.1
SAFE_MUTE: C103.1, R113.2
SAFE_MUTE_RAW_N: R103.2, R113.1, SW4.1
SAFE_SELECTOR_SEL: D81.2 (A), R84.1, R85.2, TP82.1, U7.1 (SEL)
SERVICE_TEST: C101.1, R111.2
SERVICE_TEST_RAW_N: R101.2, R111.1, SW2.1
STATE_AUX_BASE: Q4.1 (B), R124.2, R134.1
STATE_AUX_COLLECTOR: D24.1 (K), Q4.2 (C)
STATE_AUX_LED_ANODE: D24.2 (A), R144.1
STATE_B_BASE: Q3.1 (B), R123.2, R133.1
STATE_B_COLLECTOR: D23.1 (K), Q3.2 (C)
STATE_B_LED_ANODE: D23.2 (A), R143.1
STATE_G_BASE: Q2.1 (B), R122.2, R132.1
STATE_G_COLLECTOR: D22.1 (K), Q2.2 (C)
STATE_G_LED_ANODE: D22.2 (A), R142.1
STATE_LED_AUX: R124.1
STATE_LED_B: R123.1
STATE_LED_G: R122.1
STATE_LED_R: R121.1
STATE_R_BASE: Q1.1 (B), R121.2, R131.1
STATE_R_COLLECTOR: D21.1 (K), Q1.2 (C)
STATE_R_LED_ANODE: D21.2 (A), R141.1
VCA_GHOST_CTRL: R91.2, TP84.1
VCA_MEMORY_CTRL: R90.2, TP83.1
VCA_RETURN_CTRL: R92.2, TP85.1
VCA_WET_CTRL: R93.2, TP86.1
WET_CTRL_FILTERED: C87.1, D88.2 (A), D89.1 (K), R89.2, R93.1

Notes on the sheet:
08 — CONTROLS / STATE / SAFE SELECTOR
NORMAL CONTROL CANNOT OVERRIDE HARDWARE FAULT • +3.3 V = SSI2164 ATTENUATION
MCP4728 LDAC is tied low: accepted writes update at the final-byte acknowledge. EEPROM must request 0xFFF attenuation, but TMUX1574 remains the authoritative safety layer.
SEL low = +3.3 V safe attenuation. SEL high = MCP4728 normal control. HARDWARE_FAULT_N low clamps SEL low through D81; MCU release alone cannot override fault.
Panel controls and LEDs are electrically captured only. Final panel mechanics and footprints remain blocked.
