armpitpete/merrin-voice-01/hardware/memory-core-prototype-a/09_TEST_SERVICE.kicad_sch

## KiCad design hardware/memory-core-prototype-a/09_TEST_SERVICE.kicad_sch (2026-07-14)

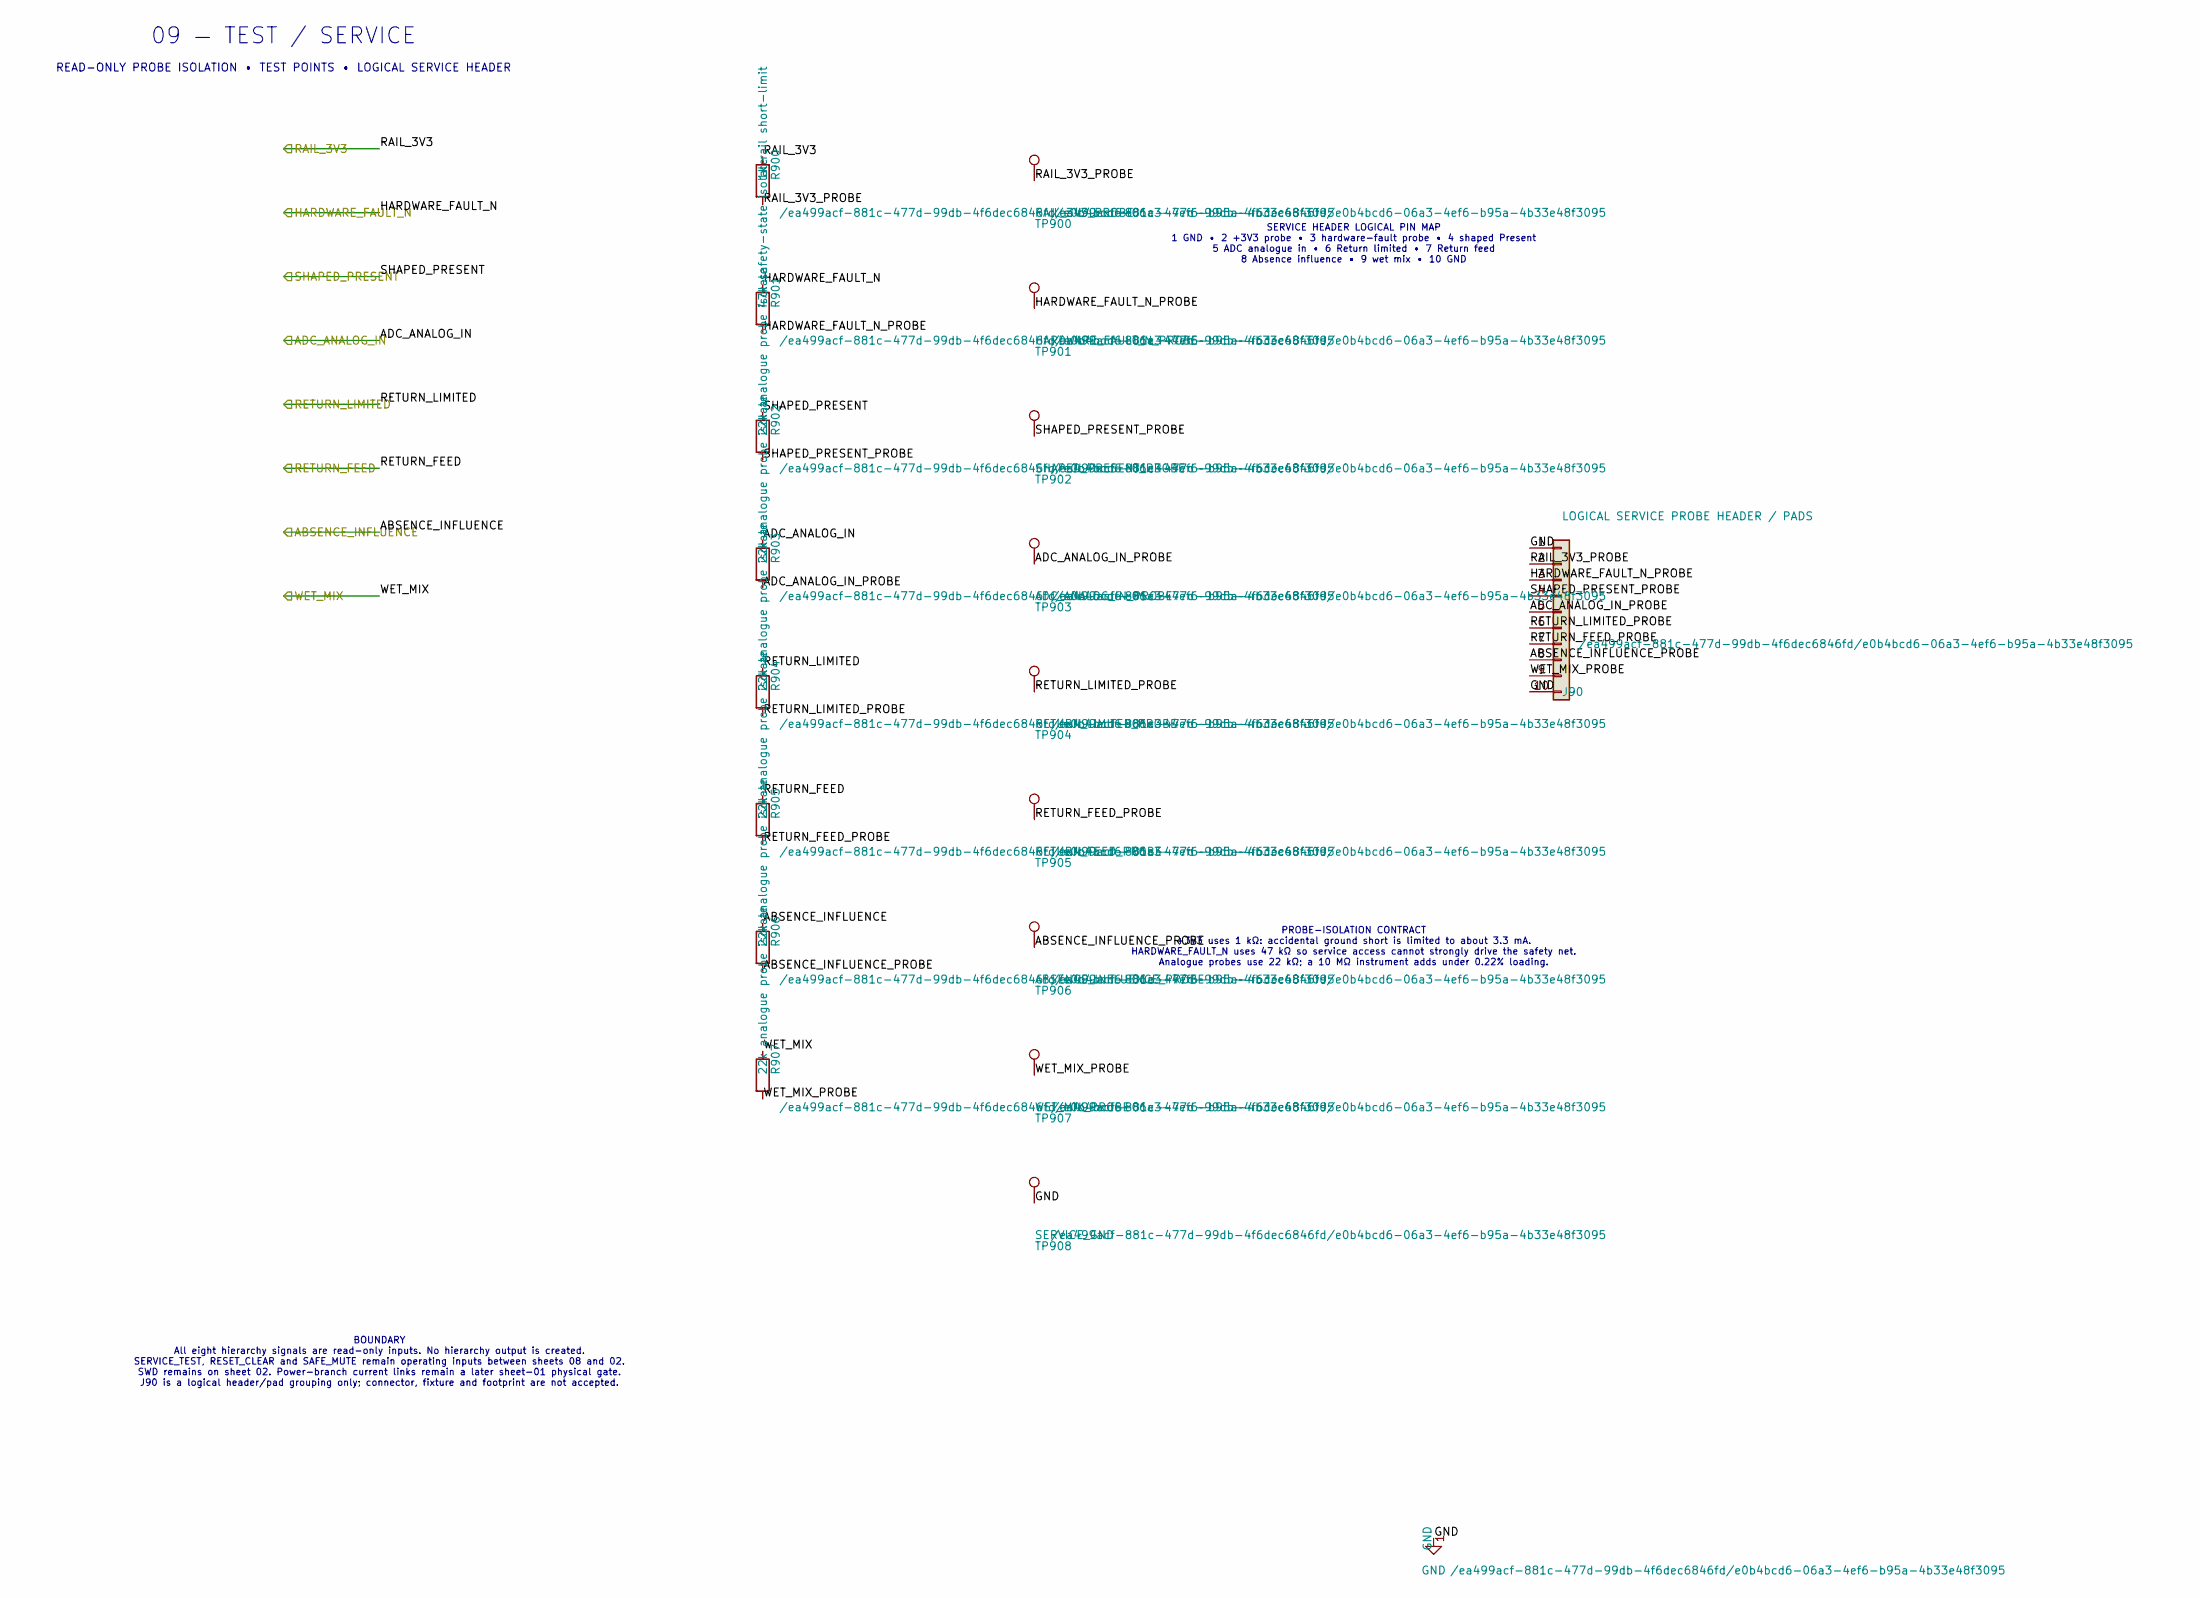
[picture p17: schematic 09_TEST_SERVICE.kicad_sch]

Parts:
J90: LOGICAL SERVICE PROBE HEADER / PADS
R900: 1k rail short-limit; R_0805_2012Metric
R901: 47k safety-state isolate; R_0805_2012Metric
R902, R903, R904, R905, R906, R907: 22k analogue probe isolate; R_0805_2012Metric
TP900: RAIL_3V3_PROBE
TP901: HARDWARE_FAULT_N_PROBE
TP902: SHAPED_PRESENT_PROBE
TP903: ADC_ANALOG_IN_PROBE
TP904: RETURN_LIMITED_PROBE
TP905: RETURN_FEED_PROBE
TP906: ABSENCE_INFLUENCE_PROBE
TP907: WET_MIX_PROBE
TP908: SERVICE_GND

Connections:
ABSENCE_INFLUENCE: R906.1
ABSENCE_INFLUENCE_PROBE: J90.8, R906.2, TP906.1
ADC_ANALOG_IN: R903.1
ADC_ANALOG_IN_PROBE: J90.5, R903.2, TP903.1
GND: J90.1, J90.10, TP908.1
HARDWARE_FAULT_N: R901.1
HARDWARE_FAULT_N_PROBE: J90.3, R901.2, TP901.1
RAIL_3V3: R900.1
RAIL_3V3_PROBE: J90.2, R900.2, TP900.1
RETURN_FEED: R905.1
RETURN_FEED_PROBE: J90.7, R905.2, TP905.1
RETURN_LIMITED: R904.1
RETURN_LIMITED_PROBE: J90.6, R904.2, TP904.1
SHAPED_PRESENT: R902.1
SHAPED_PRESENT_PROBE: J90.4, R902.2, TP902.1
WET_MIX: R907.1
WET_MIX_PROBE: J90.9, R907.2, TP907.1

Notes on the sheet:
09 — TEST / SERVICE
READ-ONLY PROBE ISOLATION • TEST POINTS • LOGICAL SERVICE HEADER
SERVICE HEADER LOGICAL PIN MAP 1 GND • 2 +3V3 probe • 3 hardware-fault probe • 4 shaped Present 5 ADC analogue in • 6 Return limited • 7 Return feed 8 Absence influence • 9 wet mix • 10 GND
PROBE-ISOLATION CONTRACT +3V3 uses 1 kΩ: accidental ground short is limited to about 3.3 mA. HARDWARE_FAULT_N uses 47 kΩ so service access cannot strongly drive the safety net. Analogue probes use 22 kΩ; a 10 MΩ instrument adds under 0.22% loading.
BOUNDARY All eight hierarchy signals are read-only inputs. No hierarchy output is created. SERVICE_TEST, RESET_CLEAR and SAFE_MUTE remain operating inputs between sheets 08 and 02. SWD remains on sheet 02. Power-branch current links remain a later sheet-01 physical gate. J90 is a logical header/pad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
