armpitpete/merrin-voice-01/tools/validate_jack_exact_part_lane.py

#!/usr/bin/env python3
"""Validate the approved-and-merged state of Gate-B lane 02.

J40 and J70 must retain the reviewed numeric WQP518MA footprint, the project
symbol default must remain blank, PR #47 merge authority must be recorded
exactly, and all PCB, panel, purchasing, production and SSI2164 authority must
remain blocked or not started.
"""

from __future__ import annotations

import hashlib
import json
import math
import re
from pathlib import Path

ROOT = Path("hardware/memory-core-prototype-a")
SHEET04 = ROOT / "04_INPUT_PRESSURE_ABSENCE.kicad_sch"
SHEET07 = ROOT / "07_OUTPUT_MUTE_PROTECTION.kicad_sch"
LIBRARY = ROOT / "MerrinLab_PrototypeA.kicad_sym"
FP_TABLE = ROOT / "fp-lib-table"
INPUT_GENERATOR = Path("tools/capture_input_pressure_absence_sheet.py")
OUTPUT_GENERATOR = Path("tools/capture_output_mute_protection_sheet.py")
AUDIT = ROOT / "INPUT_OUTPUT_JACK_AUDIT.json"
REVIEW = ROOT / "INPUT_OUTPUT_JACK_EXACT_PART_REVIEW.md"
CONTRACT = ROOT / "JACK_EXACT_PART_EDIT_CONTRACT.md"
MEASUREMENT = ROOT / "WQP518MA_PANEL_STACK_MEASUREMENT_RECORD.md"
INDEPENDENT_REVIEW = ROOT / "WQP518MA_PANEL_STACK_INDEPENDENT_REVIEW.md"
REGISTER = ROOT / "EXACT_PART_FOOTPRINT_VERIFICATION_REGISTER.md"
SOURCE_FP = (
    ROOT
    / "jack-footprint-audits"
    / "KiCad_Official_Jack_3.5mm_QingPu_WQP-PJ398SM_Vertical_CircularHoles.kicad_mod"
)
NUMERIC_FP = (
    ROOT
    / "MerrinLab_PrototypeA.pretty"
    / "Jack_3.5mm_Thonkiconn_WQP518MA_Numeric.kicad_mod"
)

SOURCE_COMMIT = "7ebfa6b23cc292a56f751b7b5f4a0e12eeef69dd"
SOURCE_BLOB = "6c9440c957bf566ae79058cdab7afabfb86955d8"
SOURCE_SHA256 = "8ae08dd1e353c7fdbea2827c890ecd150e6f5f528598770bec85a8f2422b98cc"
NUMERIC_SHA256 = "e9e095c63fa39dfd306a45755b6e8e9048e795b8592a6eeba3bf6ab734ed3685"
FOOTPRINT_ID = "MerrinLab_PrototypeA:Jack_3.5mm_Thonkiconn_WQP518MA_Numeric"
INDEPENDENT_REVIEW_HEAD = "2d1e58e61b1a04653b17cd666dda2160808079cf"
ASSIGNMENT_COMMIT = "f34eea95c216cd31df4d4e3f1498adc4b9014ec9"
ASSIGNMENT_VALIDATION_HEAD = "bbc54c59152fdab8ac42ad0035a163e2e383c92b"
RESTORED_WORKFLOW_HEAD = "5e07b4657436c19db32ea9651ee68e510df402eb"
REVIEWED_MERGE_HEAD = "ebaf7fbc50f5c07443d329519de0a38622f231b1"
MAIN_SQUASH_COMMIT = "dd306209e9874dd6e9064c33973d99ecf9282690"


def balanced_block(text: str, start: int) -> str:
    depth = 0
    in_string = False
    escaped = False
    for index in range(start, len(text)):
        char = text[index]
        if in_string:
            if escaped:
                escaped = False
            elif char == "\\":
                escaped = True
            elif char == '"':
                in_string = False
            continue
        if char == '"':
            in_string = True
        elif char == "(":
            depth += 1
        elif char == ")":
            depth -= 1
            if depth == 0:
                return text[start : index + 1]
    raise AssertionError(f"Unterminated S-expression at offset {start}")


def sexp_blocks(text: str, token: str) -> list[str]:
    blocks: list[str] = []
    offset = 0
    while True:
        start = text.find(token, offset)
        if start == -1:
            return blocks
        block = balanced_block(text, start)
        blocks.append(block)
        offset = start + len(block)


def instance_blocks(text: str) -> list[str]:
    marker = "\n\t(symbol\n\t\t(lib_id "
    blocks: list[str] = []
    offset = 0
    while True:
        found = text.find(marker, offset)
        if found == -1:
            return blocks
        start = found + 2
        block = balanced_block(text, start)
        blocks.append(block)
        offset = start + len(block)


def field(block: str, pattern: str, description: str) -> str:
    match = re.search(pattern, block)
    assert match, f"Missing {description}"
    return match.group(1)


def instances(path: Path) -> list[dict[str, str]]:
    rows: list[dict[str, str]] = []
    for block in instance_blocks(path.read_text(encoding="utf-8")):
        rows.append(
            {
                "block": block,
                "lib_id": field(block, r'\(lib_id "([^"]+)"', "lib_id"),
                "reference": field(
                    block, r'\(property "Reference" "([^"]+)"', "reference"
                ),
                "value": field(block, r'\(property "Value" "([^"]*)"', "value"),
                "footprint": field(
                    block, r'\(property "Footprint" "([^"]*)"', "footprint"
                ),
            }
        )
    return rows


def one(rows: list[dict[str, str]], reference: str) -> dict[str, str]:
    matches = [row for row in rows if row["reference"] == reference]
    assert len(matches) == 1, (reference, len(matches))
    return matches[0]


def symbol_definition(text: str, name: str) -> str:
    marker = f'\t(symbol "{name}"'
    start = text.index(marker) + 1
    return balanced_block(text, start)


def assert_symbol_pin(block: str, number: str, name: str) -> None:
    assert block.count(f'(number "{number}"') == 1
    assert block.count(f'(name "{name}"') == 1


def parse_pads(
    text: str,
) -> tuple[
    dict[str, tuple[float, float, float, float, float]],
    list[tuple[str, float, float, float]],
]:
    electrical: dict[str, tuple[float, float, float, float, float]] = {}
    npth: list[tuple[str, float, float, float]] = []
    for block in sexp_blocks(text, "(pad "):
        identifier_match = re.match(r'\(pad\s+(?:"([^"]*)"|([^\s]+))', block)
        assert identifier_match, block[:120]
        identifier = identifier_match.group(1)
        if identifier is None:
            identifier = identifier_match.group(2)
        at = re.search(r'\(at\s+([-\d.]+)\s+([-\d.]+)(?:\s+[-\d.]+)?\)', block)
        size = re.search(r'\(size\s+([-\d.]+)\s+([-\d.]+)\)', block)
        drill = re.search(r'\(drill\s+([-\d.]+)\)', block)
        assert at and size and drill, block[:200]
        x, y = (float(value) for value in at.groups())
        sx, sy = (float(value) for value in size.groups())
        diameter = float(drill.group(1))
        if " np_thru_hole " in block:
            npth.append((identifier, x, y, diameter))
        elif " thru_hole " in block:
            electrical[identifier] = (x, y, sx, sy, diameter)
    return electrical, npth


def close(actual: float, expected: float, tolerance: float = 0.001) -> None:
    assert math.isclose(actual, expected, abs_tol=tolerance), (actual, expected)


def assert_pad(
    actual: tuple[float, float, float, float, float], expected: list[float]
) -> None:
    assert len(expected) == 5
    for found, required in zip(actual, expected, strict=True):
        close(found, float(required))


def sha256(path: Path) -> str:
    return hashlib.sha256(path.read_bytes()).hexdigest()


def assert_contains(text: str, tokens: tuple[str, ...], label: str) -> None:
    for token in tokens:
        assert token in text, f"{label} missing: {token}"


def main() -> None:
    required = (
        SHEET04,
        SHEET07,
        LIBRARY,
        FP_TABLE,
        INPUT_GENERATOR,
        OUTPUT_GENERATOR,
        AUDIT,
        REVIEW,
        CONTRACT,
        MEASUREMENT,
        INDEPENDENT_REVIEW,
        REGISTER,
        SOURCE_FP,
        NUMERIC_FP,
    )
    for path in required:
        assert path.exists(), path

    audit = json.loads(AUDIT.read_text(encoding="utf-8"))
    assert audit["schema_version"] == 2

    authority = audit["authority"]
    assert authority == {
        "lane": "Gate B lane 02 — input and output jacks",
        "base_commit": "651d594e3c9993b2fdc6ca527328887458a7d849",
        "lane_status": "APPROVED_AND_MERGED",
        "pr": 47,
        "reviewed_head": REVIEWED_MERGE_HEAD,
        "main_squash_commit": MAIN_SQUASH_COMMIT,
        "pcb_authorised": False,
        "panel_fabrication_authorised": False,
        "purchasing_authorised": False,
        "ssi2164_lane_started": False,
    }

    supplier = audit["supplier_evidence"]
    assert supplier["drawing_model_label"] == "PJ398SM"
    assert supplier["equivalence_scope"] == (
        "SUPPLIER_CONTROLLED_CONTACT_AND_FOOTPRINT_EQUIVALENCE_ACCEPTED"
    )
    assert supplier["manufacturer_controlled_wqp518ma_drawing_found"] is False

    candidate = audit["candidate"]
    assert candidate["exact_orderable_name"] == "WQP518MA"
    assert candidate["contacts"] == {
        "1": "TIP",
        "2": "TIP_NORMAL",
        "3": "SLEEVE",
        "no_plug_state": "contacts 1 and 2 closed",
        "plug_inserted_state": "contacts 1 and 2 open; contact 1 remains plug tip",
    }

    library = LIBRARY.read_text(encoding="utf-8")
    symbol = symbol_definition(library, "WQP518MA_APPLICATION")
    assert_symbol_pin(symbol, "1", "TIP")
    assert_symbol_pin(symbol, "2", "TIP_NORMAL")
    assert_symbol_pin(symbol, "3", "SLEEVE")
    assert '(property "Footprint" ""' in symbol
    assert FOOTPRINT_ID not in library

    rows04 = instances(SHEET04)
    rows07 = instances(SHEET07)
    for row, value in (
        (one(rows04, "J40"), "WQP518MA / THONKICONN INPUT"),
        (one(rows07, "J70"), "WQP518MA / THONKICONN OUTPUT"),
    ):
        assert row["lib_id"] == "MerrinLab_PrototypeA:WQP518MA_APPLICATION", row
        assert row["value"] == value, row
        assert row["footprint"] == FOOTPRINT_ID, row
        assert row["block"].count(FOOTPRINT_ID) == 1, row

    input_generator = INPUT_GENERATOR.read_text(encoding="utf-8")
    output_generator = OUTPUT_GENERATOR.read_text(encoding="utf-8")
    assert_contains(
        input_generator,
        (
            'add_part(sch, "MerrinLab_PrototypeA:WQP518MA_APPLICATION", "J40",',
            'label_pin(sch, "J40", "1", "INPUT_TIP")',
            'label_pin(sch, "J40", "2", "GND")',
            'label_pin(sch, "J40", "3", "GND")',
        ),
        "input generator",
    )
    assert_contains(
        output_generator,
        (
            'add_part(sch, "MerrinLab_PrototypeA:WQP518MA_APPLICATION", "J70",',
            'label_pin(sch, "J70", "1", "OUTPUT_TIP")',
            'sch.no_connects.add(position=pin_position(sch, "J70", "2"))',
            'label_pin(sch, "J70", "3", "GND")',
        ),
        "output generator",
    )
    assert input_generator.count(FOOTPRINT_ID) == 1
    assert output_generator.count(FOOTPRINT_ID) == 1

    use = audit["schematic_use"]
    assert use["J40"]["normal_contact_required"] is True
    assert use["J40"]["pin_1"] == "INPUT_TIP"
    assert use["J40"]["pin_2"] == use["J40"]["pin_3"] == "GND"
    assert use["J70"]["pin_1"] == "OUTPUT_TIP"
    assert use["J70"]["pin_2"] == "NO_CONNECT"
    assert use["J70"]["pin_3"] == "GND"

    source = audit["official_source_footprint"]
    assert source["source_commit"] == SOURCE_COMMIT
    assert source["source_blob_sha"] == SOURCE_BLOB
    assert source["sha256"] == SOURCE_SHA256 == sha256(SOURCE_FP)
    source_pads, source_npth = parse_pads(SOURCE_FP.read_text(encoding="utf-8"))
    assert source_npth == []
    assert set(source_pads) == {"T", "TN", "S"}
    for identifier in ("T", "TN", "S"):
        assert_pad(source_pads[identifier], source["pads"][identifier])

    numeric = audit["project_numeric_footprint"]
    assert numeric["library_id"] == FOOTPRINT_ID
    assert numeric["sha256"] == NUMERIC_SHA256 == sha256(NUMERIC_FP)
    assert numeric["assignment_status"] == "ASSIGNED_TO_J40_J70"
    numeric_pads, numeric_npth = parse_pads(NUMERIC_FP.read_text(encoding="utf-8"))
    assert set(numeric_pads) == {"1", "2", "3"}
    assert numeric_npth == [("", 0.0, 6.48, 3.0)]
    for numeric_id, source_id in {"1": "T", "2": "TN", "3": "S"}.items():
        assert_pad(numeric_pads[numeric_id], numeric["pads"][numeric_id])
        assert numeric_pads[numeric_id] == source_pads[source_id]

    assert '(name "MerrinLab_PrototypeA")' in FP_TABLE.read_text(encoding="utf-8")

    mechanical = candidate["published_mechanical_mm"]
    panel = audit["panel_and_mounting"]
    bushing_max = mechanical["bushing_diameter"] + mechanical["drawing_general_tolerance"]
    hole_min = panel["panel_hole_mm"]["nominal"] - panel["panel_hole_mm"]["minus"]
    radial_clearance = (hole_min - bushing_max) / 2
    close(radial_clearance, panel["minimum_radial_clearance_before_position_error_mm"])
    assert panel["maximum_total_panel_to_jack_axis_offset_target_mm"] < radial_clearance
    close(panel["panel_thickness_target_mm"], 1.6)
    available_thread = mechanical["threaded_bushing_length_shown"] - 1.6
    close(available_thread, 2.9)
    close(available_thread, panel["available_thread_above_panel_before_nut_mm"])
    assert panel["selected_washer"].startswith("NONE")
    assert panel["washer_thickness"].startswith("NOT_APPLICABLE")
    assert panel["hardware_stack_status"] == (
        "INDEPENDENT_REVIEW_APPROVED_AND_FOOTPRINT_ASSIGNMENT_APPLIED"
    )

    attestation = audit["physical_fit_attestation"]
    assert attestation["superseded_attestation_status"] == "WITHDRAWN_WRONG_STACK"
    assert attestation["current_stack"] == (
        "1.60 mm nominal panel plus Thonk hex nut; no washer"
    )
    for key in (
        "bushing_passes_panel_hole_without_forcing",
        "secure_nut_engagement_through_1p60mm_panel",
        "nut_starts_without_cross_threading",
        "nut_clamps_before_bottoming",
        "housing_not_crushed_or_distorted",
        "jack_does_not_rotate_or_wobble",
        "tightening_does_not_lift_or_tilt_soldered_jack",
        "tightening_does_not_load_solder_terminals",
        "pcb_remains_flat",
        "panel_to_pcb_alignment",
        "barrel_relief_3mm_clears_physical_jack",
        "terminal_holes_remain_unobstructed",
    ):
        assert attestation[key] == "PASS", (key, attestation[key])
    assert attestation["exact_sample_measurements_recorded"] is False
    assert attestation["independent_review_status"] == "APPROVED_AND_ASSIGNMENT_APPLIED"

    independent = audit["independent_review"]
    assert independent["reviewed_head"] == INDEPENDENT_REVIEW_HEAD
    assert independent["historical_pre_assignment_state"] == (
        "J40_J70_BLANK_AT_REVIEW_HEAD_ONLY"
    )
    assert independent["footprint_assignment_performed"] is True
    assert independent["assignment_commit"] == ASSIGNMENT_COMMIT
    assert independent["pcb_placement_authorised"] is False
    assert independent["panel_fabrication_authorised"] is False
    assert independent["purchasing_authorised"] is False

    validation = audit["validation"]
    assert validation["assignment_state_validation"]["validated_head"] == (
        ASSIGNMENT_VALIDATION_HEAD
    )
    assert validation["assignment_state_validation"]["result"] == "PASS"
    assert validation["restored_workflow_validation"]["validated_head"] == (
        RESTORED_WORKFLOW_HEAD
    )
    assert validation["restored_workflow_validation"]["result"] == "PASS"
    assert validation["merge_review_validation"] == {
        "validated_head": REVIEWED_MERGE_HEAD,
        "jack_workflow_run": 29421831076,
        "schematic_erc_run": 29421831023,
        "current_stage_authority_run": 29421831021,
        "input_sheet_erc_run": 29421831143,
        "output_sheet_erc_run": 29421831024,
        "final_top_review_run": 29421831213,
        "codec_sheet_erc_run": 29421831322,
        "result": "PASS",
    }
    assert validation["current_head_requirement"] == (
        "POST_MERGE_AUTHORITY_CI_REQUIRED_BEFORE_CLOSURE_MERGE"
    )
    assert validation["footprint_assignment_remained_blank"] is False

    merge = audit["merge_authority"]
    assert merge == {
        "pr": 47,
        "merge_method": "SQUASH",
        "reviewed_head": REVIEWED_MERGE_HEAD,
        "main_squash_commit": MAIN_SQUASH_COMMIT,
        "merged_at": "2026-07-16T08:32:15Z",
        "status": "APPROVED_AND_MERGED",
        "historical_pre_merge_state": "PR47_OPEN_DRAFT_UNMERGED_AT_REVIEW_HEAD_ONLY",
    }

    decision = audit["decision"]
    assert decision["footprints_assigned"] is True
    assert decision["repository_authority"] == "POST_MERGE_CLOSURE_SYNCHRONISED"
    assert decision["panel_release"] == (
        "BLOCKED_PENDING_MATERIAL_SUPPLIER_FINISHED_THICKNESS_HOLE_AND_SEATING_DISTANCE"
    )
    assert decision["overall"] == (
        "LANE_02_APPROVED_AND_MERGED_PENDING_POST_MERGE_AUTHORITY_REVIEW"
    )

    assignment = audit["footprint_assignment"]
    assert assignment == {
        "footprint": FOOTPRINT_ID,
        "J40": "ASSIGNED",
        "J70": "ASSIGNED",
        "project_symbol_default": "BLANK",
        "assignment_commit": ASSIGNMENT_COMMIT,
        "post_assignment_validation": "PASS",
        "pcb_placement_authorised": False,
        "panel_fabrication_authorised": False,
        "purchasing_authorised": False,
    }

    register_text = REGISTER.read_text(encoding="utf-8")
    review_text = REVIEW.read_text(encoding="utf-8")
    measurement_text = MEASUREMENT.read_text(encoding="utf-8")
    contract_text = CONTRACT.read_text(encoding="utf-8")

    assert_contains(
        register_text,
        (
            "STATUS                                      APPROVED AND MERGED",
            "PR                                          #47",
            f"REVIEWED HEAD                               {REVIEWED_MERGE_HEAD}",
            f"MAIN SQUASH COMMIT                          {MAIN_SQUASH_COMMIT}",
            "SSI2164 lane                            NOT STARTED",
        ),
        "verification register",
    )
    assert "COMPLETE — READY FOR MERGE REVIEW" not in register_text
    assert "PR #47 merge                          AWAITING MERGE REVIEW" not in register_text

    assert_contains(
        review_text,
        (
            "PR #47                                      APPROVED AND MERGED",
            "OVERALL                                     APPROVED AND MERGED",
            f"MAIN SQUASH COMMIT                          {MAIN_SQUASH_COMMIT}",
            "PR #47 merge                          COMPLETE",
            "SSI2164 lane                          NOT STARTED",
        ),
        "exact-part review",
    )
    assert "OVERALL                                     READY FOR MERGE REVIEW" not in review_text
    assert "PR #47 remains draft and unmerged" not in review_text

    assert_contains(
        measurement_text,
        (
            "PR #47                                   APPROVED AND MERGED",
            f"MAIN SQUASH COMMIT                       {MAIN_SQUASH_COMMIT}",
            "SSI2164 lane                           NOT STARTED",
            "### Pre-merge review point",
        ),
        "measurement record",
    )
    assert "PR #47 remains draft and unmerged" not in measurement_text

    assert_contains(
        contract_text,
        (
            "PR #47                                 APPROVED AND MERGED",
            f"main squash commit                     {MAIN_SQUASH_COMMIT}",
            "SSI2164 lane                           NOT STARTED",
            "## Superseded states",
        ),
        "edit contract",
    )
    assert "PR #47                                 DRAFT / UNMERGED" not in contract_text
    assert "merge review of PR #47" not in contract_text

    independent_text = INDEPENDENT_REVIEW.read_text(encoding="utf-8")
    assert_contains(
        independent_text,
        (
            f"reviewed head                {INDEPENDENT_REVIEW_HEAD}",
            "CORRECTED 1.60 MM NUT-ONLY PHYSICAL FIT     APPROVED",
            "J40 / J70 FOOTPRINTS                         NOT ASSIGNED BY THIS REVIEW",
            "PCB PLACEMENT / ROUTING                      BLOCKED",
        ),
        "historical independent review",
    )

    print("J40 switched-input and quiet-no-cable contact contract: PASS")
    print("J70 output contact and unused-normal contract: PASS")
    print("Pinned source and numeric footprint geometry: PASS")
    print("Bounded J40/J70 footprint assignment: PASS")
    print("PR #47 reviewed-head and squash-merge authority: PASS")
    print("Project symbol default remains blank: PASS")
    print("Post-merge repository authority synchronised: PASS")
    print("PCB, panel, purchasing and production authority remain blocked: PASS")
    print("SSI2164 lane remains not started: PASS")


if __name__ == "__main__":
    main()
