armpitpete/merrin-voice-01/(commit log)

2026-06-06 Add play voice sample button
2026-06-06 Update README for audio preview button
2026-06-06 Improve v0.5 page flow and bus readability
2026-06-06 Add v0.8 walkthrough stage progress strip
2026-06-06 Update README for v0.8 stage strip
2026-06-06 Link v2.2 controls to teaching stages
2026-06-07 Show pitch in stable oscilloscope view
2026-06-07 Add individual effect test switches
2026-06-08 Add slight pitch drift
2026-06-09 Wire MIDI control into app
2026-06-28 Reframe README limitations as current scope
2026-06-28 Filter MIDI realtime diagnostic overload
2026-06-28 Filter realtime MIDI spam in raw monitor
2026-06-28 Filter duplicate MIDI note events
2026-06-28 Count and filter duplicate raw MIDI events
2026-06-28 Filter MIDI notes by selected scale
2026-07-11 Add V4.0 whole synth build spec
    Define V4.0 as the whole-synth specification lane for Merrin Grief Synth.
    - Add the V4.0 whole synth build spec.
    - Reframe the roadmap so final demo media comes after whole-synth acceptance.
    - Preserve the current browser Constrained Grief voice as the proven foundation.
    - Keep this lane documentation-only with no code, sound, control, plugin, VCV, sequencer, MIDI-output, or demo expansion.
2026-07-11 Keep diagnostics mounted in advanced layer
2026-07-11 Frame V4.1 as hardware-prep layout work
2026-07-11 V5.0 — Hardware Translation Spec
    Lock the hybrid Memory–Ghost–Return architecture, SMD-first construction, Thonkiconn connector family, Prototype A boundary, and V5.1 handoff.
2026-07-11 V5.1 — Memory Core Prototype A circuit-block design
    Lock circuit-block boundaries, signal targets, conversion channels, bounded Return safety, reset/mute states, test points, SMD zones, Thonkiconn roles, and bench acceptance.
2026-07-11 V5.2 — Prototype A component architecture
    Lock Prototype A major components, package targets, memory/clock/power architecture, WQP518MA jacks, schematic hierarchy, safety boundaries, and the component-risk closure register.
2026-07-11 V5.2 — Schematic capture preparation registers
    * Add V5.2 schematic capture preparation review
    * Add MCU pin allocation register
    * Add PCM3168A clock and interface proof
    * Add power and analogue preflight register
2026-07-11 V5.2 — MCU pin and PCM3168A configuration proof
    * Close Prototype A MCU pin allocation
    * Close PCM3168A clock and configuration contract
    * Add MCU and codec configuration cross-check
    * Close MCU pin and codec configuration risks
    * Update roadmap for MCU pin and codec proof
2026-07-11 V5.2 — Power and analogue safety calculations
    Accept Prototype A power, fail-safe control, watchdog, Return-limiter, op-amp allocation, and Thonkiconn evidence while keeping PCB and purchasing blocked.
2026-07-14 V5.2: capture and validate Memory Core Prototype A schematic
    Capture the nine-sheet native KiCad hierarchy for Memory Core Prototype A,
    validate shared devices and restricted boundaries, complete the integrated
    00_TOP review, and retain explicit footprint, bench, PCB and production gates.
    [01_POWER_PROTECTION.kicad_sch, 02_MCU_CLOCK_DEBUG.kicad_sch, 03_CODEC_CONVERSION.kicad_sch, 04_INPUT_PRESSURE_ABSENCE.kicad_sch, 05_MEMORY_GHOST_WET.kicad_sch, 06_RETURN_BREAK_LIMITER.kicad_sch, 07_OUTPUT_MUTE_PROTECTION.kicad_sch, 08_CONTROLS_STATE.kicad_sch]
2026-07-14 V5.3: verify sheet 07 output mute exact parts
    Verify the Q70 MMBFJ113, Q71 PMV20XNE and U70 VO617A-3X007T physical pin maps, package mappings and powered healthy-release fail-mute topology.
    Pin the accepted project-local KiCad footprint geometry to an immutable upstream revision, independently validate all three package mappings, and qualify the calculated electrical claims to their datasheet conditions.
    Measured and full-temperature behaviour remains Gate C. PCB placement, routing, fabrication and purchasing remain blocked.
    [07_OUTPUT_MUTE_PROTECTION.kicad_sch]
2026-07-16 V5.4 — Verify input and output jack exact parts (#47)
    Accept the WQP518MA/PJ398SM contact and PCB-footprint geometry, add the numeric project-local jack footprint, assign it to J40 and J70, preserve the blank project-symbol default, record the corrected 1.60 mm nut-only fit, and retain all PCB, panel and purchasing blocks.
    [04_INPUT_PRESSURE_ABSENCE.kicad_sch, 07_OUTPUT_MUTE_PROTECTION.kicad_sch]
2026-07-16 Permit required shared-device validator repairs
2026-07-25 Implement validated SSI2164 buffered control
    [05_MEMORY_GHOST_WET.kicad_sch, 06_RETURN_BREAK_LIMITER.kicad_sch]
